G-Wiley/RK05_Emulator_Tester_System_v1/T1_M930GW_Terminator_Board/M930GW_Terminator_Board_v0/photos_and_images/M930GW v0 photo front.jpg

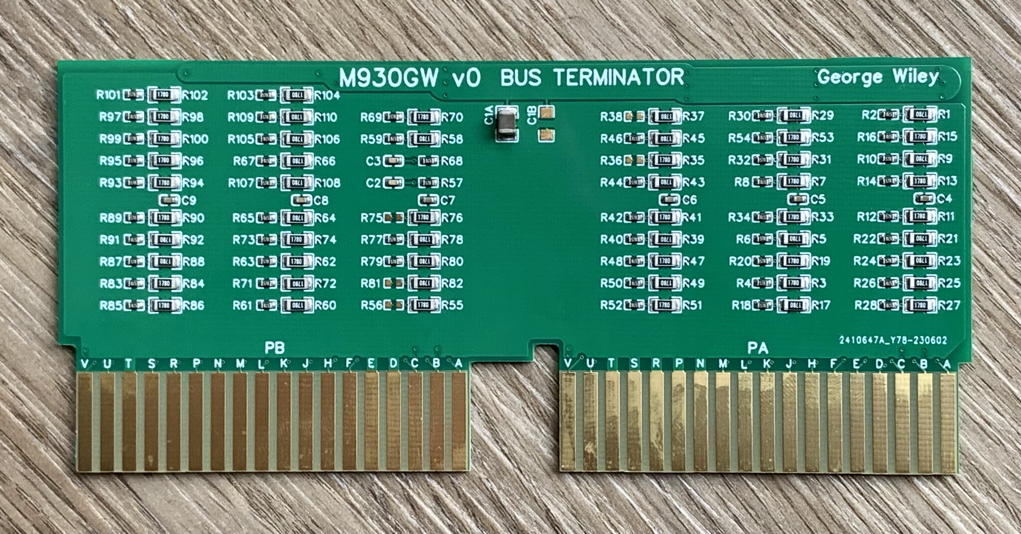
T1_M930GW_Terminator_Board/M930GW_Terminator_Board_v0/photos_and_images/M930GW v0 photo front.jpg
