G-Wiley/RK05_Emulator_Tester_System_v1/README.md

# RK05 Emulator and Tester System
The RK05 Emulator and Tester System
