G-Wiley/RK05_Emulator_Tester_System_v1/A7_RK05_Emulator_Power_Supply/README.md

# RK05 Emulator Power Supply

The RK05_Emulator_Power_Supply PCB is UPN 107 in the Bill of Materials.
