G-Wiley/RK05_Emulator_Tester_System_v1/Setting up the emulator.pdf

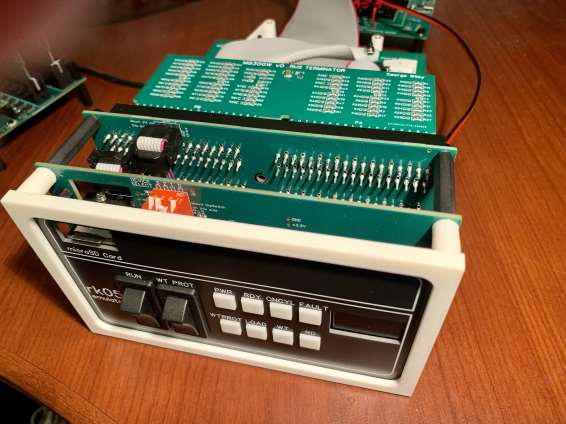
[picture p3: figure]

Seng up the emulator v04.docx | Page 1

Connecng the emulator to the Disk Controller:
- The order of the following setup steps isn’t important except to turn the power on as the last step.
- Plug in the terminator board and the RK05 bus interface cable. The two RK05 bus slots on the emulator are electrically the same so either board can go in either slot. The component side faces up. It’s easier to access the Adapter Board when the terminator board is installed in the top slot.

There is a keying slot between the two sets of gold contact fingers on both the terminator board and on the cable. There is a guide on the emulator main board silkscreen that shows the proper orientaon of this keying slot.
Silkscreen guide, corresponds to the keying slot

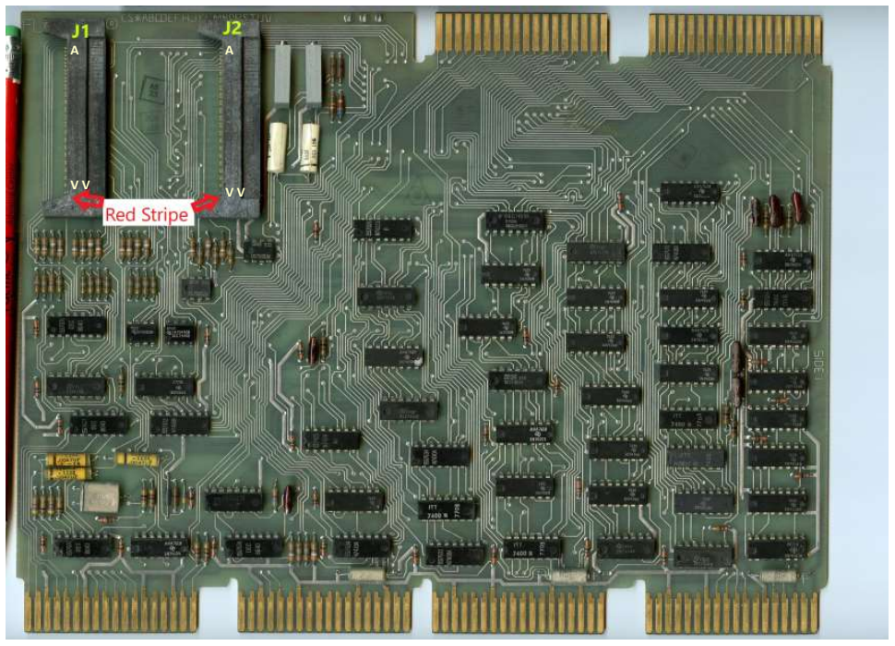
[picture p4: figure]

Seng up the emulator v04.docx | Page 2
- Connect the loose end of the flat cables from the M993GW Adapter Board to the DEC RK8-E M7106 connectors J1 and J2. Connect the flat cable from J1 on the M993GW Adapter Board to J1 on the M7106. Similarly, connect the flat cable from J2 on the M993GW adapter card to J2 on the M7106. It is helpful to use a permanent marker or other means to label the flat cables with “J1” and “J2” so it is clear which cable goes to which connector. If connecng to a DEC RK8-E, then the keying tabs on the flat cable connectors should be sanded off so they will fit into the DEC Berg connectors. A Dremel tool or sharp pair of flush cut diagonal cuers can also be used to remove the keying tabs. The pin numbering alignment is strange, as shown in the photo: 3M connector pin 1 (red stripe) corresponds to Berg pin VV, and 3M pin 40 corresponds to Berg pin
A. If the flat cables are connected to a Plessey PM-DC/8 controller then it is not necessary to sand off the keying tabs on the flat cables because the right-angle headers on the Plessey controller have corresponding keying slots.

DEC RK8-E

A

A

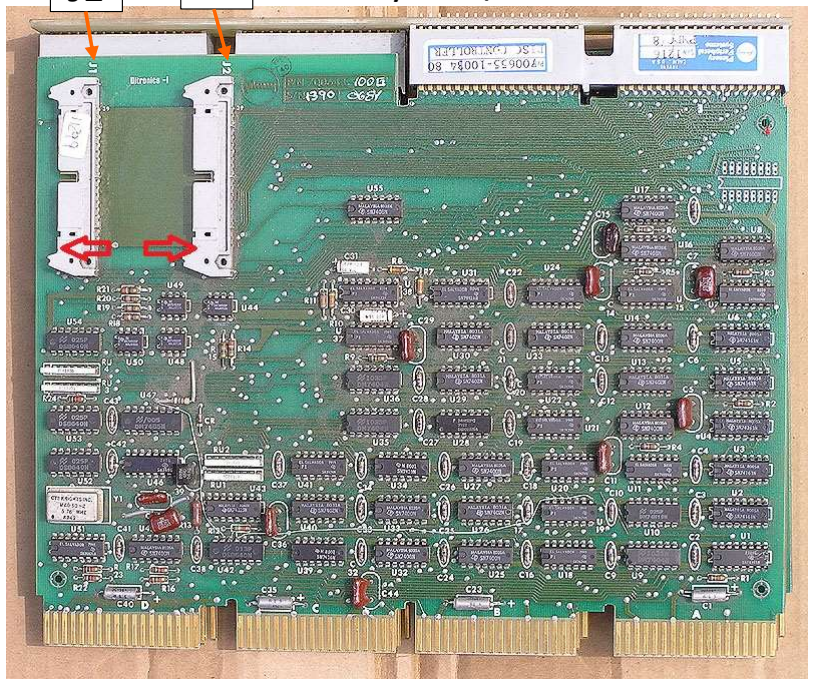
[picture p5: figure]

Seng up the emulator v04.docx | Page 3
- The Plessey PM-DC/8 has J1 and J2 clearly labelled on the silkscreen. Red arrows in the photo show the orientaon of the red stripe on the cable. The keying slots on the controller board headers and keying ribs on the cables also ensure that the orientaon of the cables and red stripe are correct.

Plessey PM-DC/8

J1 J2

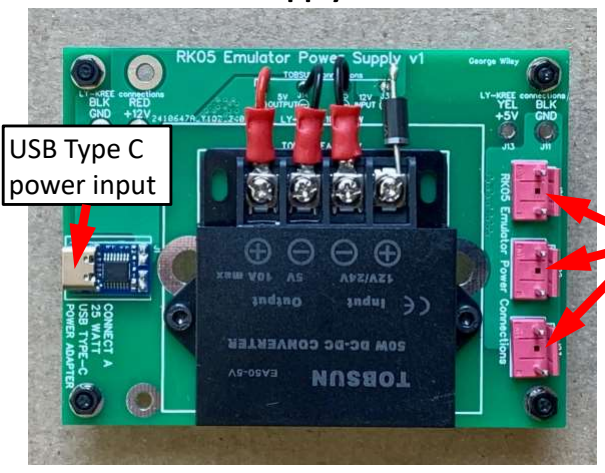
[picture p6: figure]
USB Type C power input
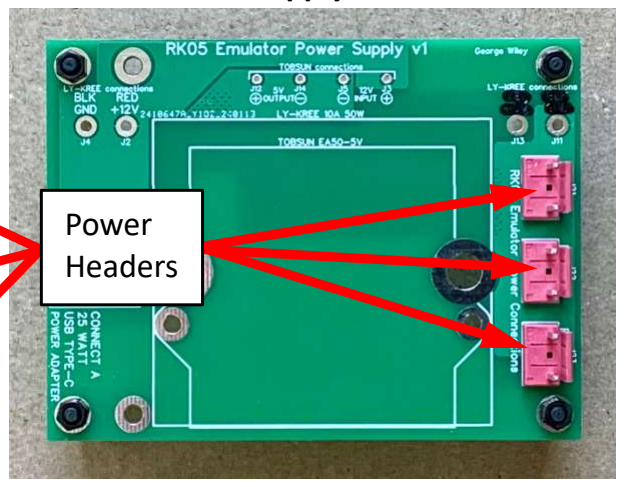
[picture p7: figure]
Power Headers
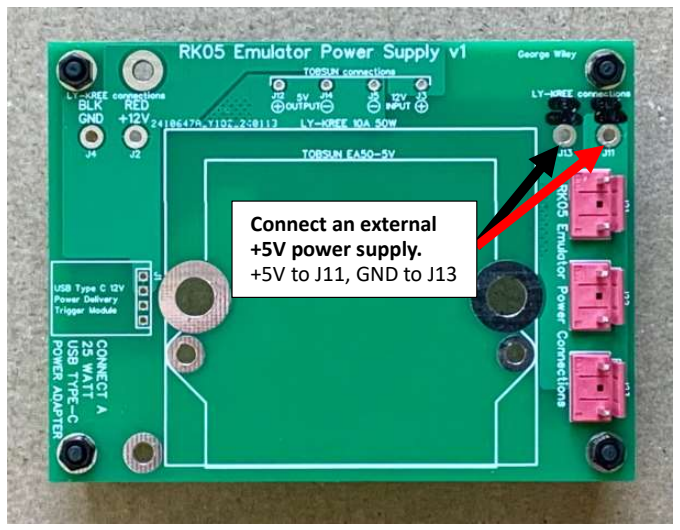
[picture p8: figure]
Connect an external +5V power supply. +5V to J11, GND to J13

Seng up the emulator v04.docx | Page 4
- Connect one end of the red/black power cable to the power header on the emulator. Connect the other end of the power cable to any one of the three power headers on either the Emulator Power Supply With Converters or Emulator Power Supply Without Converters. Up to three emulators can be powered from a single Power Supply.
Emulator Power Supply | Emulator Power Supply without Converters
- When using the Emulator Power Supply, connect a 25 wa USB Type C power module to the USB Type C connector on the Emulator Power Supply. Emulator Power Supply version v2 and higher have a power input switch located near the USB connector.
- When using the Emulator Power Supply without Converters, connect a user-provided 5-volt power supply to J11 (+5V) and J13 (GND).
- The following are important:
o Take care to observe the proper polarity when connecng the external supply.
o It is recommended to connect a red wire to J11 and a black wire to J13 as a guide to not mix up the polarity.
o Make a secure connecon to the Power Supply Board and to the external power supply.

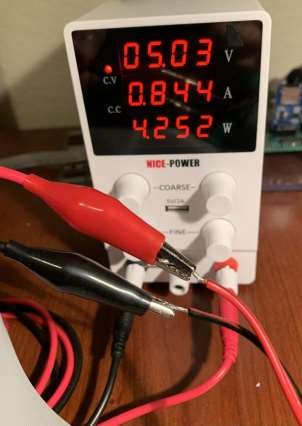
[picture p9: figure]

Seng up the emulator v04.docx | Page 5

o Use wire with a sufficiently large wire diameter to minimize voltage drop between the external power supply and the Power Supply Board.
o Verify the polarity using a voltmeter before connecng the RK05 Emulators to the Power Supply Board.
- Connect the other end of the wires from the Power Supply Board Without Converters to a +5V supply. One emulator with a terminator installed consumes about 900 mA when idle or 1000 mA while running (with lots of disk transfer acvity).

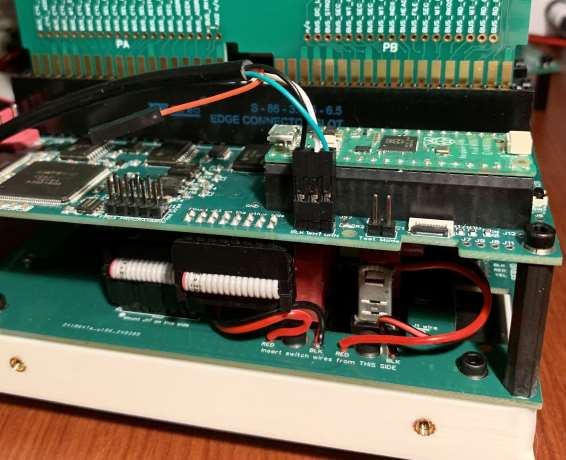
[picture p10: figure]

Seng up the emulator v04.docx | Page 6
- If it is necessary to observe the emulator event log data, then connect the USB serial cable as shown. The black wire is GND, white is TX, green is RX. The red wire on the cable is unconnected. The silkscreen on the main board indicates which wire color should connect to each of the three pins. Either a 5 volt or 3.3 volt USB serial cable can be used. With USB side of the serial cable plugged into in the computer, set your terminal emulator to use whichever COM port is assigned to the cable. Tip: bring up the Windows Device Manager first, then plug the USB cable into the computer to observe which COM port was just assigned when the USB serial cable was inserted. Baud rate is 460,800 bits per second, 8 bits, no parity. The high data rate is used so the serial port can keep up when logging sector reads and writes when the logging mode is selected.
- Set the RUN/LOAD switch on the front panel of the emulator to the “LOAD” posion.
- Turn on the external +5V power if the Power Supply Board Without Converters is being used or plug in the USB Type C charger and turn on the on-board power switch if the Power Supply Board with Converters is being used.
Using the Emulator:
- Insert a microSD card into the microSD slot accessible through the front panel. The card must have a valid rk05 file with an “rk05” file extension at the root level. Example rk05 files are provided in the emulator repository on github.
- The Drive Address can be set using the 4-posion dipswitch located behind the front panel. The dipswitch is idenfied as “DEVICE SELECT” on the board silkscreen next to the dipswitch. The individual switches are idenfied as 0 through 3 on the silkscreen. Switches 0 through 2 are a 3-bit binary drive address value. The selected Drive Address immediately appears in the OLED display on the front panel. The Drive Address seng is effecve only when the emulator is in the “LOAD” state.

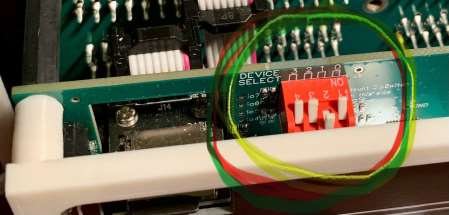
[picture p11: figure]

Seng up the emulator v04.docx | Page 7
- The following example shows the switches set to address 2. The switch on the right has binary weight of 2⁰

, the next switch to the le which is in a different state than the other switches is 2¹ ,
the next switch to the le is 2

2
, and the switch on the far le selects fixed mode (which is not yet implemented).

Although some drives use one-hot enables to select the drive, this address switch is always a binary representaon of the drive address. The large digit in the front panel display confirms the address that was selected.
- Aer the RUN/LOAD switch is turned to the RUN posion, the emulator will ignore the state of the dipswitches. Only drive addresses 0 through 3 are valid for PDP-8 RK8-E mode which uses individual select signals on the disk bus. Drive addresses 0-7 can be used in RK11-D/E modes which use a binary-encoded drive address on the disk bus. The disk controller drives a signal on the disk bus to select the proper mode for the controller. The most significant switch, switch 3, (the switch on the le) enables RK05f mode. RK05f mode is not yet supported; the proper double-address will appear in the display but the FPGA and soware do not yet support this mode. This is a planned future upgrade.
- Flip the RUN/LOAD switch to the “RUN” posion. The emulator will read the rk05 disk image file from the card and store the data in the emulator’s DRAM. Progress of reading the file will appear in the display. When the enre file has been read, the front panel LEDs will update to indicate RDY and ONCYL.
- To observe a log of RK05 bus events such as Seek, Restore, Read and Write: type “L” on the aached terminal (commands are case insensive). To stop logging type “S”. There is a bug which may cause the emulator to lock up aer receiving 5,000 to 10,000 bus events while logging. This problem does not occur when logging is off.
- To unload and save data from the emulator DRAM back to the microSD card, flip the RUN/LOAD switch back to the LOAD posion. Progress of wring the file will appear in the display. When the enre file has been wrien, the front panel LEDs will update to indicate LOAD.
- If there is an error, then it will show in the emulator front panel display and on the aached terminal and the ERROR LED will flash. The flashing error indicator can be cleared by first holding the WTPROT switch and then toggle the state of the RUN/LOAD switch.
