G-Wiley/RK05_Emulator_Tester_System_v1/A7_RK05_Emulator_Power_Supply/RK05_Emulator_Power_Supply_v1/RK05_Emulator_Power_Supply_v1_schematic.pdf

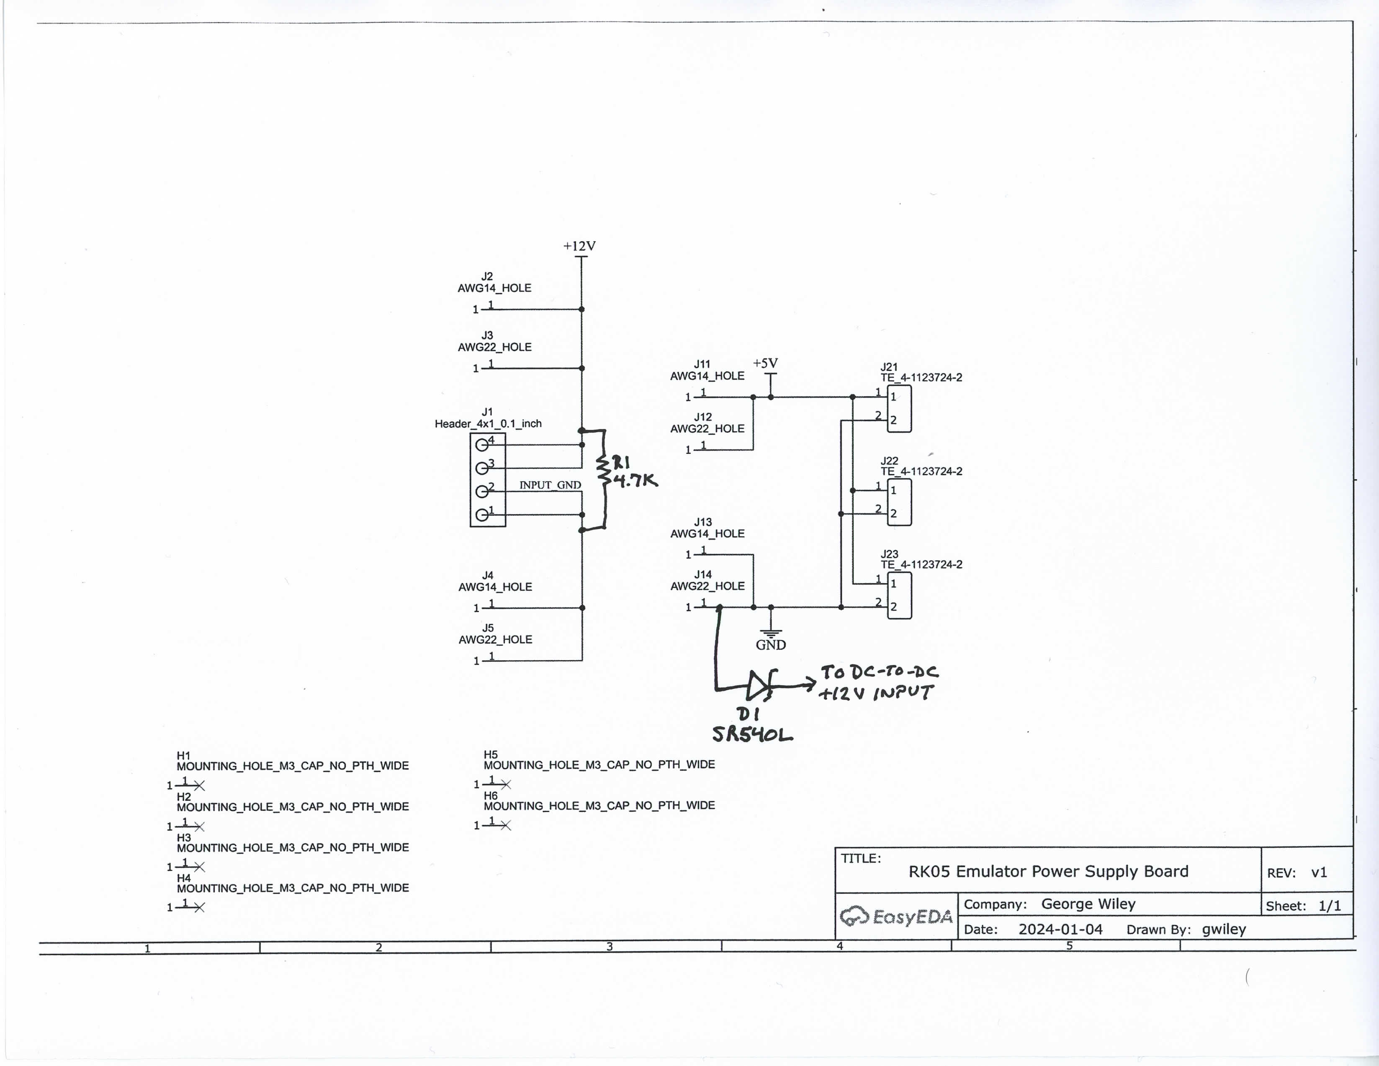
[picture p31: page 1]
