G-Wiley/RK05_Emulator_Tester_System_v1/E1_RK05_Emulator_Tester/Board_Front_Panel/RK05_Front_Panel v3/DNI_Components_Front_Panel_Electronics_v3_board_v00.txt

RK05 Emulator Front Panel Electronics v3, parts not added to BOM
Schematic Page 1
J1
J2
J3
J4
J6
J7 (3-pin header, servo)
J9
J10
J11
J12
J13
J14
J15
J16
J17 (16-pin header, main board)
H1 to H14
R6
R18
SW2
U5 (display module)
