G-Wiley/RK05_Emulator_Tester_System_v1/E1_RK05_Emulator_Tester/3D_printed_parts/204_sd_card_carrier_secondary_ops.pdf

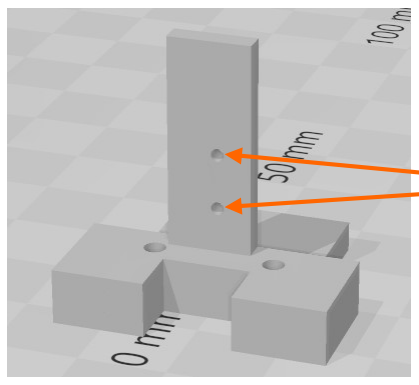
[picture p36: figure]
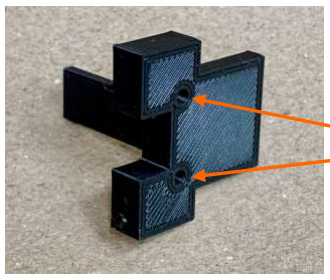
[picture p37: figure]
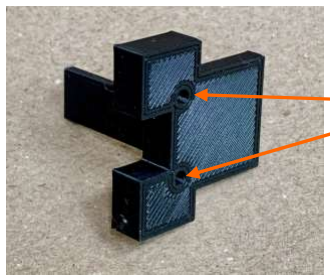
[picture p38: figure]

204_sd_card_carrier_secondary_ops_v00.docx | page 1

Secondary operations, microSD Card Carrier

After 3D printing, the microSD Card Carrier, item 204, needs the following secondary operations to be the fully completed part that can be attached to the front panel assembly.
- Drill holes in the 3D printed piece in 2 places to produce a finished hole size of 3.2 mm.
- Drill holes in the 3D printed piece in 2 places to produce a finished hole size of 3.0 mm. It is better to drill these holes from the flat surface most visible in the image below.
- Heat-stake M2 Threaded Inserts (UPN 311) in holes in the 3D printed piece in 2 places. A soldering iron set to 350° C with a pointed tip or a heat-staking tip can be used to gently press the threaded inserts into place.

Drill for 3.2 mm finished hole size.

Drill for 3.0 mm finished hole size.

Heat-stake M2 Threaded Inserts (UPN 311).
