G-Wiley/RK05_Emulator_Tester_System_v1/E1_RK05_Emulator_Tester/3D_printed_parts/205_M993_Cable_Clamp_secondary_ops.pdf

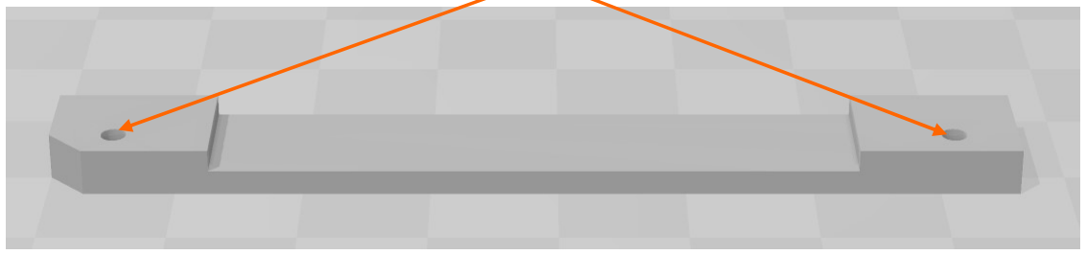
[picture p39: figure]

205_M993_Cable_Clamp_secondary_ops_v00.docx | page 1

Secondary operations, Cable Clamp

After 3D printing, the Cable Clamp, item 205, needs the following secondary operations to be the fully completed part that can be installed on the M993GW RK05 Adapter Board.
- Drill holes in the 3D printed piece in 2 places to produce a finished hole size of 3.2 mm.

Drill for 3.2 mm finished hole size.
