G-Wiley/RK05_Emulator_Tester_System_v1/RK05 emulator bill of materials v1 BOM inventory v09a.xlsx

Sheet: Bill of Materials
 |  |  |  | Qty | UPN |  |  | Description | Ver | Manufacturer | Manufacturer's part number | Supplier | Link | cost ea | ext cost
RK05 Emulator/Tester |  |  |  |  |  |  |  |  |  |  |  |  |  |  | TOTAL
E1 | RK05 Emulator/Tester |  |  |  |  |  |  |  |  |  |  |  |  |  | Emulator/Tester Total | $83.90 | $84
 |  |  |  | Qty | UPN |  | bag | Description | Ver | Manufacturer | Manufacturer's part number | Supplier | Link | cost ea | ext cost
 | RK05 Emulator Top Level Assembly |  |  |  |  |  |  |  |  |  |  |  |  |  |  | $17.454
 |  |  |  | 1 | 200 |  | A | RK05 Lamp Lens, 3D printed | v03 |  | 200 v03 | JLCPCB | 200 v03, SLA (Resin), LEDO 6060, Natural White | $1.697 | $1.697
 |  |  |  | 1 | 201 |  | B | RK05em Bezel, 3D printed | v05 |  | 201 v05 | JLCPCB | 201 v05, FDM (Plastic), PLA, White | $4.992 | $4.992
 |  |  |  | 1 | 207 |  | A | Light Shield, 3D printed | v00 |  | 207 v03 | JLCPCB | 207 v03, SLA (Resin), LEDO 6060, Natural White + blk paint | $0.425 | $0.425
 |  |  |  | 1 | 103 |  | C | RK05 Emulator Dress Panel | v00 |  |  | JLCPCB | Surface Finish: LeadFree HASL | $3.133 | $3.133
 |  |  |  | 6 | 300 |  | B | Threaded Insert, M3 x L=6 x OD=4.5 |  |  |  | AliExpress | https://www.aliexpress.us/item/3256805885174058.html | $0.037 | $0.222
 |  |  |  | 0 | 301 |  | D | M3 Threaded Spacer, hex, nylon, black, 25mm + 6mm, female-male |  |  |  | AliExpress | https://www.aliexpress.us/item/3256804121267045.html | $0.081 | $0.000
 |  |  |  | 4 | 369 |  | D | M3 Threaded Spacer, hex, nylon, black, 30mm + 6mm, female-male |  |  |  | AliExpress | https://www.aliexpress.us/item/3256804121267045.html | $0.099 | $0.397
 |  |  |  | 1 | 303 |  | A | Rocker switch, on-mom |  |  | R4EBLKBLKEF0 | Digikey | https://www.digikey.com/en/products/detail/e-switch/R4EBLKBLKEF0/1805289 | $2.065 | $2.065
 |  |  |  | 1 | 304 |  | A | Rocker switch, on-off |  |  | R4ABLKBLKEF0 | Digikey | https://www.digikey.com/en/products/detail/e-switch/R4ABLKBLKEF0/1805255 | $1.356 | $1.356
 |  |  |  | 4 | 331 |  | D | M3 screw, hex, 8 mm, black |  |  |  | AliExpress | https://www.aliexpress.us/item/3256805242052170.html | $0.035 | $0.139
 |  |  |  | 4 | 332 |  | D | M3 split lockwasher |  |  |  | Amazon | https://www.amazon.com/gp/product/B07Z2FJ2XW | $0.022 | $0.086
 |  |  |  | 1 | 347 |  | N | Flat Cable, 8-pin 2x4 IDC, 10cm |  |  |  | AliExpress | https://www.aliexpress.us/item/3256803248238815.html | $1.170 | $1.170
 |  |  |  | 1 | 348 |  | N | Flat Cable, 16-pin 2x8 IDC, 10cm |  |  |  | AliExpress | https://www.aliexpress.us/item/3256803248238815.html | $1.330 | $1.330
 |  |  |  | 10 | 364 |  | - | 3" x 5" Small Plastic Bags- Reclosable Zip Bags |  |  |  | Amazon | https://www.amazon.com/gp/product/B07XBF98NV | $0.019 | $0.194
 |  |  |  | 1 | 368 |  | - | Ziplock Sandwich Bag |  |  |  | Costco |  | $0.000 | $0.000
 | Tray Rack Mount Kit for Emulator
 |  |  |  | 2 | 358 |  | L | Fender Washer, M3x16x1.0 mm |  |  |  | AliExpress | https://www.aliexpress.us/item/3256802393168670.html | $0.068 | $0.135
 |  |  |  | 2 | 331 |  | L | M3 screw, hex, 8 mm, black |  |  |  | AliExpress | https://www.aliexpress.us/item/3256805242052170.html | $0.035 | $0.069
 |  |  |  | 2 | 332 |  | L | M3 split lockwasher |  |  |  | Amazon | https://www.amazon.com/gp/product/B07Z2FJ2XW | $0.022 | $0.043
 | Emulator Main Board |  |  |  |  |  |  |  |  |  |  |  |  |  |  | $50.654
 |  |  |  | 1 | 341 | J14 | E | CONN HEADER VERT 2x4 Pos, 2.54mm |  |  |  | AliExpress | https://www.aliexpress.us/item/3256805773340189.html | $0.068 | $0.068
 |  |  |  | 1 | 342 | J13 | E | CONN HEADER VERT 2x8 Pos, 2.54mm |  |  |  | AliExpress | https://www.aliexpress.us/item/3256805773340189.html | $0.129 | $0.129
 |  |  |  | 1 | 345 | J1 | E | CONN HEADER VERT 2x5 Pos, 2.54mm |  |  |  | AliExpress | https://www.aliexpress.us/item/3256805773340189.html | $0.081 | $0.081
 |  |  |  | 2 | 344 | U22A, U22B | E | Connector, 20-pin single row, socket strip, 2.54mm |  |  |  | AliExpress | https://www.aliexpress.us/item/3256803424019097.html | $0.512 | $1.024
 |  |  |  | 1 | 309 | U22 | P | Raspberry Pi Pico H (SC0917), with pre-soldered headers |  |  |  | Digikey | https://www.digikey.com/en/products/detail/raspberry-pi/SC0917/16608257 | $6.087 | $6.087
 |  |  |  | 1 | 310 |  | E | Single Row 40 Pin 2.54 mm Male Pin Header Connector, cut to 3 pins |  |  |  | Amazon | https://www.amazon.com/gp/product/B06XR8CV8P | $0.016 | $0.016
 |  |  |  | 1 | 340 | J3 | E | CONN HEADER VERT 3POS, 3.96MM |  | TE Connectivity AMP Connectors | 4-1123724-2 | Digikey | https://www.digikey.com/en/products/detail/te-connectivity-amp-connectors/4-1123724-2/5439777 | $0.148 | $0.148
 |  |  |  | 1 | 338 |  | G' | Antistatic bag, 15x20 cm |  |  |  | Amazon | https://www.amazon.com/dp/B07TXD47PZ | $0.166 | $0.166
 |  |  |  | 1 | 367 |  | P' | Antistatic bag, 6x9 cm |  |  |  | AliExpress | https://www.aliexpress.us/item/3256802834769879.html | $0.085 | $0.085
 |  | Modified edge connector
 |  |  |  | 2 | 313 | J7, J8 | M | edge connector, 1PCS, 3.175mm, 2x43 86 pin |  |  |  | AliExpress | https://www.aliexpress.us/item/2255801094078491.html | $3.371 | $6.742
 |  |  |  | 1 | 202 |  | E | RK05em connector filler/shim, 3D printed | v05 |  | 202 v05 | JLCPCB | 200 v03, SLA (Resin), LEDO 6060, Natural White | $1.070 | $1.070
 |  | Emulator Main Board Assembled
 |  |  |  | 1 | 100 |  | G | Emulator Main Board assembled | v1 |  |  | JLCPCB | Surface Finish: LeadFree HASL | $33.939 | $33.939
 |  | Main Board Power Cable
 |  |  |  | 2 | 312 |  | E | connector, 3-pin, 3.96 EP PLUG HSG 3P(BLACK) |  | TE Connectivity AMP Connectors | 5-1123722-3 | Digikey | https://www.digikey.com/en/products/detail/te-connectivity-amp-connectors/5-1123722-3/10467997 | $0.099 | $0.199
 |  |  |  | 4 | 339 |  | E | CONN SOCKET Pin, 18-22AWG, crimp tin |  | TE Connectivity AMP Connectors | 1123721-2 | Digikey | https://www.digikey.com/en/products/detail/te-connectivity-amp-connectors/1123721-2/686921 | $0.176 | $0.706
 |  |  |  | 1 | 346 |  | E | 22AWG 2 Conductor, Low-Voltage Tinned-Copper Wire, 12-inch (30.5 cm) |  |  |  | Amazon | https://www.amazon.com/dp/B07SCJ69H4 | $0.196 | $0.196
 | Emulator Front Panel Board |  |  |  |  |  |  |  |  |  |  |  |  |  |  | $15.792
 |  |  |  | 2 | 315 |  | F | M2 x 8mm screw, steel |  |  |  | Amazon | https://www.amazon.com/gp/product/B01M5DVI7A | $0.090 | $0.179
 |  |  |  | 1 | 342 |  | H | CONN HEADER VERT 2x8 Pos, 2.54mm |  |  |  | AliExpress | https://www.aliexpress.us/item/3256805773340189.html | $0.129 | $0.129
 |  |  |  | 1 | 317 |  | H | dipswitch, right angle, 4-switch piano type |  | ALINSIN STORE |  | AliExpress | https://www.aliexpress.us/item/3256803055482916.html | $0.435 | $0.435
 |  |  |  | 2 | 318 |  | H | 22AWG 2 Conductor, Low-Voltage Tinned-Copper Wire, 3.5 inch |  |  |  | Amazon | https://www.amazon.com/dp/B07SCJ69H4 | $0.057 | $0.114
 |  |  |  | 4 | 319 |  | H | Nylon Flag Spade Quick Disconnect, 22-18 AWG |  |  |  | Amazon | https://www.amazon.com/dp/B0C625XHQM | $0.086 | $0.344
 |  |  |  | 1 | 343 |  | H | Connector, 4-pin single Row, socket strip, 2.54mm |  |  |  | AliExpress | https://www.aliexpress.us/item/3256803424019097.html | $0.099 | $0.099
 |  |  |  | 0 | 321 |  | F | M2 Phillips Round Pan Head Machine Screws (M2 x 4mm), Stainless Steel |  |  |  | Amazon | https://www.amazon.com/gp/product/B07HFYZ9YM | $0.086 | $0.000
 |  |  |  | 2 | 322 |  | F | M2 split lockwasher |  |  |  | Amazon | https://www.amazon.com/gp/product/B09LLZHY87 | $0.023 | $0.045
 |  |  |  | 1 | 323 |  | H | OLED display module, 128x64, 0.96 inch |  |  |  | AliExpress | https://www.aliexpress.us/item/3256805094941943.html | $1.605 | $1.605
 |  |  |  | 2 | 324 |  | F | M2 Threaded Spacer, hex, nylon, black, 10mm, female-female |  |  |  | AliExpress | https://www.aliexpress.us/item/3256805464087324.html | $0.045 | $0.089
 |  |  |  | 2 | 325 |  | F | M2 nylon flat washer |  |  |  | Amazon | https://www.amazon.com/uxcell-Insulating-Washers-Gaskets-Spacers/dp/B01N6B5KJN | $0.038 | $0.075
 |  |  |  | 8 | 326 |  | F | M3 Threaded Spacer, hex, nylon, black, 12mm, female-female |  |  |  | Amazon | https://www.amazon.com/gp/product/B072LGMRVD | $0.068 | $0.540
 |  |  |  | 8 | 327 |  | F | M3 screw, hex, 6 mm, black |  |  |  | AliExpress | https://www.aliexpress.us/item/3256805242052170.html | $0.030 | $0.238
 |  |  |  | 2 | 331 |  | F | M3 screw, hex, 8 mm, black |  |  |  | AliExpress | https://www.aliexpress.us/item/3256805242052170.html | $0.035 | $0.069
 |  |  |  | 2 | 328 |  | F | M3 self locking nut |  |  |  | Amazon | https://www.amazon.com/Stainless-Self-Locking-Industrial-Construction-Fasteners/dp/B09SLLQ3KV | $0.055 | $0.109
 |  |  |  | 12 | 329 |  | F | Self-Adhesive Clear Rubber Feet, 6mm dia x 2mm thick |  |  |  | Amazon | https://www.amazon.com/gp/product/B073ST7Q27 | $0.014 | $0.171
 |  |  |  | 1 | 338 |  | J' | Antistatic bag, 15x20 cm |  |  |  | Amazon | https://www.amazon.com/dp/B07TXD47PZ | $0.166 | $0.166
 |  | Emulator Front Panel Board Assembled
 |  |  |  | 1 | 101 |  | J | Front Panel board assembled | v3 |  |  | JLCPCB | Surface Finish: LeadFree HASL | $7.470 | $7.470
 |  | microSD Card Carriage Assembly
 |  |  |  | 1 | 204 |  | K | microSD card carrier bracket, 3D printed | v20 |  | 204 v20 | JLCPCB | 204 v20, FDM (Plastic), PLA, Black | $2.062 | $2.062
 |  |  |  | 2 | 311 |  | K | Threaded Insert, M2 |  |  |  | Amazon | https://www.amazon.com/gp/product/B0B8GN63S2 | $0.093 | $0.185
 |  |  |  | 2 | 321 |  | K2 | M2 Phillips Round Pan Head Machine Screws (M2 x 4mm), Stainless Steel |  |  |  | Amazon | https://www.amazon.com/gp/product/B07HFYZ9YM | $0.086 | $0.172
 |  |  |  | 2 | 322 |  | K2 | M2 split lockwasher |  |  |  | Amazon | https://www.amazon.com/gp/product/B09LLZHY87 | $0.023 | $0.045
 |  |  |  | 1 | 341 | J14 | K | CONN HEADER VERT 2x4 Pos, 2.54mm |  |  |  | AliExpress | https://www.aliexpress.us/item/3256805773340189.html | $0.068 | $0.068
 |  |  | microSD card adapter board, assembled
 |  |  |  | 1 | 102 |  | K | microSD card adapter board, assembled | v1 |  |  | JLCPCB | Surface Finish: LeadFree HASL | $1.380 | $1.380
RK05 Emulator Accessories
T1 | M930GW Terminator Board |  |  |  |  |  |  |  |  |  |  |  |  |  |  | $8.55 | $9
 |  |  |  | 1 | 104 |  | T1 | M930GW Terminator Board, assembled | v0 |  |  | JLCPCB | M930GW_Terminator_Board_ordering_instructions.pdf | $8.389 | $8.389
 |  |  |  | 1 | 338 |  | T1' | Antistatic bag, 15x20 cm |  |  |  | Amazon | https://www.amazon.com/dp/B07TXD47PZ | $0.166 | $0.166
A1 | RK05-to-RK8-E Cable, 1 meter length |  |  |  |  |  |  |  |  |  |  |  |  |  |  | $21.20 | $22
 |  |  |  | 1 | 105 |  | BE | PCB, M993GW RK05 Adapter Board | v2 |  |  | JLCPCB | Surface Finish: ENIG | $5.676 | $5.676
 |  |  |  | 1 | 368 |  | BE' | Ziplock Sandwich Bag |  |  |  | Costco |  | $0.000 | $0.000
 |  |  |  | 2 | 336 |  | T | Header, 40-pin, right-angle, with ejectors |  | Amphenol ICC (FCI) | 86130402113345E1LF | Digikey | https://www.digikey.com/en/products/detail/amphenol-cs-fci/86130402113345E1LF/5201672 | $1.790 | $3.580
 |  |  |  | 2 | 349 |  | C1 | Flat Cable, 40-pin 2x20 IDC, 1m |  |  |  | AliExpress | https://www.aliexpress.us/item/3256803248238815.html | $5.502 | $11.004
 |  |  |  | 1 | 205 |  | T | M993GW Cable Clamp, 3D printed | v03 |  | 205 v03 | JLCPCB | 200 v03, SLA (Resin), LEDO 6060, Natural White | $0.619 | $0.619
 |  |  |  | 2 | 334 |  | T | M3 x 12mm cap screw, black |  |  |  | Amazon | https://www.amazon.com/gp/product/B07CNFTK99 | $0.085 | $0.169
 |  |  |  | 2 | 328 |  | T | M3 self locking nut |  |  |  | Amazon | https://www.amazon.com/Stainless-Self-Locking-Industrial-Construction-Fasteners/dp/B09SLLQ3KV | $0.055 | $0.109
 |  |  |  | 2 | 364 |  | T' | 3" x 5" Small Plastic Bags- Reclosable Zip Bags |  |  |  | Amazon | https://www.amazon.com/gp/product/B07XBF98NV | $0.019 | $0.039
A2 | RK05-to-RK05 Cable, 1 meter length |  |  |  |  |  |  |  |  |  |  |  |  |  |  | $31.35 | $32
 |  |  |  | 2 | 105 |  | BE2 | PCB, M993GW RK05 Adapter Board | v2 |  |  | JLCPCB | Surface Finish: ENIG | $5.676 | $11.352
 |  |  |  | 1 | 368 |  | BE2' | Ziplock Sandwich Bag |  |  |  | Costco |  | $0.000 | $0.000
 |  |  |  | 4 | 336 |  | T2 | Header, 40-pin, right-angle, with ejectors |  | Amphenol ICC (FCI) | 86130402113345E1LF | Digikey | https://www.digikey.com/en/products/detail/amphenol-cs-fci/86130402113345E1LF/5201672 | $1.790 | $7.160
 |  |  |  | 2 | 349 |  | C1 | Flat Cable, 40-pin 2x20 IDC, 1m |  |  |  | AliExpress | https://www.aliexpress.us/item/3256803248238815.html | $5.502 | $11.004
 |  |  |  | 2 | 205 |  | T2 | M993GW Cable Clamp, 3D printed | v03 |  | 205 v03 | JLCPCB | 200 v03, SLA (Resin), LEDO 6060, Natural White | $0.619 | $1.237
 |  |  |  | 4 | 334 |  | T2 | M3 x 12mm cap screw, black |  |  |  | Amazon | https://www.amazon.com/gp/product/B07CNFTK99 | $0.085 | $0.339
 |  |  |  | 4 | 328 |  | T2 | M3 self locking nut |  |  |  | Amazon | https://www.amazon.com/Stainless-Self-Locking-Industrial-Construction-Fasteners/dp/B09SLLQ3KV | $0.055 | $0.218
 |  |  |  | 2 | 364 |  | T2' | 3" x 5" Small Plastic Bags- Reclosable Zip Bags |  |  |  | Amazon | https://www.amazon.com/gp/product/B07XBF98NV | $0.019 | $0.039
A3 | RK05-to-RK05 Cable, Side-to-Side, 20cm length |  |  |  |  |  |  |  |  |  |  |  |  |  |  | $22.81 | $23
 |  |  |  | 2 | 105 |  | BE2 | PCB, M993GW RK05 Adapter Board | v2 |  |  | JLCPCB | Surface Finish: ENIG | $5.676 | $11.352
 |  |  |  | 1 | 368 |  | BE2' | Ziplock Sandwich Bag |  |  |  | Costco |  | $0.000 | $0.000
 |  |  |  | 4 | 336 |  | R2 | Header, 40-pin, right-angle, with ejectors |  | Amphenol ICC (FCI) | 86130402113345E1LF | Digikey | https://www.digikey.com/en/products/detail/amphenol-cs-fci/86130402113345E1LF/5201672 | $1.790 | $7.160
 |  |  |  | 1 | 361 |  | C2 | Flat Cable, 40-pin 2x20 IDC, 30cm |  |  |  | AliExpress | https://www.aliexpress.us/item/3256803248238815.html | $2.129 | $2.129
 |  |  |  | 1 | 370 |  | C2 | Flat Cable, 40-pin 2x20 IDC, 20cm |  |  |  | AliExpress | https://www.aliexpress.us/item/3256803248238815.html | $2.129 | $2.129
 |  |  |  | 2 | 364 |  | R2' | 3" x 5" Small Plastic Bags- Reclosable Zip Bags |  |  |  | Amazon | https://www.amazon.com/gp/product/B07XBF98NV | $0.019 | $0.039
A4 | RK05 Adapter Board without flat cables |  |  |  |  |  |  |  |  |  |  |  |  |  |  | $10.19 | $11
 |  |  |  | 1 | 105 |  | BE | PCB, M993GW RK05 Adapter Board | v2 |  |  | JLCPCB | Surface Finish: ENIG | $5.676 | $5.676
 |  |  |  | 1 | 368 |  | BE' | Ziplock Sandwich Bag |  |  |  | Costco |  | $0.000 | $0.000
 |  |  |  | 2 | 336 |  | T | Header, 40-pin, right-angle, with ejectors |  | Amphenol ICC (FCI) | 86130402113345E1LF | Digikey | https://www.digikey.com/en/products/detail/amphenol-cs-fci/86130402113345E1LF/5201672 | $1.790 | $3.580
 |  |  |  | 1 | 205 |  | T | M993GW Cable Clamp, 3D printed | v03 |  | 205 v03 | JLCPCB | 200 v03, SLA (Resin), LEDO 6060, Natural White | $0.619 | $0.619
 |  |  |  | 2 | 334 |  | T | M3 x 12mm cap screw, black |  |  |  | Amazon | https://www.amazon.com/gp/product/B07CNFTK99 | $0.085 | $0.169
 |  |  |  | 2 | 328 |  | T | M3 self locking nut |  |  |  | Amazon | https://www.amazon.com/Stainless-Self-Locking-Industrial-Construction-Fasteners/dp/B09SLLQ3KV | $0.055 | $0.109
 |  |  |  | 2 | 364 |  | T' | 3" x 5" Small Plastic Bags- Reclosable Zip Bags |  |  |  | Amazon | https://www.amazon.com/gp/product/B07XBF98NV | $0.019 | $0.039
A5 | RK05-to-Tester Cable, 1 meter length |  |  |  |  |  |  |  |  |  |  |  |  |  |  | $31.35 | $32
 |  |  |  | 1 | 105 |  | BE | PCB, M993GW RK05 Adapter Board | v2 |  |  | JLCPCB | Surface Finish: ENIG | $5.676 | $5.676
 |  |  |  | 1 | 368 |  | BE' | Ziplock Sandwich Bag |  |  |  | Costco |  | $0.000 | $0.000
 |  |  |  | 1 | 106 |  | BT' | PCB, RK05 Tester Cable Adapter Board | v1 |  |  | JLCPCB | Surface Finish: ENIG | $5.676 | $5.676
 |  |  |  | 1 | 368 |  | BT' | Ziplock Sandwich Bag |  |  |  | Costco |  | $0.000 | $0.000
 |  |  |  | 4 | 336 |  | T | Header, 40-pin, right-angle, with ejectors |  | Amphenol ICC (FCI) | 86130402113345E1LF | Digikey | https://www.digikey.com/en/products/detail/amphenol-cs-fci/86130402113345E1LF/5201672 | $1.790 | $7.160
 |  |  |  | 2 | 349 |  | C1 | Flat Cable, 40-pin 2x20 IDC, 1m |  |  |  | AliExpress | https://www.aliexpress.us/item/3256803248238815.html | $5.502 | $11.004
 |  |  |  | 2 | 205 |  | T | M993GW Cable Clamp, 3D printed | v03 |  | 205 v03 | JLCPCB | 200 v03, SLA (Resin), LEDO 6060, Natural White | $0.619 | $1.237
 |  |  |  | 4 | 334 |  | T | M3 x 12mm cap screw, black |  |  |  | Amazon | https://www.amazon.com/gp/product/B07CNFTK99 | $0.085 | $0.339
 |  |  |  | 4 | 328 |  | T | M3 self locking nut |  |  |  | Amazon | https://www.amazon.com/Stainless-Self-Locking-Industrial-Construction-Fasteners/dp/B09SLLQ3KV | $0.055 | $0.218
 |  |  |  | 2 | 364 |  | T' | 3" x 5" Small Plastic Bags- Reclosable Zip Bags |  |  |  | Amazon | https://www.amazon.com/gp/product/B07XBF98NV | $0.019 | $0.039
A6 | RK05 Tester Adapter Board without flat cables |  |  |  |  |  |  |  |  |  |  |  |  |  |  | $10.19 | $11
 |  |  |  | 1 | 106 |  | BT | PCB, RK05 Tester Cable Adapter Board | v1 |  |  | JLCPCB | Surface Finish: ENIG | $5.676 | $5.676
 |  |  |  | 1 | 368 |  | BT' | Ziplock Sandwich Bag |  |  |  | Costco |  | $0.000 | $0.000
 |  |  |  | 2 | 336 |  | T | Header, 40-pin, right-angle, with ejectors |  | Amphenol ICC (FCI) | 86130402113345E1LF | Digikey | https://www.digikey.com/en/products/detail/amphenol-cs-fci/86130402113345E1LF/5201672 | $1.790 | $3.580
 |  |  |  | 1 | 205 |  | T | M993GW Cable Clamp, 3D printed | v03 |  | 205 v03 | JLCPCB | 200 v03, SLA (Resin), LEDO 6060, Natural White | $0.619 | $0.619
 |  |  |  | 2 | 334 |  | T | M3 x 12mm cap screw, black |  |  |  | Amazon | https://www.amazon.com/gp/product/B07CNFTK99 | $0.085 | $0.169
 |  |  |  | 2 | 328 |  | T | M3 self locking nut |  |  |  | Amazon | https://www.amazon.com/Stainless-Self-Locking-Industrial-Construction-Fasteners/dp/B09SLLQ3KV | $0.055 | $0.109
 |  |  |  | 2 | 364 |  | T' | 3" x 5" Small Plastic Bags- Reclosable Zip Bags |  |  |  | Amazon | https://www.amazon.com/gp/product/B07XBF98NV | $0.019 | $0.039
A7 | Power Supply for 3 Emulators (version v1) |  |  |  |  |  |  |  |  |  |  |  |  |  |  | $15.93 | $16
 |  |  |  | 1 | 107 |  | BP | PCB, RK05 Emulator Power Supply | v1 |  |  | JLCPCB | PCB Color: Black, Surface Finish: LeadFree HASL, Remove Order Number: Specify a location | $1.970 | $1.970
 |  |  |  | 1 | 368 |  | BP' | Ziplock Sandwich Bag |  |  |  | Costco |  | $0.000 | $0.000
 |  |  |  | 1 | 363 |  | CH | USB Type C Charger, 25W, with USB C to USB C 6 foot cable |  |  |  | Amazon | https://www.amazon.com/dp/B097MVXSQ5 | $5.377 | $5.377
 |  |  |  | 1 | 364 |  | CH' | 3" x 5" Small Plastic Bags- Reclosable Zip Bags |  |  |  | Amazon | https://www.amazon.com/gp/product/B07XBF98NV | $0.019 | $0.019
 |  |  |  | 1 | 351 |  | S1 | Power Trigger Module, USB Type C, 12V |  |  |  | AliExpress | https://www.aliexpress.us/item/3256802974608811.html | $0.834 | $0.834
 |  |  |  | 1 | 367 |  | S1' | Antistatic bag, 6x9 cm |  |  |  | AliExpress | https://www.aliexpress.us/item/3256802834769879.html | $0.085 | $0.085
 |  |  |  | 1 | 359 |  | S2 | DC-to-DC Converter, 12V input to 5V 10A output |  | TOBSUN | EA50-5V | AliExpress | https://www.aliexpress.us/item/3256804612946913.html | $5.096 | $5.096
 |  |  |  | 1 | 371 |  | S | Rectifier, 40V 450mV@5A 5A DO-27 Schottky Barrier Diode |  | Comchip | SR540L | AliExpress | https://www.aliexpress.us/item/3256805591615901.html | $0.247 | $0.247
 |  |  |  | 1 | 372 |  | S | Resistor, 4.7k, 1/4W 5% |  |  |  | AliExpress | https://www.aliexpress.us/item/3256805483572082.html | $0.030 | $0.030
 |  |  |  | 1 | 368 |  | S2' | Ziplock Sandwich Bag |  |  |  | Costco |  | $0.000 | $0.000
 |  |  |  | 2 | 360 |  | S | 22AWG 2 Conductor, Low-Voltage Tinned-Copper Wire, 1.5 inch |  |  |  | Amazon | https://www.amazon.com/dp/B07SCJ69H4 | $0.003 | $0.006
 |  |  |  | 4 | 362 |  | S | Spade Lug, Fork, 16-22AWG, SV1.25-4, Red |  |  |  | AliExpress | https://www.aliexpress.us/item/2251832658426440.html | $0.024 | $0.095
 |  |  |  | 3 | 340 | J21, J22, J23 | S | CONN HEADER VERT 3POS, 3.96MM |  | TE Connectivity AMP Connectors | 4-1123724-2 | Digikey | https://www.digikey.com/en/products/detail/te-connectivity-amp-connectors/4-1123724-2/5439777 | $0.148 | $0.443
 |  |  |  | 1 | 352 |  | S | Single Row 40 Pin 2.54 mm Male Pin Header Connector, cut to 4 pins |  |  |  | Amazon | https://www.amazon.com/gp/product/B06XR8CV8P | $0.022 | $0.022
 |  |  |  | 2 | 331 |  | S | M3 screw, hex, 8 mm, black |  |  |  | AliExpress | https://www.aliexpress.us/item/3256805242052170.html | $0.035 | $0.069
 |  |  |  | 2 | 328 |  | S | M3 self locking nut |  |  |  | Amazon | https://www.amazon.com/Stainless-Self-Locking-Industrial-Construction-Fasteners/dp/B09SLLQ3KV | $0.055 | $0.109
 |  |  |  | 4 | 357 |  | S | M3 Threaded Spacer, hex, nylon, black, 20mm + 6mm, female-male |  |  |  | Amazon | https://www.aliexpress.us/item/3256804121267045.html | $0.083 | $0.331
 |  |  |  | 4 | 355 |  | S | M3 nut |  |  |  | AliExpress | https://www.aliexpress.us/item/2255800416538696.html | $0.027 | $0.108
 |  |  |  | 4 | 332 |  | S | M3 split lockwasher |  |  |  | Amazon | https://www.amazon.com/gp/product/B07Z2FJ2XW | $0.022 | $0.086
 |  |  |  | 1 | 364 |  | S' | 3" x 5" Small Plastic Bags- Reclosable Zip Bags |  |  |  | Amazon | https://www.amazon.com/gp/product/B07XBF98NV | $0.019 | $0.019
 | Tray Rack Mount Hardware for Power Regulator
 |  |  |  | 8 | 358 |  | S3 | Fender Washer, M3x16x1.0 mm |  |  |  | AliExpress | https://www.aliexpress.us/item/3256802393168670.html | $0.068 | $0.541
 |  |  |  | 4 | 334 |  | S3 | M3 x 12mm cap screw, black |  |  |  | Amazon | https://www.amazon.com/gp/product/B07CNFTK99 | $0.085 | $0.339
 |  |  |  | 4 | 332 |  | S3 | M3 split lockwasher |  |  |  | Amazon | https://www.amazon.com/gp/product/B07Z2FJ2XW | $0.022 | $0.086
 |  |  |  | 1 | 364 |  | S3' | 3" x 5" Small Plastic Bags- Reclosable Zip Bags |  |  |  | Amazon | https://www.amazon.com/gp/product/B07XBF98NV | $0.019 | $0.019
A7 | Power Supply for 3 Emulators (version v2) |  |  |  |  |  |  |  |  |  |  |  |  |  |  | $16.55 | $17
 |  |  |  | 1 | 107 |  | BP | PCB, RK05 Emulator Power Supply | v1 |  |  | JLCPCB | PCB Color: Black, Surface Finish: LeadFree HASL, Remove Order Number: Specify a location | $1.970 | $1.970
 |  |  |  | 1 | 368 |  | BP' | Ziplock Sandwich Bag |  |  |  | Costco |  | $0.000 | $0.000
 |  |  |  | 1 | 363 |  | CH | USB Type C Charger, 25W, with USB C to USB C 6 foot cable |  |  |  | Amazon | https://www.amazon.com/dp/B097MVXSQ5 | $5.377 | $5.377
 |  |  |  | 1 | 364 |  | CH' | 3" x 5" Small Plastic Bags- Reclosable Zip Bags |  |  |  | Amazon | https://www.amazon.com/gp/product/B07XBF98NV | $0.019 | $0.019
 |  |  |  | 1 | 351 |  | S1 | Power Trigger Module, USB Type C, 12V |  |  |  | AliExpress | https://www.aliexpress.us/item/3256802974608811.html | $0.834 | $0.834
 |  |  |  | 1 | 367 |  | S1' | Antistatic bag, 6x9 cm |  |  |  | AliExpress | https://www.aliexpress.us/item/3256802834769879.html | $0.085 | $0.085
 |  |  |  | 1 | 359 |  | S2 | DC-to-DC Converter, 12V input to 5V 10A output |  | TOBSUN | EA50-5V | AliExpress | https://www.aliexpress.us/item/3256804612946913.html | $5.096 | $5.096
 |  |  |  | 1 | 371 |  | S | Rectifier, 40V 450mV@5A 5A DO-27 Schottky Barrier Diode |  | Comchip | SR540L | AliExpress | https://www.aliexpress.us/item/3256805591615901.html | $0.247 | $0.247
 |  |  |  | 1 | 372 |  | S | Resistor, 4.7k, 1/4W 5% |  |  |  | AliExpress | https://www.aliexpress.us/item/3256805483572082.html | $0.030 | $0.030
 |  |  |  | 1 | 368 |  | S2' | Ziplock Sandwich Bag |  |  |  | Costco |  | $0.000 | $0.000
 |  |  |  | 2 | 360 |  | S | 22AWG 2 Conductor, Low-Voltage Tinned-Copper Wire, 1.5 inch |  |  |  | Amazon | https://www.amazon.com/dp/B07SCJ69H4 | $0.003 | $0.006
 |  |  |  | 4 | 362 |  | S | Spade Lug, Fork, 16-22AWG, SV1.25-4, Red |  |  |  | AliExpress | https://www.aliexpress.us/item/2251832658426440.html | $0.024 | $0.095
 |  |  |  | 3 | 340 | J21, J22, J23 | S | CONN HEADER VERT 3POS, 3.96MM |  | TE Connectivity AMP Connectors | 4-1123724-2 | Digikey | https://www.digikey.com/en/products/detail/te-connectivity-amp-connectors/4-1123724-2/5439777 | $0.148 | $0.443
 |  |  |  | 1 | 352 |  | S | Single Row 40 Pin 2.54 mm Male Pin Header Connector, cut to 4 pins |  |  |  | Amazon | https://www.amazon.com/gp/product/B06XR8CV8P | $0.022 | $0.022
 |  |  |  | 2 | 331 |  | S | M3 screw, hex, 8 mm, black |  |  |  | AliExpress | https://www.aliexpress.us/item/3256805242052170.html | $0.035 | $0.069
 |  |  |  | 2 | 328 |  | S | M3 self locking nut |  |  |  | Amazon | https://www.amazon.com/Stainless-Self-Locking-Industrial-Construction-Fasteners/dp/B09SLLQ3KV | $0.055 | $0.109
 |  |  |  | 4 | 357 |  | S | M3 Threaded Spacer, hex, nylon, black, 20mm + 6mm, female-male |  |  |  | Amazon | https://www.aliexpress.us/item/3256804121267045.html | $0.083 | $0.331
 |  |  |  | 4 | 355 |  | S | M3 nut |  |  |  | AliExpress | https://www.aliexpress.us/item/2255800416538696.html | $0.027 | $0.108
 |  |  |  | 4 | 332 |  | S | M3 split lockwasher |  |  |  | Amazon | https://www.amazon.com/gp/product/B07Z2FJ2XW | $0.022 | $0.086
 |  |  |  | 1 | 366 |  | S | Toggle Switch, SPDT, 6A 125V |  |  |  | AliExpress | https://www.aliexpress.us/item/3256804434717398.html | $0.616 | $0.616
 |  |  |  | 1 | 364 |  | S' | 3" x 5" Small Plastic Bags- Reclosable Zip Bags |  |  |  | Amazon | https://www.amazon.com/gp/product/B07XBF98NV | $0.019 | $0.019
 | Tray Rack Mount Hardware for Power Regulator
 |  |  |  | 8 | 358 |  | S3 | Fender Washer, M3x16x1.0 mm |  |  |  | AliExpress | https://www.aliexpress.us/item/3256802393168670.html | $0.068 | $0.541
 |  |  |  | 4 | 334 |  | S3 | M3 x 12mm cap screw, black |  |  |  | Amazon | https://www.amazon.com/gp/product/B07CNFTK99 | $0.085 | $0.339
 |  |  |  | 4 | 332 |  | S3 | M3 split lockwasher |  |  |  | Amazon | https://www.amazon.com/gp/product/B07Z2FJ2XW | $0.022 | $0.086
 |  |  |  | 1 | 364 |  | S3' | 3" x 5" Small Plastic Bags- Reclosable Zip Bags |  |  |  | Amazon | https://www.amazon.com/gp/product/B07XBF98NV | $0.019 | $0.019
A8 | Power Supply for 3 Emulators, without the DC-to-DC Converter (version v1) |  |  |  |  |  |  |  |  |  |  |  |  |  |  | $2.96 | $3
 |  |  |  | 1 | 107 |  | BP | PCB, RK05 Emulator Power Supply | v1 |  |  | JLCPCB | PCB Color: Black, Surface Finish: LeadFree HASL, Remove Order Number: Specify a location | $1.970 | $1.970
 |  |  |  | 1 | 368 |  | BP' | Ziplock Sandwich Bag |  |  |  | Costco |  | $0.000 | $0.000
 |  |  |  | 3 | 340 | J21, J22, J23 | Q | CONN HEADER VERT 3POS, 3.96MM |  | TE Connectivity AMP Connectors | 4-1123724-2 | Digikey | https://www.digikey.com/en/products/detail/te-connectivity-amp-connectors/4-1123724-2/5439777 | $0.148 | $0.443
 |  |  |  | 4 | 357 |  | Q | M3 Threaded Spacer, hex, nylon, black, 20mm + 6mm, female-male |  |  |  | Amazon | https://www.aliexpress.us/item/3256804121267045.html | $0.083 | $0.331
 |  |  |  | 4 | 355 |  | Q | M3 nut |  |  |  | AliExpress | https://www.aliexpress.us/item/2255800416538696.html | $0.027 | $0.108
 |  |  |  | 4 | 332 |  | Q | M3 split lockwasher |  |  |  | Amazon | https://www.amazon.com/gp/product/B07Z2FJ2XW | $0.022 | $0.086
 |  |  |  | 1 | 364 |  | Q' | 3" x 5" Small Plastic Bags- Reclosable Zip Bags |  |  |  | Amazon | https://www.amazon.com/gp/product/B07XBF98NV | $0.019 | $0.019
A8 | Power Supply for 3 Emulators, without the DC-to-DC Converter (version v2) |  |  |  |  |  |  |  |  |  |  |  |  |  |  | $4.69 | $5
 |  |  |  | 1 | 107 |  | BP | PCB, RK05 Emulator Power Supply | v1 |  |  | JLCPCB | PCB Color: Black, Surface Finish: LeadFree HASL, Remove Order Number: Specify a location | $1.970 | $1.970
 |  |  |  | 1 | 368 |  | BP' | Ziplock Sandwich Bag |  |  |  | Costco |  | $0.000 | $0.000
 |  |  |  | 3 | 340 | J21, J22, J23 | Q | CONN HEADER VERT 3POS, 3.96MM |  | TE Connectivity AMP Connectors | 4-1123724-2 | Digikey | https://www.digikey.com/en/products/detail/te-connectivity-amp-connectors/4-1123724-2/5439777 | $0.148 | $0.443
 |  |  |  | 1 | 371 |  | Q | Rectifier, 40V 450mV@5A 5A DO-27 Schottky Barrier Diode |  | Comchip | SR540L | AliExpress | https://www.aliexpress.us/item/3256805591615901.html | $0.247 | $0.247
 |  |  |  | 1 | 373 |  | Q | Mini Digital Voltmeter |  |  |  | AliExpress | https://www.aliexpress.us/item/3256805856942849.html | $1.044 | $1.044
 |  |  |  | 2 | 324 |  | Q | M2 Threaded Spacer, hex, nylon, black, 10mm, female-female |  |  |  | AliExpress | https://www.aliexpress.us/item/3256805464087324.html | $0.045 | $0.089
 |  |  |  | 2 | 315 |  | Q | M2 x 8mm screw, steel |  |  |  | Amazon | https://www.amazon.com/gp/product/B01M5DVI7A | $0.090 | $0.179
 |  |  |  | 2 | 321 |  | Q | M2 Phillips Round Pan Head Machine Screws (M2 x 4mm), Stainless Steel |  |  |  | Amazon | https://www.amazon.com/gp/product/B07HFYZ9YM | $0.086 | $0.172
 |  |  |  | 4 | 357 |  | Q | M3 Threaded Spacer, hex, nylon, black, 20mm + 6mm, female-male |  |  |  | Amazon | https://www.aliexpress.us/item/3256804121267045.html | $0.083 | $0.331
 |  |  |  | 4 | 355 |  | Q | M3 nut |  |  |  | AliExpress | https://www.aliexpress.us/item/2255800416538696.html | $0.027 | $0.108
 |  |  |  | 4 | 332 |  | Q | M3 split lockwasher |  |  |  | Amazon | https://www.amazon.com/gp/product/B07Z2FJ2XW | $0.022 | $0.086
 |  |  |  | 1 | 364 |  | Q' | 3" x 5" Small Plastic Bags- Reclosable Zip Bags |  |  |  | Amazon | https://www.amazon.com/gp/product/B07XBF98NV | $0.019 | $0.019
A9 | RK05 Emulator Rack Mount Tray for 3 Emulators (I'd rather you purchase this directly from Amazon) |  |  |  |  |  |  |  |  |  |  |  |  |  |  | $28.55 | $29
 |  |  |  | 1 | 356 |  |  | Rack Mount Tray, 19-Inch 1U Server, Vented Shelves |  |  |  | Amazon | https://www.amazon.com/gp/product/B01HTG4WHY | $28.550 | $28.550

Sheet: E1 BOM by bag
RK05 Emulator/Tester
E1 | RK05 Emulator
 |  |  | Qty | UPN |  | bag | Description | Ver | Manufacturer | Manufacturer's part number | Supplier | Link | cost ea | ext cost
 | A | Ziplock |  | 0 |  | A | Top Level Front
 |  |  | 1 | 303 |  | A | Rocker switch, on-mom |  |  | R4EBLKBLKEF0 | Digikey | https://www.digikey.com/en/products/detail/e-switch/R4EBLKBLKEF0/1805289 | $2.065 | $2.065
 |  |  | 1 | 304 |  | A | Rocker switch, on-off |  |  | R4ABLKBLKEF0 | Digikey | https://www.digikey.com/en/products/detail/e-switch/R4ABLKBLKEF0/1805255 | $1.356 | $1.356
 |  |  | 1 | 200 |  | A | RK05 Lamp Lens, 3D printed | v03 |  | 200 v03 | JLCPCB | 200 v03, SLA (Resin), LEDO 6060, Natural White | $1.697 | $1.697
 |  |  | 1 | 207 |  | A | Light Shield, 3D printed | v00 |  | 207 v03 | JLCPCB | 207 v03, SLA (Resin), LEDO 6060, Natural White + blk paint | $0.425 | $0.425
 |  |  | 1 | 364 |  | A' | 3" x 5" Small Plastic Bags- Reclosable Zip Bags |  |  |  | Amazon | https://www.amazon.com/gp/product/B07XBF98NV | $0.019 | $0.019
 | B |  |  | 0 |  | B | Bezel
 |  |  | 1 | 201 |  | B | RK05em Bezel, 3D printed | v05 |  | 201 v05 | JLCPCB | 201 v05, FDM (Plastic), PLA, White | $4.992 | $4.992
 |  |  | 6 | 300 |  | B | Threaded Insert, M3 x L=6 x OD=4.5 |  |  |  | AliExpress | https://www.aliexpress.us/item/3256805885174058.html | $0.037 | $0.222
 |  |  | 1 | 368 |  | B | Ziplock Sandwich Bag |  |  |  | Costco |  | $0.000 | $0.000
 | C | envelope |  | 0 |  | C | Dress Panel
 |  |  | 1 | 103 |  | C | RK05 Emulator Dress Panel | v00 |  |  | JLCPCB | Surface Finish: LeadFree HASL | $3.133 | $3.133
 | D | Ziplock |  | 0 |  | D | Top Level Hardware
 |  |  | 0 | 301 |  | D | M3 Threaded Spacer, hex, nylon, black, 25mm + 6mm, female-male |  |  |  | AliExpress | https://www.aliexpress.us/item/3256804121267045.html | $0.081 | $0.000
 |  |  | 4 | 369 |  | D | M3 Threaded Spacer, hex, nylon, black, 30mm + 6mm, female-male |  |  |  | AliExpress | https://www.aliexpress.us/item/3256804121267045.html | $0.099 | $0.397
 |  |  | 4 | 331 |  | D | M3 screw, hex, 8 mm, black |  |  |  | AliExpress | https://www.aliexpress.us/item/3256805242052170.html | $0.035 | $0.139
 |  |  | 4 | 332 |  | D | M3 split lockwasher |  |  |  | Amazon | https://www.amazon.com/gp/product/B07Z2FJ2XW | $0.022 | $0.086
 |  |  | 1 | 364 |  | D' | 3" x 5" Small Plastic Bags- Reclosable Zip Bags |  |  |  | Amazon | https://www.amazon.com/gp/product/B07XBF98NV | $0.019 | $0.019
 | E | Ziplock |  | 0 |  | E | Main Board Electrical
 |  |  | 1 | 202 |  | E | RK05em connector filler/shim, 3D printed | v05 |  | 202 v05 | JLCPCB | 200 v03, SLA (Resin), LEDO 6060, Natural White | $1.070 | $1.070
 |  |  | 1 | 310 |  | E | Single Row 40 Pin 2.54 mm Male Pin Header Connector, cut to 3 pins |  |  |  | Amazon | https://www.amazon.com/gp/product/B06XR8CV8P | $0.016 | $0.016
 |  |  | 2 | 312 |  | E | connector, 3-pin, 3.96 EP PLUG HSG 3P(BLACK) |  | TE Connectivity AMP Connectors | 5-1123722-3 | Digikey | https://www.digikey.com/en/products/detail/te-connectivity-amp-connectors/5-1123722-3/10467997 | $0.099 | $0.199
 |  |  | 4 | 339 |  | E | CONN SOCKET Pin, 18-22AWG, crimp tin |  | TE Connectivity AMP Connectors | 1123721-2 | Digikey | https://www.digikey.com/en/products/detail/te-connectivity-amp-connectors/1123721-2/686921 | $0.176 | $0.706
 |  |  | 1 | 340 | J3 | E | CONN HEADER VERT 3POS, 3.96MM |  | TE Connectivity AMP Connectors | 4-1123724-2 | Digikey | https://www.digikey.com/en/products/detail/te-connectivity-amp-connectors/4-1123724-2/5439777 | $0.148 | $0.148
 |  |  | 1 | 341 | J14 | E | CONN HEADER VERT 2x4 Pos, 2.54mm |  |  |  | AliExpress | https://www.aliexpress.us/item/3256805773340189.html | $0.068 | $0.068
 |  |  | 1 | 342 | J13 | E | CONN HEADER VERT 2x8 Pos, 2.54mm |  |  |  | AliExpress | https://www.aliexpress.us/item/3256805773340189.html | $0.129 | $0.129
 |  |  | 2 | 344 | U22A, U22B | E | Connector, 20-pin single row, socket strip, 2.54mm |  |  |  | AliExpress | https://www.aliexpress.us/item/3256803424019097.html | $0.512 | $1.024
 |  |  | 1 | 345 | J1 | E | CONN HEADER VERT 2x5 Pos, 2.54mm |  |  |  | AliExpress | https://www.aliexpress.us/item/3256805773340189.html | $0.081 | $0.081
 |  |  | 1 | 346 |  | E | 22AWG 2 Conductor, Low-Voltage Tinned-Copper Wire, 12-inch (30.5 cm) |  |  |  | Amazon | https://www.amazon.com/dp/B07SCJ69H4 | $0.196 | $0.196
 |  |  | 1 | 364 |  | E' | 3" x 5" Small Plastic Bags- Reclosable Zip Bags |  |  |  | Amazon | https://www.amazon.com/gp/product/B07XBF98NV | $0.019 | $0.019
 | F | Ziplock |  | 0 |  | F | Front Panel Board Hardware
 |  |  | 2 | 315 |  | F | M2 x 8mm screw, steel |  |  |  | Amazon | https://www.amazon.com/gp/product/B01M5DVI7A | $0.090 | $0.179
 |  |  | 0 | 321 |  | F | M2 Phillips Round Pan Head Machine Screws (M2 x 4mm), Stainless Steel |  |  |  | Amazon | https://www.amazon.com/gp/product/B07HFYZ9YM | $0.086 | $0.000
 |  |  | 2 | 322 |  | F | M2 split lockwasher |  |  |  | Amazon | https://www.amazon.com/gp/product/B09LLZHY87 | $0.023 | $0.045
 |  |  | 2 | 324 |  | F | M2 Threaded Spacer, hex, nylon, black, 10mm, female-female |  |  |  | AliExpress | https://www.aliexpress.us/item/3256805464087324.html | $0.045 | $0.089
 |  |  | 2 | 325 |  | F | M2 nylon flat washer |  |  |  | Amazon | https://www.amazon.com/uxcell-Insulating-Washers-Gaskets-Spacers/dp/B01N6B5KJN | $0.038 | $0.075
 |  |  | 8 | 326 |  | F | M3 Threaded Spacer, hex, nylon, black, 12mm, female-female |  |  |  | Amazon | https://www.amazon.com/gp/product/B072LGMRVD | $0.068 | $0.540
 |  |  | 8 | 327 |  | F | M3 screw, hex, 6 mm, black |  |  |  | AliExpress | https://www.aliexpress.us/item/3256805242052170.html | $0.030 | $0.238
 |  |  | 2 | 328 |  | F | M3 self locking nut |  |  |  | Amazon | https://www.amazon.com/Stainless-Self-Locking-Industrial-Construction-Fasteners/dp/B09SLLQ3KV | $0.055 | $0.109
 |  |  | 12 | 329 |  | F | Self-Adhesive Clear Rubber Feet, 6mm dia x 2mm thick |  |  |  | Amazon | https://www.amazon.com/gp/product/B073ST7Q27 | $0.014 | $0.171
 |  |  | 2 | 331 |  | F | M3 screw, hex, 8 mm, black |  |  |  | AliExpress | https://www.aliexpress.us/item/3256805242052170.html | $0.035 | $0.069
 |  |  | 1 | 364 |  | F' | 3" x 5" Small Plastic Bags- Reclosable Zip Bags |  |  |  | Amazon | https://www.amazon.com/gp/product/B07XBF98NV | $0.019 | $0.019
 | G | Antistatic |  | 0 | Antistatic 15x20 | G | Main Board
 |  |  | 1 | 100 |  | G | Emulator Main Board assembled | v1 |  |  | JLCPCB | Surface Finish: LeadFree HASL | $33.939 | $33.939
 |  |  | 1 | 338 |  | G' | Antistatic bag, 15x20 cm |  |  |  | Amazon | https://www.amazon.com/dp/B07TXD47PZ | $0.166 | $0.166
 | H | Ziplock |  | 0 |  | H | Front Panel Board Electrical
 |  |  | 1 | 317 |  | H | dipswitch, right angle, 4-switch piano type |  | ALINSIN STORE |  | AliExpress | https://www.aliexpress.us/item/3256803055482916.html | $0.435 | $0.435
 |  |  | 2 | 318 |  | H | 22AWG 2 Conductor, Low-Voltage Tinned-Copper Wire, 3.5 inch |  |  |  | Amazon | https://www.amazon.com/dp/B07SCJ69H4 | $0.057 | $0.114
 |  |  | 4 | 319 |  | H | Nylon Flag Spade Quick Disconnect, 22-18 AWG |  |  |  | Amazon | https://www.amazon.com/dp/B0C625XHQM | $0.086 | $0.344
 |  |  | 1 | 342 |  | H | CONN HEADER VERT 2x8 Pos, 2.54mm |  |  |  | AliExpress | https://www.aliexpress.us/item/3256805773340189.html | $0.129 | $0.129
 |  |  | 1 | 343 |  | H | Connector, 4-pin single Row, socket strip, 2.54mm |  |  |  | AliExpress | https://www.aliexpress.us/item/3256803424019097.html | $0.099 | $0.099
 |  |  | 1 | 323 |  | H | OLED display module, 128x64, 0.96 inch |  |  |  | AliExpress | https://www.aliexpress.us/item/3256805094941943.html | $1.605 | $1.605
 |  |  | 1 | 364 |  | H' | 3" x 5" Small Plastic Bags- Reclosable Zip Bags |  |  |  | Amazon | https://www.amazon.com/gp/product/B07XBF98NV | $0.019 | $0.019
 | J | Antistatic |  | 0 | Antistatic 15x20 | J | Front Panel
 |  |  | 1 | 101 |  | J | Front Panel board assembled | v3 |  |  | JLCPCB | Surface Finish: LeadFree HASL | $7.470 | $7.470
 |  |  | 1 | 338 |  | J' | Antistatic bag, 15x20 cm |  |  |  | Amazon | https://www.amazon.com/dp/B07TXD47PZ | $0.166 | $0.166
 | K | Ziplock |  | 0 |  | K | microSD Board
 |  |  | 1 | 102 |  | K | microSD card adapter board, assembled | v1 |  |  | JLCPCB | Surface Finish: LeadFree HASL | $1.380 | $1.380
 |  |  | 1 | 204 |  | K | microSD card carrier bracket, 3D printed | v20 |  | 204 v20 | JLCPCB | 204 v20, FDM (Plastic), PLA, Black | $2.062 | $2.062
 |  |  | 1 | 341 | J14 | K | CONN HEADER VERT 2x4 Pos, 2.54mm |  |  |  | AliExpress | https://www.aliexpress.us/item/3256805773340189.html | $0.068 | $0.068
 |  |  | 2 | 311 |  | K | Threaded Insert, M2 |  |  |  | Amazon | https://www.amazon.com/gp/product/B0B8GN63S2 | $0.093 | $0.185
 |  |  | 2 | 321 |  | K2 | M2 Phillips Round Pan Head Machine Screws (M2 x 4mm), Stainless Steel |  |  |  | Amazon | https://www.amazon.com/gp/product/B07HFYZ9YM | $0.086 | $0.172
 |  |  | 2 | 322 |  | K2 | M2 split lockwasher |  |  |  | Amazon | https://www.amazon.com/gp/product/B09LLZHY87 | $0.023 | $0.045
 |  |  | 2 | 364 |  | K' | 3" x 5" Small Plastic Bags- Reclosable Zip Bags |  |  |  | Amazon | https://www.amazon.com/gp/product/B07XBF98NV | $0.019 | $0.039
 | L | Ziplock |  | 0 |  | L | Rack Mount Tray Hardware
 |  |  | 2 | 331 |  | L | M3 screw, hex, 8 mm, black |  |  |  | AliExpress | https://www.aliexpress.us/item/3256805242052170.html | $0.035 | $0.069
 |  |  | 2 | 332 |  | L | M3 split lockwasher |  |  |  | Amazon | https://www.amazon.com/gp/product/B07Z2FJ2XW | $0.022 | $0.043
 |  |  | 2 | 358 |  | L | Fender Washer, M3x16x1.0 mm |  |  |  | AliExpress | https://www.aliexpress.us/item/3256802393168670.html | $0.068 | $0.135
 |  |  | 1 | 364 |  | L' | 3" x 5" Small Plastic Bags- Reclosable Zip Bags |  |  |  | Amazon | https://www.amazon.com/gp/product/B07XBF98NV | $0.019 | $0.019
 | M | Ziplock |  | 0 |  | M | Edge connectors
 |  |  | 2 | 313 | J7, J8 | M | edge connector, 1PCS, 3.175mm, 2x43 86 pin |  |  |  | AliExpress | https://www.aliexpress.us/item/2255801094078491.html | $3.371 | $6.742
 |  |  | 1 | 364 |  | M' | 3" x 5" Small Plastic Bags- Reclosable Zip Bags |  |  |  | Amazon | https://www.amazon.com/gp/product/B07XBF98NV | $0.019 | $0.019
 | N | Ziplock |  | 0 |  | N | Flat Cables
 |  |  | 1 | 347 |  | N | Flat Cable, 8-pin 2x4 IDC, 10cm |  |  |  | AliExpress | https://www.aliexpress.us/item/3256803248238815.html | $1.170 | $1.170
 |  |  | 1 | 348 |  | N | Flat Cable, 16-pin 2x8 IDC, 10cm |  |  |  | AliExpress | https://www.aliexpress.us/item/3256803248238815.html | $1.330 | $1.330
 |  |  | 1 | 364 |  | N' | 3" x 5" Small Plastic Bags- Reclosable Zip Bags |  |  |  | Amazon | https://www.amazon.com/gp/product/B07XBF98NV | $0.019 | $0.019
 | P | Antistatic |  | 0 | Antistatic 6x9 | P | RPi Pico
 |  |  | 1 | 309 | U22 | P | Raspberry Pi Pico H (SC0917), with pre-soldered headers |  |  |  | Digikey | https://www.digikey.com/en/products/detail/raspberry-pi/SC0917/16608257 | $6.087 | $6.087
 |  |  | 1 | 367 |  | P' | Antistatic bag, 6x9 cm |  |  |  | AliExpress | https://www.aliexpress.us/item/3256802834769879.html | $0.085 | $0.085

Sheet: Accessory BOM by bag
 |  |  | Qty | UPN |  |  | Description | Ver | Manufacturer | Manufacturer's part number | Supplier | Link | cost ea | ext cost
RK05 Emulator Accessories
T1 | M930GW Terminator Board |  |  |  |  |  |  |  |  |  |  |  |  |  | $8.55 | $9
 |  |  | 1 | 104 |  | T1 | M930GW Terminator Board, assembled | v0 |  |  | JLCPCB | M930GW_Terminator_Board_ordering_instructions.pdf | $8.389 | $8.389
 |  |  | 1 | 338 |  | T1' | Antistatic bag, 15x20 cm |  |  |  | Amazon | https://www.amazon.com/dp/B07TXD47PZ | $0.166 | $0.166
A1 | RK05-to-RK8-E Cable, 1 meter length |  |  |  |  |  |  |  |  |  |  |  |  |  | $21.20 | $22
 | BE | Ziplock Sandwich |  | 0 |  | BE | PCB, M993GW RK05 Adapter Board
 |  |  | 1 | 105 |  | BE | PCB, M993GW RK05 Adapter Board | v2 |  |  | JLCPCB | Surface Finish: ENIG | $5.676 | $5.676
 |  |  | 1 | 368 |  | BE' | Ziplock Sandwich Bag |  |  |  | Costco |  | $0.000 | $0.000
 | C1 |  |  | 0 |  | C1 | Flat Cables, 40-pin 2x20 IDC, 1m Length
 |  |  | 2 | 349 |  | C1 | Flat Cable, 40-pin 2x20 IDC, 1m |  |  |  | AliExpress | https://www.aliexpress.us/item/3256803248238815.html | $5.502 | $11.004
 | H1 | Ziplock |  | 0 |  | H1 | RK05 Emulator/Tester Adapter Electrical & Hardware
 |  |  | 2 | 336 |  | H1 | Header, 40-pin, right-angle, with ejectors |  | Amphenol ICC (FCI) | 86130402113345E1LF | Digikey | https://www.digikey.com/en/products/detail/amphenol-cs-fci/86130402113345E1LF/5201672 | $1.790 | $3.580
 |  |  | 1 | 205 |  | H1 | M993GW Cable Clamp, 3D printed | v03 |  | 205 v03 | JLCPCB | 200 v03, SLA (Resin), LEDO 6060, Natural White | $0.619 | $0.619
 |  |  | 2 | 334 |  | H1 | M3 x 12mm cap screw, black |  |  |  | Amazon | https://www.amazon.com/gp/product/B07CNFTK99 | $0.085 | $0.169
 |  |  | 2 | 328 |  | H1 | M3 self locking nut |  |  |  | Amazon | https://www.amazon.com/Stainless-Self-Locking-Industrial-Construction-Fasteners/dp/B09SLLQ3KV | $0.055 | $0.109
 |  |  | 2 | 364 |  | H1' | 3" x 5" Small Plastic Bags- Reclosable Zip Bags |  |  |  | Amazon | https://www.amazon.com/gp/product/B07XBF98NV | $0.019 | $0.039
A2 | RK05-to-RK05 Cable, 1 meter length |  |  |  |  |  |  |  |  |  |  |  |  |  | $31.35 | $32
 | BE2 | Ziplock Sandwich |  | 0 |  | BE2 | PCB, M993GW RK05 Adapter Board
 |  |  | 2 | 105 |  | BE2 | PCB, M993GW RK05 Adapter Board | v2 |  |  | JLCPCB | Surface Finish: ENIG | $5.676 | $11.352
 |  |  | 1 | 368 |  | BE2' | Ziplock Sandwich Bag |  |  |  | Costco |  | $0.000 | $0.000
 | C1 |  |  | 0 |  | C1 | Flat Cables, 40-pin 2x20 IDC, 1m Length
 |  |  | 2 | 349 |  | C1 | Flat Cable, 40-pin 2x20 IDC, 1m |  |  |  | AliExpress | https://www.aliexpress.us/item/3256803248238815.html | $5.502 | $11.004
 | H2 | Ziplock |  | 0 |  | H2 | RK05 Emulator/Tester Adapter Electrical & Hardware
 |  |  | 4 | 336 |  | H2 | Header, 40-pin, right-angle, with ejectors |  | Amphenol ICC (FCI) | 86130402113345E1LF | Digikey | https://www.digikey.com/en/products/detail/amphenol-cs-fci/86130402113345E1LF/5201672 | $1.790 | $7.160
 |  |  | 2 | 205 |  | H2 | M993GW Cable Clamp, 3D printed | v03 |  | 205 v03 | JLCPCB | 200 v03, SLA (Resin), LEDO 6060, Natural White | $0.619 | $1.237
 |  |  | 4 | 334 |  | H2 | M3 x 12mm cap screw, black |  |  |  | Amazon | https://www.amazon.com/gp/product/B07CNFTK99 | $0.085 | $0.339
 |  |  | 4 | 328 |  | H2 | M3 self locking nut |  |  |  | Amazon | https://www.amazon.com/Stainless-Self-Locking-Industrial-Construction-Fasteners/dp/B09SLLQ3KV | $0.055 | $0.218
 |  |  | 2 | 364 |  | H2' | 3" x 5" Small Plastic Bags- Reclosable Zip Bags |  |  |  | Amazon | https://www.amazon.com/gp/product/B07XBF98NV | $0.019 | $0.039
A3 | RK05-to-RK05 Cable, Side-to-Side, 20cm length |  |  |  |  |  |  |  |  |  |  |  |  |  | $22.81 | $23
 | BE2 | Ziplock |  | 0 |  | BE2 | PCB, M993GW RK05 Adapter Board
 |  |  | 2 | 105 |  | BE2 | PCB, M993GW RK05 Adapter Board | v2 |  |  | JLCPCB | Surface Finish: ENIG | $5.676 | $11.352
 |  |  | 1 | 368 |  | BE2' | Ziplock Sandwich Bag |  |  |  | Costco |  | $0.000 | $0.000
 | C2 |  |  | 0 |  | C2 | Flat Cables, 40-pin 2x20 IDC, 20cm & 30cm Length
 |  |  | 1 | 361 |  | C2 | Flat Cable, 40-pin 2x20 IDC, 30cm |  |  |  | AliExpress | https://www.aliexpress.us/item/3256803248238815.html | $2.129 | $2.129
 |  |  | 1 | 370 |  | C2 | Flat Cable, 40-pin 2x20 IDC, 20cm |  |  |  | AliExpress | https://www.aliexpress.us/item/3256803248238815.html | $2.129 | $2.129
 | R2 | Ziplock |  | 0 |  | R2 | RK05 Emulator Side-Side Electrical & Hardware
 |  |  | 4 | 336 |  | R2 | Header, 40-pin, right-angle, with ejectors |  | Amphenol ICC (FCI) | 86130402113345E1LF | Digikey | https://www.digikey.com/en/products/detail/amphenol-cs-fci/86130402113345E1LF/5201672 | $1.790 | $7.160
 |  |  | 2 | 364 |  | R2' | 3" x 5" Small Plastic Bags- Reclosable Zip Bags |  |  |  | Amazon | https://www.amazon.com/gp/product/B07XBF98NV | $0.019 | $0.039
A4 | RK05 Adapter Board without flat cables |  |  |  |  |  |  |  |  |  |  |  |  |  | $10.19 | $11
 | BE | Ziplock |  | 0 |  | BE | PCB, M993GW RK05 Adapter Board
 |  |  | 1 | 105 |  | BE | PCB, M993GW RK05 Adapter Board | v2 |  |  | JLCPCB | Surface Finish: ENIG | $5.676 | $5.676
 |  |  | 1 | 368 |  | BE' | Ziplock Sandwich Bag |  |  |  | Costco |  | $0.000 | $0.000
 | H1 | Ziplock |  | 0 |  | H1 | RK05 Emulator/Tester Adapter Electrical & Hardware
 |  |  | 2 | 336 |  | H1 | Header, 40-pin, right-angle, with ejectors |  | Amphenol ICC (FCI) | 86130402113345E1LF | Digikey | https://www.digikey.com/en/products/detail/amphenol-cs-fci/86130402113345E1LF/5201672 | $1.790 | $3.580
 |  |  | 1 | 205 |  | H1 | M993GW Cable Clamp, 3D printed | v03 |  | 205 v03 | JLCPCB | 200 v03, SLA (Resin), LEDO 6060, Natural White | $0.619 | $0.619
 |  |  | 2 | 334 |  | H1 | M3 x 12mm cap screw, black |  |  |  | Amazon | https://www.amazon.com/gp/product/B07CNFTK99 | $0.085 | $0.169
 |  |  | 2 | 328 |  | H1 | M3 self locking nut |  |  |  | Amazon | https://www.amazon.com/Stainless-Self-Locking-Industrial-Construction-Fasteners/dp/B09SLLQ3KV | $0.055 | $0.109
 |  |  | 2 | 364 |  | H1' | 3" x 5" Small Plastic Bags- Reclosable Zip Bags |  |  |  | Amazon | https://www.amazon.com/gp/product/B07XBF98NV | $0.019 | $0.039
A5 | RK05-to-Tester Cable, 1 meter length |  |  |  |  |  |  |  |  |  |  |  |  |  | $31.35 | $32
 | BE | Ziplock |  | 0 |  | BE | PCB, M993GW RK05 Adapter Board
 |  |  | 1 | 105 |  | BE | PCB, M993GW RK05 Adapter Board | v2 |  |  | JLCPCB | Surface Finish: ENIG | $5.676 | $5.676
 |  |  | 1 | 368 |  | BE' | Ziplock Sandwich Bag |  |  |  | Costco |  | $0.000 | $0.000
 | BT | Ziplock Sandwich |  | 0 |  | BT | PCB, RK05 Tester Cable Adapter Board
 |  |  | 1 | 106 |  | BT' | PCB, RK05 Tester Cable Adapter Board | v1 |  |  | JLCPCB | Surface Finish: ENIG | $5.676 | $5.676
 |  |  | 1 | 368 |  | BT' | Ziplock Sandwich Bag |  |  |  | Costco |  | $0.000 | $0.000
 | C1 |  |  | 0 |  | C1 | Flat Cables, 40-pin 2x20 IDC, 1m Length
 |  |  | 2 | 349 |  | C1 | Flat Cable, 40-pin 2x20 IDC, 1m |  |  |  | AliExpress | https://www.aliexpress.us/item/3256803248238815.html | $5.502 | $11.004
 | H2 | Ziplock |  | 0 |  | H2 | RK05 Emulator/Tester Adapter Electrical & Hardware
 |  |  | 4 | 336 |  | H2 | Header, 40-pin, right-angle, with ejectors |  | Amphenol ICC (FCI) | 86130402113345E1LF | Digikey | https://www.digikey.com/en/products/detail/amphenol-cs-fci/86130402113345E1LF/5201672 | $1.790 | $7.160
 |  |  | 2 | 205 |  | H2 | M993GW Cable Clamp, 3D printed | v03 |  | 205 v03 | JLCPCB | 200 v03, SLA (Resin), LEDO 6060, Natural White | $0.619 | $1.237
 |  |  | 4 | 334 |  | H2 | M3 x 12mm cap screw, black |  |  |  | Amazon | https://www.amazon.com/gp/product/B07CNFTK99 | $0.085 | $0.339
 |  |  | 4 | 328 |  | H2 | M3 self locking nut |  |  |  | Amazon | https://www.amazon.com/Stainless-Self-Locking-Industrial-Construction-Fasteners/dp/B09SLLQ3KV | $0.055 | $0.218
 |  |  | 2 | 364 |  | H2' | 3" x 5" Small Plastic Bags- Reclosable Zip Bags |  |  |  | Amazon | https://www.amazon.com/gp/product/B07XBF98NV | $0.019 | $0.039
A6 | RK05 Tester Adapter Board without flat cables |  |  |  |  |  |  |  |  |  |  |  |  |  | $10.19 | $11
 | BT | Ziplock Sandwich |  | 0 |  | BT | PCB, RK05 Tester Cable Adapter Board
 |  |  | 1 | 106 |  | BT | PCB, RK05 Tester Cable Adapter Board | v1 |  |  | JLCPCB | Surface Finish: ENIG | $5.676 | $5.676
 |  |  | 1 | 368 |  | BT' | Ziplock Sandwich Bag |  |  |  | Costco |  | $0.000 | $0.000
 | H1 | Ziplock |  | 0 |  | H1 | RK05 Emulator/Tester Adapter Electrical & Hardware
 |  |  | 2 | 336 |  | H1 | Header, 40-pin, right-angle, with ejectors |  | Amphenol ICC (FCI) | 86130402113345E1LF | Digikey | https://www.digikey.com/en/products/detail/amphenol-cs-fci/86130402113345E1LF/5201672 | $1.790 | $3.580
 |  |  | 1 | 205 |  | H1 | M993GW Cable Clamp, 3D printed | v03 |  | 205 v03 | JLCPCB | 200 v03, SLA (Resin), LEDO 6060, Natural White | $0.619 | $0.619
 |  |  | 2 | 334 |  | H1 | M3 x 12mm cap screw, black |  |  |  | Amazon | https://www.amazon.com/gp/product/B07CNFTK99 | $0.085 | $0.169
 |  |  | 2 | 328 |  | H1 | M3 self locking nut |  |  |  | Amazon | https://www.amazon.com/Stainless-Self-Locking-Industrial-Construction-Fasteners/dp/B09SLLQ3KV | $0.055 | $0.109
 |  |  | 2 | 364 |  | H1' | 3" x 5" Small Plastic Bags- Reclosable Zip Bags |  |  |  | Amazon | https://www.amazon.com/gp/product/B07XBF98NV | $0.019 | $0.039
A7 | Power Supply for 3 Emulators |  |  |  |  |  |  |  |  |  |  |  |  |  | $15.90 | $16
 | BP | Ziplock Sandwich |  | 0 |  | BP | PCB, RK05 Emulator Power Supply
 |  |  | 1 | 107 |  | BP | PCB, RK05 Emulator Power Supply | v1 |  |  | JLCPCB | PCB Color: Black, Surface Finish: LeadFree HASL, Remove Order Number: Specify a location | $1.970 | $1.970
 |  |  | 1 | 368 |  | BP' | Ziplock Sandwich Bag |  |  |  | Costco |  | $0.000 | $0.000
 | CH | Ziplock |  | 0 |  | CH | USB Type C Charger, 25W, with USB C to USB C 6 foot cable
 |  |  | 1 | 363 |  | CH | USB Type C Charger, 25W, with USB C to USB C 6 foot cable |  |  |  | Amazon | https://www.amazon.com/dp/B097MVXSQ5 | $5.377 | $5.377
 |  |  | 1 | 364 |  | S' | 3" x 5" Small Plastic Bags- Reclosable Zip Bags |  |  |  | Amazon | https://www.amazon.com/gp/product/B07XBF98NV | $0.019 | $0.019
 | S1 | Antistatic |  | 0 | Antistatic 6x9 | S1 | Power Trigger Module, USB Type C, 12V
 |  |  | 1 | 351 |  | S1 | Power Trigger Module, USB Type C, 12V |  |  |  | AliExpress | https://www.aliexpress.us/item/3256802974608811.html | $0.834 | $0.834
 |  |  | 1 | 367 |  | S1' | Antistatic bag, 6x9 cm |  |  |  | AliExpress | https://www.aliexpress.us/item/3256802834769879.html | $0.085 | $0.085
 | S2 | Ziplock |  | 0 |  | S2 | DC-to-DC Converter, 12V input to 5V 10A output
 |  |  | 1 | 359 |  | S2 | DC-to-DC Converter, 12V input to 5V 10A output |  | TOBSUN | EA50-5V | AliExpress | https://www.aliexpress.us/item/3256804612946913.html | $5.096 | $5.096
 |  |  | 1 | 368 |  | BP' | Ziplock Sandwich Bag |  |  |  | Costco |  | $0.000 | $0.000
 | S | Ziplock |  | 0 |  | S | Power Supply Electrical & Hardware
 |  |  | 2 | 360 |  | S | 22AWG 2 Conductor, Low-Voltage Tinned-Copper Wire, 1.5 inch |  |  |  | Amazon | https://www.amazon.com/dp/B07SCJ69H4 | $0.003 | $0.006
 |  |  | 4 | 362 |  | S | Spade Lug, Fork, 16-22AWG, SV1.25-4, Red |  |  |  | AliExpress | https://www.aliexpress.us/item/2251832658426440.html | $0.024 | $0.095
 |  |  | 3 | 340 | J21, J22, J23 | S | CONN HEADER VERT 3POS, 3.96MM |  | TE Connectivity AMP Connectors | 4-1123724-2 | Digikey | https://www.digikey.com/en/products/detail/te-connectivity-amp-connectors/4-1123724-2/5439777 | $0.148 | $0.443
 |  |  | 1 | 352 |  | S | Single Row 40 Pin 2.54 mm Male Pin Header Connector, cut to 4 pins |  |  |  | Amazon | https://www.amazon.com/gp/product/B06XR8CV8P | $0.022 | $0.022
 |  |  | 1 | 371 |  | S | Rectifier, 40V 450mV@5A 5A DO-27 Schottky Barrier Diode |  | Comchip | SR540L | AliExpress | https://www.aliexpress.us/item/3256805591615901.html | $0.247 | $0.247
 |  |  | 0 | 372 |  | S | Resistor, 4.7k, 1/4W 5% |  |  |  | AliExpress | https://www.aliexpress.us/item/3256805483572082.html | $0.030 | $0.000
 |  |  | 2 | 331 |  | S | M3 screw, hex, 8 mm, black |  |  |  | AliExpress | https://www.aliexpress.us/item/3256805242052170.html | $0.035 | $0.069
 |  |  | 2 | 328 |  | S | M3 self locking nut |  |  |  | Amazon | https://www.amazon.com/Stainless-Self-Locking-Industrial-Construction-Fasteners/dp/B09SLLQ3KV | $0.055 | $0.109
 |  |  | 4 | 357 |  | S | M3 Threaded Spacer, hex, nylon, black, 20mm + 6mm, female-male |  |  |  | Amazon | https://www.aliexpress.us/item/3256804121267045.html | $0.083 | $0.331
 |  |  | 4 | 355 |  | S | M3 nut |  |  |  | AliExpress | https://www.aliexpress.us/item/2255800416538696.html | $0.027 | $0.108
 |  |  | 4 | 332 |  | S | M3 split lockwasher |  |  |  | Amazon | https://www.amazon.com/gp/product/B07Z2FJ2XW | $0.022 | $0.086
 |  |  | 0 | 366 |  | S | Toggle Switch, SPDT, 6A 125V |  |  |  | AliExpress | https://www.aliexpress.us/item/3256804434717398.html | $0.616 | $0.000
 |  |  | 1 | 364 |  | S' | 3" x 5" Small Plastic Bags- Reclosable Zip Bags |  |  |  | Amazon | https://www.amazon.com/gp/product/B07XBF98NV | $0.019 | $0.019
 | S3 | Ziplock |  | 0 |  | S3 | Tray Rack Mount Hardware for Power Regulator
 |  |  | 8 | 358 |  | S3 | Fender Washer, M3x16x1.0 mm |  |  |  | AliExpress | https://www.aliexpress.us/item/3256802393168670.html | $0.068 | $0.541
 |  |  | 4 | 334 |  | S3 | M3 x 12mm cap screw, black |  |  |  | Amazon | https://www.amazon.com/gp/product/B07CNFTK99 | $0.085 | $0.339
 |  |  | 4 | 332 |  | S3 | M3 split lockwasher |  |  |  | Amazon | https://www.amazon.com/gp/product/B07Z2FJ2XW | $0.022 | $0.086
 |  |  | 1 | 364 |  | S3' | 3" x 5" Small Plastic Bags- Reclosable Zip Bags |  |  |  | Amazon | https://www.amazon.com/gp/product/B07XBF98NV | $0.019 | $0.019
A8 | Power Supply for 3 Emulators, without the DC-to-DC Converter, AC Adapter and mounting hardware |  |  |  |  |  |  |  |  |  |  |  |  |  | $2.96 | $3
 | BP | Ziplock Sandwich |  | 0 |  | BP | PCB, RK05 Emulator Power Supply
 |  |  | 1 | 107 |  | BP | PCB, RK05 Emulator Power Supply | v1 |  |  | JLCPCB | PCB Color: Black, Surface Finish: LeadFree HASL, Remove Order Number: Specify a location | $1.970 | $1.970
 |  |  | 1 | 368 |  | BP' | Ziplock Sandwich Bag |  |  |  | Costco |  | $0.000 | $0.000
 | Q | Ziplock |  | 0 |  | Q | Power Supply, Minimal
 |  |  | 3 | 340 | J21, J22, J23 | Q | CONN HEADER VERT 3POS, 3.96MM |  | TE Connectivity AMP Connectors | 4-1123724-2 | Digikey | https://www.digikey.com/en/products/detail/te-connectivity-amp-connectors/4-1123724-2/5439777 | $0.148 | $0.443
 |  |  | 0 | 371 |  | Q | Rectifier, 40V 450mV@5A 5A DO-27 Schottky Barrier Diode |  | Comchip | SR540L | AliExpress | https://www.aliexpress.us/item/3256805591615901.html | $0.247 | $0.000
 |  |  | 0 | 373 |  | Q | Mini Digital Voltmeter |  |  |  | AliExpress | https://www.aliexpress.us/item/3256805856942849.html | $1.044 | $0.000
 |  |  | 0 | 324 |  | Q | M2 Threaded Spacer, hex, nylon, black, 10mm, female-female |  |  |  | AliExpress | https://www.aliexpress.us/item/3256805464087324.html | $0.045 | $0.000
 |  |  | 0 | 315 |  | Q | M2 x 8mm screw, steel |  |  |  | Amazon | https://www.amazon.com/gp/product/B01M5DVI7A | $0.090 | $0.000
 |  |  | 0 | 321 |  | Q | M2 Phillips Round Pan Head Machine Screws (M2 x 4mm), Stainless Steel |  |  |  | Amazon | https://www.amazon.com/gp/product/B07HFYZ9YM | $0.086 | $0.000
 |  |  | 4 | 357 |  | Q | M3 Threaded Spacer, hex, nylon, black, 20mm + 6mm, female-male |  |  |  | Amazon | https://www.aliexpress.us/item/3256804121267045.html | $0.083 | $0.331
 |  |  | 4 | 355 |  | Q | M3 nut |  |  |  | AliExpress | https://www.aliexpress.us/item/2255800416538696.html | $0.027 | $0.108
 |  |  | 4 | 332 |  | Q | M3 split lockwasher |  |  |  | Amazon | https://www.amazon.com/gp/product/B07Z2FJ2XW | $0.022 | $0.086
 |  |  | 1 | 364 |  | Q' | 3" x 5" Small Plastic Bags- Reclosable Zip Bags |  |  |  | Amazon | https://www.amazon.com/gp/product/B07XBF98NV | $0.019 | $0.019
A9 | RK05 Emulator Rack Mount Tray for 3 Emulators (I'd rather you purchase this directly from Amazon) |  |  |  |  |  |  |  |  |  |  |  |  |  | $28.55 | $29
 |  |  | 1 | 356 |  |  | Rack Mount Tray, 19-Inch 1U Server, Vented Shelves |  |  |  | Amazon | https://www.amazon.com/gp/product/B01HTG4WHY | $28.550 | $28.550

Sheet: Materials by UPN
 |  |  |  |  |  |  |  |  |  |  |  |  | 0
Qty | upn | Description | Ver | Manufacturer | Manufacturer's part number | Supplier | Link | item order cost | tax & shipping | per order quantity | cost ea | ext cost
1 | 100 | Emulator Main Board assembled | v1 |  |  | JLCPCB | Surface Finish: LeadFree HASL | $291.20 | $48.19 | 10 | $33.939 | $33.939 |  | $414.09
1 | 101 | Front Panel board assembled | v3 |  |  | JLCPCB | Surface Finish: LeadFree HASL | $45.55 | $29.15 | 10 | $7.470 | $7.470
1 | 102 | microSD card adapter board, assembled | v1 |  |  | JLCPCB | Surface Finish: LeadFree HASL | $24.60 | $16.79 | 30 | $1.380 | $1.380
1 | 103 | RK05 Emulator Dress Panel | v00 |  |  | JLCPCB | Surface Finish: LeadFree HASL | $13.50 | $17.83 | 10 | $3.133 | $3.133
1 | 104 | M930GW Terminator Board, assembled | v0 |  |  | JLCPCB | M930GW_Terminator_Board_ordering_instructions.pdf | $53.81 | $30.08 | 10 | $8.389 | $8.389
1 | 105 | PCB, M993GW RK05 Adapter Board | v2 |  |  | JLCPCB | Surface Finish: ENIG | $35.60 | $21.16 | 10 | $5.676 | $5.676
0 | 106 | PCB, RK05 Tester Cable Adapter Board | v1 |  |  | JLCPCB | Surface Finish: ENIG | $35.60 | $21.16 | 10 | $5.676 | $0.000
0 | 107 | PCB, RK05 Emulator Power Supply | v1 |  |  | JLCPCB | PCB Color: Black, Surface Finish: LeadFree HASL, Remove Order Number: Specify a location | $6.40 | $13.30 | 10 | $1.970 | $0.000
1 | 200 | RK05 Lamp Lens, 3D printed | v03 |  | 200 v03 | JLCPCB | 200 v03, SLA (Resin), LEDO 6060, Natural White | $9.87 | $7.10 | 10 | $1.697 | $1.697
1 | 201 | RK05em Bezel, 3D printed | v05 |  | 201 v05 | JLCPCB | 201 v05, FDM (Plastic), PLA, White | $30.54 | $19.38 | 10 | $4.992 | $4.992
1 | 202 | RK05em connector filler/shim, 3D printed | v05 |  | 202 v05 | JLCPCB | 200 v03, SLA (Resin), LEDO 6060, Natural White | $3.60 | $7.10 | 10 | $1.070 | $1.070
0 | 203 | microSD sliding door, 3D printed | v14 |  | n/a | JLCPCB | n/a | $0.00 |  | 10 | $0.000 | $0.000
1 | 204 | microSD card carrier bracket, 3D printed | v20 |  | 204 v20 | JLCPCB | 204 v20, FDM (Plastic), PLA, Black | $10.00 | $10.62 | 10 | $2.062 | $2.062
1 | 205 | M993GW Cable Clamp, 3D printed | v03 |  | 205 v03 | JLCPCB | 200 v03, SLA (Resin), LEDO 6060, Natural White | $3.00 | $3.19 | 10 | $0.619 | $0.619
0 | 206 | Light Shield, thick paper | v1 |  |  | Hobby Lobby |  | $5.00 | $0.00 | 300 | $0.017 | $0.000
1 | 207 | Light Shield, 3D printed | v03 |  | 207 v03 | JLCPCB | 207 v03, SLA (Resin), LEDO 6060, Natural White + blk paint | $3.60 | $1.50 | 12 | $0.425 | $0.425
6 | 300 | Threaded Insert, M3 x L=6 x OD=4.5 |  |  |  | AliExpress | https://www.aliexpress.us/item/3256805885174058.html | $11.10 |  | 300 | $0.037 | $0.222
0 | 301 | M3 Threaded Spacer, hex, nylon, black, 25mm + 6mm, female-male |  |  |  | AliExpress | https://www.aliexpress.us/item/3256804121267045.html | $4.07 |  | 50 | $0.081 | $0.000
0 | 302 | screw, Cap, M3 x 8mm, black |  |  |  | Amazon | https://www.amazon.com/gp/product/B07CMQ1SQH | $7.86 | $0.61 | 100 | $0.085 | $0.000
1 | 303 | Rocker switch, on-mom |  |  | R4EBLKBLKEF0 | Digikey | https://www.digikey.com/en/products/detail/e-switch/R4EBLKBLKEF0/1805289 | $18.24 | $2.41 | 10 | $2.065 | $2.065
1 | 304 | Rocker switch, on-off |  |  | R4ABLKBLKEF0 | Digikey | https://www.digikey.com/en/products/detail/e-switch/R4ABLKBLKEF0/1805255 | $11.66 | $1.90 | 10 | $1.356 | $1.356
1 | 305 | IC, FPGA, iCE40 HX Field Programmable Gate Array, 144-TQFP |  | Lattice Semiconductor | ICE40HX1K-TQ144 | Digikey/JLCPCB | https://www.digikey.com/en/products/detail/lattice-semiconductor-corporation/ICE40HX1K-TQ144/3083575 | $95.51 | $1.00 | 10 | $9.651 | $9.651
1 | 306 | IC, FLASH, serial, 32Mbit SPI, 108MHZ, 8-SOIC |  | Alliance Memory, Inc. | N25Q032A13ESC40F | Digikey/JLCPCB | https://www.digikey.com/en/products/detail/alliance-memory-inc/N25Q032A13ESC40F/12810023 | $19.00 | $1.00 | 10 | $2.000 | $2.000
0 | 307 | IC REG LINEAR 1.2V 800MA DPAK |  | STMicroelectronics | LD1117DT12CTR | Digikey | https://www.digikey.com/en/products/detail/stmicroelectronics/LD1117DT12CTR/2623278 | $7.50 | $1.58 | 10 | $0.908 | $0.000
0 | 308 | Header Connector Strip, female, 40-pin single Row, 2.54mm, cut to 20 pins |  |  |  | Amazon | https://www.amazon.com/gp/product/B09MYBZZKZ (https://www.amazon.com/gp/product/B07CGGSDWF) | $9.99 | $0.77 | 480 | $0.022 | $0.000
1 | 309 | Raspberry Pi Pico H (SC0917), with pre-soldered headers |  |  |  | Digikey | https://www.digikey.com/en/products/detail/raspberry-pi/SC0917/16608257 | $50.00 | $10.87 | 10 | $6.087 | $6.087
1 | 310 | Single Row 40 Pin 2.54 mm Male Pin Header Connector, cut to 3 pins |  |  |  | Amazon | https://www.amazon.com/gp/product/B06XR8CV8P | $9.99 | $0.77 | 666 | $0.016 | $0.016
2 | 311 | Threaded Insert, M2 |  |  |  | Amazon | https://www.amazon.com/gp/product/B0B8GN63S2 | $8.59 | $0.67 | 100 | $0.093 | $0.185
2 | 312 | connector, 3-pin, 3.96 EP PLUG HSG 3P(BLACK) |  | TE Connectivity AMP Connectors | 5-1123722-3 | Digikey | https://www.digikey.com/en/products/detail/te-connectivity-amp-connectors/5-1123722-3/10467997 | $1.19 | $0.30 | 15 | $0.099 | $0.199
2 | 313 | edge connector, 1PCS, 3.175mm, 2x43 86 pin |  |  |  | AliExpress | https://www.aliexpress.us/item/2255801094078491.html | $30.40 | $3.31 | 10 | $3.371 | $6.742
0 | 314 | servo motor |  |  |  | AliExpress | https://a.aliexpress.com/_mNdt2Is | $9.60 | $2.72 | 10 | $1.232 | $0.000
4 | 315 | M2 x 8mm screw, steel |  |  |  | Amazon | https://www.amazon.com/gp/product/B01M5DVI7A | $9.99 | $0.77 | 120 | $0.090 | $0.359
0 | 316 | M2 Stainless Steel Nylock Self Locking Nut |  |  |  | Amazon | https://www.amazon.com/gp/product/B07L2W3QX3 | $9.99 | $0.77 | 100 | $0.108 | $0.000
1 | 317 | dipswitch, right angle, 4-switch piano type |  | ALINSIN STORE |  | AliExpress | https://www.aliexpress.us/item/3256803055482916.html | $1.03 | $3.32 | 10 | $0.435 | $0.435
2 | 318 | 22AWG 2 Conductor, Low-Voltage Tinned-Copper Wire, 3.5 inch |  |  |  | Amazon | https://www.amazon.com/dp/B07SCJ69H4 | $11.98 | $0.93 | 226 | $0.057 | $0.114
4 | 319 | Nylon Flag Spade Quick Disconnect, 22-18 AWG |  |  |  | Amazon | https://www.amazon.com/dp/B0C625XHQM | $7.99 | $0.62 | 100 | $0.086 | $0.344
1 | 320 | zip-tie, 4-inch, black |  |  |  | Amazon | https://www.amazon.com/Premium-Plastic-Strength-Resistant-Self-Locking/dp/B09H5L583V | $6.99 | $0.54 | 1000 | $0.008 | $0.008
4 | 321 | M2 Phillips Round Pan Head Machine Screws (M2 x 4mm), Stainless Steel |  |  |  | Amazon | https://www.amazon.com/gp/product/B07HFYZ9YM | $7.99 | $0.62 | 100 | $0.086 | $0.344
6 | 322 | M2 split lockwasher |  |  |  | Amazon | https://www.amazon.com/gp/product/B09LLZHY87 | $10.50 | $0.81 | 500 | $0.023 | $0.136
1 | 323 | OLED display module, 128x64, 0.96 inch |  |  |  | AliExpress | https://www.aliexpress.us/item/3256805094941943.html | $16.39 | $1.27 | 11 | $1.605 | $1.605
2 | 324 | M2 Threaded Spacer, hex, nylon, black, 10mm, female-female |  |  |  | AliExpress | https://www.aliexpress.us/item/3256805464087324.html | $2.07 | $0.16 | 50 | $0.045 | $0.089
2 | 325 | M2 nylon flat washer |  |  |  | Amazon | https://www.amazon.com/uxcell-Insulating-Washers-Gaskets-Spacers/dp/B01N6B5KJN | $6.99 | $0.54 | 200 | $0.038 | $0.075
8 | 326 | M3 Threaded Spacer, hex, nylon, black, 12mm, female-female |  |  |  | Amazon | https://www.amazon.com/gp/product/B072LGMRVD | $6.26 | $0.49 | 100 | $0.068 | $0.540
8 | 327 | M3 screw, hex, 6 mm, black |  |  |  | AliExpress | https://www.aliexpress.us/item/3256805242052170.html | $1.19 |  | 40 | $0.030 | $0.238
2 | 328 | M3 self locking nut |  |  |  | Amazon | https://www.amazon.com/Stainless-Self-Locking-Industrial-Construction-Fasteners/dp/B09SLLQ3KV | $7.59 | $0.59 | 150 | $0.055 | $0.109
12 | 329 | Self-Adhesive Clear Rubber Feet, 6mm dia x 2mm thick |  |  |  | Amazon | https://www.amazon.com/gp/product/B073ST7Q27 | $5.28 | $0.41 | 400 | $0.014 | $0.171
0 | 330 | Clevis pin, M3 x 20 |  |  |  | AliExpress | https://www.aliexpress.us/item/2251832744877636.html | $11.08 | $0.86 | 40 | $0.298 | $0.000
8 | 331 | M3 screw, hex, 8 mm, black |  |  |  | AliExpress | https://www.aliexpress.us/item/3256805242052170.html | $1.39 |  | 40 | $0.035 | $0.278
6 | 332 | M3 split lockwasher |  |  |  | Amazon | https://www.amazon.com/gp/product/B07Z2FJ2XW | $9.99 | $0.77 | 500 | $0.022 | $0.129
0 | 333 | 40 signal flat cable, 1 foot segment |  |  |  | Amazon
0 | 334 | M3 x 12mm cap screw, black |  |  |  | Amazon | https://www.amazon.com/gp/product/B07CNFTK99 | $7.86 | $0.61 | 100 | $0.085 | $0.000
0 | 335 | Header Connector Strip, female, 40-pin single Row, 2.54mm, cut to 20 pins |  |  |  | Amazon | https://www.amazon.com/gp/product/B07CGGSDWF | $9.99 | $0.77 | 114.2857143 | $0.094 | $0.000
2 | 336 | Header, 40-pin, right-angle, with ejectors |  | Amphenol ICC (FCI) | 86130402113345E1LF | Digikey | https://www.digikey.com/en/products/detail/amphenol-cs-fci/86130402113345E1LF/5201672 | $31.46 | $7.92 | 22 | $1.790 | $3.580
0 | 337 | IDC flat cable connector |  |  |  | Amazon
2 | 338 | Antistatic bag, 15x20 cm |  |  |  | Amazon | https://www.amazon.com/dp/B07TXD47PZ | $15.39 | $1.19 | 100 | $0.166 | $0.332
5 | 339 | CONN SOCKET Pin, 18-22AWG, crimp tin |  | TE Connectivity AMP Connectors | 1123721-2 | Digikey | https://www.digikey.com/en/products/detail/te-connectivity-amp-connectors/1123721-2/686921 | $4.51 | $1.14 | 32 | $0.176 | $0.882
1 | 340 | CONN HEADER VERT 3POS, 3.96MM |  | TE Connectivity AMP Connectors | 4-1123724-2 | Digikey | https://www.digikey.com/en/products/detail/te-connectivity-amp-connectors/4-1123724-2/5439777 | $1.77 | $0.45 | 15 | $0.148 | $0.148
2 | 341 | CONN HEADER VERT 2x4 Pos, 2.54mm |  |  |  | AliExpress | https://www.aliexpress.us/item/3256805773340189.html | $3.30 | $3.48 | 100 | $0.068 | $0.136
2 | 342 | CONN HEADER VERT 2x8 Pos, 2.54mm |  |  |  | AliExpress | https://www.aliexpress.us/item/3256805773340189.html | $5.99 | $0.46 | 50 | $0.129 | $0.258
1 | 343 | Connector, 4-pin single Row, socket strip, 2.54mm |  |  |  | AliExpress | https://www.aliexpress.us/item/3256803424019097.html | $3.39 | $1.56 | 50 | $0.099 | $0.099
2 | 344 | Connector, 20-pin single row, socket strip, 2.54mm |  |  |  | AliExpress | https://www.aliexpress.us/item/3256803424019097.html | $6.58 | $3.66 | 20 | $0.512 | $1.024
1 | 345 | CONN HEADER VERT 2x5 Pos, 2.54mm |  |  |  | AliExpress | https://www.aliexpress.us/item/3256805773340189.html | $5.99 | $0.46 | 80 | $0.081 | $0.081
1 | 346 | 22AWG 2 Conductor, Low-Voltage Tinned-Copper Wire, 12-inch (30.5 cm) |  |  |  | Amazon | https://www.amazon.com/dp/B07SCJ69H4 | $11.98 | $0.93 | 66 | $0.196 | $0.196
1 | 347 | Flat Cable, 8-pin 2x4 IDC, 10cm |  |  |  | AliExpress | https://www.aliexpress.us/item/3256803248238815.html | $6.38 | $6.49 | 11 | $1.170 | $1.170
1 | 348 | Flat Cable, 16-pin 2x8 IDC, 10cm |  |  |  | AliExpress | https://www.aliexpress.us/item/3256803248238815.html | $8.01 | $6.62 | 11 | $1.330 | $1.330
2 | 349 | Flat Cable, 40-pin 2x20 IDC, 1m |  |  |  | AliExpress | https://www.aliexpress.us/item/3256803248238815.html | $94.80 | $15.24 | 20 | $5.502 | $11.004
0 | 350 | DC-to-DC Converter, 12V input to 5V 10A output |  | LY-KREE | DL240510 | Amazon | https://www.amazon.com/dp/B07Q5XJTMV | $17.79 | $1.38 | 1 | $19.169 | $0.000
0 | 351 | Power Trigger Module, USB Type C, 12V |  |  |  | AliExpress | https://www.aliexpress.us/item/3256802974608811.html | $5.10 | $3.24 | 10 | $0.834 | $0.000
0 | 352 | Single Row 40 Pin 2.54 mm Male Pin Header Connector, cut to 4 pins |  |  |  | Amazon | https://www.amazon.com/gp/product/B06XR8CV8P | $9.99 | $0.77 | 500 | $0.022 | $0.000
0 | 353 | Bolt, 1/4-inch x 0.5 inch |  |  |  | Amazon | https://www.amazon.com/Powlankou-Pieces-Button-Socket-Stainless/dp/B07ZSXD89C | $9.98 | $0.77 | 60 | $0.179 | $0.000
0 | 354 | Nut, 1/4-inch self locking |  |  |  | Amazon | https://www.amazon.com/dp/B06VY6F67P | $9.99 | $0.77 | 100 | $0.108 | $0.000
0 | 355 | M3 nut |  |  |  | AliExpress | https://www.aliexpress.us/item/2255800416538696.html | $3.68 | $2.28 | 220 | $0.027 | $0.000
0 | 356 | Rack Mount Tray, 19-Inch 1U Server, Vented Shelves |  |  |  | Amazon | https://www.amazon.com/gp/product/B01HTG4WHY | $27.78 | $0.77 | 1 | $28.550 | $0.000
0 | 357 | M3 Threaded Spacer, hex, nylon, black, 20mm + 6mm, female-male |  |  |  | Amazon | https://www.aliexpress.us/item/3256804121267045.html | $2.87 | $1.27 | 50 | $0.083 | $0.000
2 | 358 | Fender Washer, M3x16x1.0 mm |  |  |  | AliExpress | https://www.aliexpress.us/item/3256802393168670.html | $4.64 | $0.77 | 80 | $0.068 | $0.135
0 | 359 | DC-to-DC Converter, 12V input to 5V 10A output |  | TOBSUN | EA50-5V | AliExpress | https://www.aliexpress.us/item/3256804612946913.html | $14.10 | $11.38 | 5 | $5.096 | $0.000
0 | 360 | 22AWG 2 Conductor, Low-Voltage Tinned-Copper Wire, 1.5 inch |  |  |  | Amazon | https://www.amazon.com/dp/B07SCJ69H4 | $11.98 | $0.93 | 528 | $0.003 | $0.000
0 | 361 | Flat Cable, 40-pin 2x20 IDC, 30cm |  |  |  | AliExpress | https://www.aliexpress.us/item/3256803248238815.html | $15.50 | $5.79 | 10 | $2.129 | $0.000
0 | 362 | Spade Lug, Fork, 16-22AWG, SV1.25-4, Red |  |  |  | AliExpress | https://www.aliexpress.us/item/2251832658426440.html | $1.23 | $1.14 | 100 | $0.024 | $0.000
0 | 363 | USB Type C Charger, 25W, with USB C to USB C 6 foot cable |  |  |  | Amazon | https://www.amazon.com/dp/B097MVXSQ5 | $9.98 | $0.77 | 2 | $5.377 | $0.000
0 | 364 | 3" x 5" Small Plastic Bags- Reclosable Zip Bags |  |  |  | Amazon | https://www.amazon.com/gp/product/B07XBF98NV | $17.99 | $1.39 | 1000 | $0.019 | $0.000
0 | 365 | Light Shield, thick paper |  |  |  | Hobby Lobby |  | $5.00 | $0.00 | 1000 | $0.005 | $0.000
0 | 366 | Toggle Switch, SPDT, 6A 125V |  |  |  | AliExpress | https://www.aliexpress.us/item/3256804434717398.html | $3.87 | $2.29 | 10 | $0.616 | $0.000
0 | 367 | Antistatic bag, 6x9 cm |  |  |  | AliExpress | https://www.aliexpress.us/item/3256802834769879.html | $0.33 | $3.94 | 50 | $0.085 | $0.000
0 | 368 | Ziplock Sandwich Bag |  |  |  | Costco |  | $0.00 | $0.00 | 1 | $0.000 | $0.000
4 | 369 | M3 Threaded Spacer, hex, nylon, black, 30mm + 6mm, female-male |  |  |  | AliExpress | https://www.aliexpress.us/item/3256804121267045.html | $3.63 | $1.33 | 50 | $0.099 | $0.397
0 | 370 | Flat Cable, 40-pin 2x20 IDC, 20cm |  |  |  | AliExpress | https://www.aliexpress.us/item/3256803248238815.html | $15.50 | $5.79 | 10 | $2.129 | $0.000
0 | 371 | Rectifier, 40V 450mV@5A 5A DO-27 Schottky Barrier Diode |  | Comchip | SR540L | AliExpress | https://www.aliexpress.us/item/3256805591615901.html | $2.73 | $2.20 | 20 | $0.247 | $0.000
0 | 372 | Resistor, 4.7k, 1/4W 5% |  |  |  | AliExpress | https://www.aliexpress.us/item/3256805483572082.html | $0.98 | $2.07 | 100 | $0.030 | $0.000
0 | 373 | Mini Digital Voltmeter |  |  |  | AliExpress | https://www.aliexpress.us/item/3256805856942849.html | $3.00 | $2.22 | 5 | $1.044 | $0.000
 |  | table lookup goes to this row

Sheet: make parts cost by quantity
 | 100 | Emulator Main Board assembled
 | 101 | Front Panel board assembled
 | 102 | microSD card adapter board, assembled
 | 103 | RK05 Emulator Dress Panel
 | 104 | M930GW Terminator Board, assembled
 | 105 | PCB, M993GW RK05 Adapter Card
 | 106 | PCB, RK05 Tester Cable Adapter
 | 107 | PCB, RK05 Power Distribution
100 | Emulator Main Board assembled
 | Qty | PCB | PCBA | Shipping | TOTAL | $/unit
 | Qty | PCB | Comp | Shipping | Tax | TOTAL | $/unit
 | 5 | $89.59 | $80.07 | $23.80 | $14.99 | $208.46 | $41.69
 | 10 | $127.57 | $148.15 | $43.25 | $24.72 | $343.69 | $34.37
 | 15 | $170.85 | $216.22 | $47.56 | $33.68 | $468.31 | $31.22
 | 20 | $214.35 | $284.29 | $47.56 | $42.33 | $588.53 | $29.43
 | 25 | $257.65 | $352.37 | $55.95 | $51.61 | $717.58 | $28.70
 | 30 | $292.73 | $420.44 | $60.87 | $59.99 | $834.03 | $27.80
101 | Front Panel board assembled
 | Qty | PCB | Comp | Shipping | TOTAL | $/unit
 | 5 | $35.57 |  | $22.25 | $57.82 | $11.56
 | 10 | $45.55 |  | $38.11 | $83.66 | $8.37
 | 15 | $55.86 |  | $43.25 | $99.11 | $6.61
 | 20 | $66.85 |  | $47.56 | $114.41 | $5.72
 | 25 | $77.65 |  | $47.56 | $125.21 | $5.01
 | 30 | $85.76 |  | $55.95 | $141.71 | $4.72
102 | microSD card adapter board, assembled
 | Qty | PCB | PCBA | Shipping | TOTAL | $/unit
 | 5 | $3.10 | $13.34 | $1.50 | $17.94 | $3.59
 | 10 | $6.10 | $14.32 | $1.50 | $21.92 | $2.19
 | 20 | $6.00 | $16.25 | $11.27 | $33.52 | $1.68
 | 30 | $6.40 | $18.20 | $13.81 | $38.41 | $1.28
 | 50 |  |  |  | $0.00 | $0.00
 | 100 |  |  |  | $0.00 | $0.00
 | 200 |  |  |  | $0.00 | $0.00
103 | RK05 Emulator Dress Panel
 | Qty | PCB | PCBA | Shipping | TOTAL | $/unit
 | 5 | $9.30 | $0.00 | $1.50 | $10.80 | $2.16
 | 10 | $13.50 | $0.00 | $13.76 | $27.26 | $2.73
 | 20 | $21.80 | $0.00 | $20.05 | $41.85 | $2.09
 | 30 | $30.30 | $0.00 | $27.81 | $58.11 | $1.94
 | 50 |  | $0.00 |  | $0.00 | $0.00
 | 100 |  | $0.00 |  | $0.00 | $0.00
 | 200 |  | $0.00 |  | $0.00 | $0.00
104 | M930GW Terminator Board, assembled
 | Qty | PCB | PCBA | Shipping | TOTAL | $/unit
 | 5 | $23.50 | $23.20 | $20.22 | $66.92 | $13.38
 | 10 | $27.20 | $26.61 | $30.08 | $83.89 | $8.39
 | 20 | $34.60 | $34.47 | $34.34 | $103.41 | $5.17
 | 30 | $42.10 | $41.95 | $38.59 | $122.64 | $4.09
 | 50 |  | $0.00 |  | $0.00 | $0.00
 | 100 |  | $0.00 |  | $0.00 | $0.00
 | 200 |  | $0.00 |  | $0.00 | $0.00
105/106 | PCB, M993GW RK05 Adapter Card/PCB, RK05 Tester Cable Adapter (These two boards are the same size and have ENIG surface finish.) |  |  |  |  |  |  | 105/106 | PCB, M993GW RK05 Adapter Card/PCB, RK05 Tester Cable Adapter (These two boards are the same size and have ENIG surface finish.)
 | Qty | PCB | PCBA | Shipping | TOTAL | $/unit |  |  | Qty | PCB | PCBA | Shipping | TOTAL | $/unit
 | 5 | $27.70 | $0.00 | $13.81 | $41.51 | $8.30 |  |  | 5 | $27.70 | $0.00 | $17.80 | $45.50 | $9.10
 | 10 | $35.60 | $0.00 | $21.16 | $56.76 | $5.68 |  |  | 10 | $35.60 | $0.00 | $25.80 | $61.40 | $6.14
 | 20 | $51.50 | $0.00 | $30.08 | $81.58 | $4.08 |  |  | 15 | $43.50 | $0.00 | $25.80 | $69.30 | $4.62
 | 30 | $67.30 | $0.00 | $34.34 | $101.64 | $3.39 |  |  | 20 | $51.40 | $0.00 | $42.63 | $94.03 | $4.70
 | 50 | $80.80 | $0.00 | $50.35 | $131.15 | $2.62 |  |  | 25 | $59.20 | $0.00 | $43.25 | $102.45 | $4.10
 | 100 | $133.50 | $0.00 | $74.83 | $208.33 | $2.08 |  |  | 30 | $67.10 | $0.00 | $43.25 | $110.35 | $3.68
 | 200 | $238.70 | $0.00 | $138.56 | $377.26 | $1.89
107 | PCB, RK05 Power Distribution |  |  |  |  |  |  | 107 | PCB, RK05 Power Distribution
 | Qty | PCB | PCBA | Shipping | TOTAL | $/unit |  |  | Qty | PCB | PCBA | Shipping | TOTAL | $/unit
 | 5 | $3.20 | $0.00 | $1.50 | $4.70 | $0.94 |  |  | 5 | $3.20 | $0.00 | $17.80 | $21.00 | $4.20
 | 10 | $6.40 | $0.00 | $13.30 | $19.70 | $1.97 |  |  | 10 | $6.40 | $0.00 | $17.80 | $24.20 | $2.42
 | 20 | $17.50 | $0.00 | $19.89 | $37.39 | $1.87 |  |  | 15 | $14.30 | $0.00 | $25.80 | $40.10 | $2.67
 | 30 | $23.60 | $0.00 | $25.04 | $48.64 | $1.62 |  |  | 20 | $17.50 | $0.00 | $25.80 | $43.30 | $2.17
 | 50 | $33.80 | $0.00 | $30.08 | $63.88 | $1.28 |  |  | 25 | $20.60 | $0.00 | $25.80 | $46.40 | $1.86
 | 100 | $52.70 | $0.00 | $43.84 | $96.54 | $0.97 |  |  | 30 | $23.60 | $0.00 | $25.80 | $49.40 | $1.65
 | 200 | $90.70 | $0.00 | $74.83 | $165.53 | $0.83
