G-Wiley/RK05_Emulator_Tester_System_v1/E1_RK05_Emulator_Tester/Board_Front_Panel/RK05_Front_Panel v3/BOM_RK05-Front-Panel-v3_2024-02-04.csv

ID | Name | Designator | Footprint | Quantity | Manufacturer Part | Manufacturer | Supplier | Supplier Part | Price
1 | Header_8x2_0.1_inch | J17 | HEADER_8X2_0.1_INCH_FP | 1
2 | 220Ω | R1,R7 | R0603 | 2 | 0603WAF2200T5E | UNI-ROYAL(厚声) | LCSC | C22962 | 0.001
3 | KT-0603R | LED9,LED10 | LED0603-RD | 2 | KT-0603R | KENTO | LCSC | C2286 | 0.006
4 | C440445_CORRECTED_GW | LED6,LED7,LED8,LED5,LED1,LED2,LED3,LED4 | LED-SMD_L3.2-W2.8-R-RD-GW | 8 | TJ-S3528UG6W9TLC3DW-A5 | TOGIALED(统佳) | LCSC | C440445 | 0.033
5 | 10kΩ | R8,R9,R10,R21,R2,R3,R4,R5 | R0603 | 8 | 0603WAF1002T5E | UNI-ROYAL(厚声) | LCSC | C25804 | 0.001
6 | 0Ω | R19,R20 | R0603 | 2 | 0603WAF0000T5E | UNI-ROYAL(厚声) | LCSC | C21189 | 0.001
7 | 100nF | C2,C3,C4 | C0603 | 3 | CC0603KRX7R9BB104 | YAGEO(国巨) | LCSC | C14663 | 0.002
8 | 10uF | C5 | C0603 | 1 | CL10A106KP8NNNC | SAMSUNG(三星) | LCSC | C19702 | 0.006
9 | PCA9557PW,118 | U1 | TSSOP-16_L5.0-W4.4-P0.65-LS6.4-BL | 1 | PCA9557PW,118 | NXP(恩智浦) | LCSC | C141380 | 0.489
10 | MC74ACT541DTR2G | U2 | TSSOP-20_L6.5-W4.4-P0.65-LS6.4-BL | 1 | MC74ACT541DTR2G | onsemi(安森美) | LCSC | C8112 | 0.59
11 | 120Ω | R11,R12,R13,R14,R15,R16,R17,R26 | R0805 | 8 | 0805W8F1200T5E | UNI-ROYAL(厚声) | LCSC | C17437 | 0.002
