G-Wiley/RK05_Emulator_Tester_System_v1/E1_RK05_Emulator_Tester/Board_microSD_adapter/RK05_emulator_microSD_board_v1/BOM_PCB_RK05 microSD board v1_2024-01-14.csv

ID | Name | Designator | Footprint | Quantity | Manufacturer Part | Manufacturer | Supplier | Supplier Part | Price
1 | 100nF | C1 | C0603 | 1 | CC0603KRX7R9BB104 | YAGEO(国巨) | LCSC | C14663 | 0.002
2 | TF-01A | CARD1 | TF-SMD_TF-01A | 1 | TF-01A | 韩国韩荣 | LCSC | C91145 | 0.175
3 | 10kΩ | R1 | R0603 | 1 | 0603WAF1002T5E | UNI-ROYAL(厚声) | LCSC | C25804 | 0.001
