G-Wiley/RK05_Emulator_Tester_System_v1/T1_M930GW_Terminator_Board/M930GW_Terminator_Board_v0/BOM_PCB_M930GW v0_2023-05-24.csv

ID | Name | Designator | Footprint | Quantity | Manufacturer Part | Manufacturer | Supplier | Supplier Part | Price
1 | 470nF | C8,C9,C4,C5,C6,C7 | C0603 | 6 | CL10B474KA8NNNC | SAMSUNG(三星) | LCSC | C1623 | 0.007
2 | 47uF | C1A | C1210 | 1 | LMK325BJ476MM-T | TAIYO YUDEN(太诱) | LCSC | C92824 | 0.214
3 | 1nF | C2,C3 | C0603 | 2 | CL10B102KB8NNNC | SAMSUNG(三星) | LCSC | C1588 | 0.003
4 | 178Ω | R1,R3,R5,R7,R9,R11,R13,R15,R17,R19,R21,R23,R25,R27,R29,R31,R33,R35,R37,R39,R41,R43,R45,R47,R49,R51,R53,R55,R58,R60,R62,R64,R66,R70,R72,R74,R76,R78,R80,R82,R84,R86,R88,R90,R92,R94,R96,R98,R100,R102,R104,R106,R108,R110 | R1206 | 54 | WR12X1780FTL | Walsin(华新科) | LCSC | C368153 | 0.004
5 | 383Ω | R2,R4,R6,R8,R10,R12,R14,R16,R18,R20,R22,R24,R26,R28,R30,R32,R34,R40,R42,R44,R46,R48,R50,R52,R54,R57,R59,R61,R63,R65,R67,R68,R69,R71,R73,R77,R79,R83,R85,R87,R89,R91,R93,R95,R97,R99,R101,R103,R105,R107,R109 | R0603 | 51 | 0603WAF3830T5E | UNI-ROYAL(厚声) | LCSC | C23036 | 0.001
