G-Wiley/RK05_Emulator_Tester_System_v1/E1_RK05_Emulator_Tester/Board_Main/RK05_emulator_main_board_v1/BOM_RK05-Emulator-v1-r04_2024-02-04.csv

ID | Name | Designator | Footprint | Quantity | Manufacturer Part | Manufacturer | Supplier | Supplier Part | Price
1 | 100kΩ | R29 | R0603 | 1 | 0603WAF1003T5E | UNI-ROYAL(厚声) | LCSC | C25803 | 0.001
2 | 10kΩ | R30,R20,R17,R8,R16,R14,R15,R1,R2,R3,R4,R6,R27,R11,R12 | R0603 | 15 | 0603WAF1002T5E | UNI-ROYAL(厚声) | LCSC | C25804 | 0.001
3 | 1kΩ | R31 | R0603 | 1 | 0603WAF1001T5E | UNI-ROYAL(厚声) | LCSC | C21190 | 0.001
4 | TPS3808G01DBVR | U19 | SOT-23-6_L2.9-W1.6-P0.95-LS2.8-BR | 1 | TPS3808G01DBVR | TI(德州仪器) | LCSC | C19653 | 0.349
5 | 0Ω | R10 | R0603 | 1 | 0603WAF0000T5E | UNI-ROYAL(厚声) | LCSC | C21189 | 0.001
6 | SKRPASE010 | SW1 | KEY-SMD_4P-L4.2-W3.2-P2.20-LS4.6 | 1 | SKRPASE010 | ALPSALPINE(阿尔卑斯阿尔派) | LCSC | C470427 | 0.123
7 | 22kΩ | R28,R26 | R0603 | 2 | 0603WAF2202T5E | UNI-ROYAL(厚声) | LCSC | C31850 | 0.001
8 | 100Ω | R7,R23,R24 | R0603 | 3 | 0603WAF1000T5E | UNI-ROYAL(厚声) | LCSC | C22775 | 0.001
9 | FC-2012HRK-620D | LED1 | LED0805-R-RD | 1 | NCD0805R1 | 国星光电 | LCSC | C84256 | 0.014
10 | 150Ω | R21 | R0603 | 1 | 0603WAF1500T5E | UNI-ROYAL(厚声) | LCSC | C22808 | 0.001
11 | SN75451BD-Logic | U20,U11,U4,U5,U6,U7,U8,U9,U10,U12 | SOIC-8_L5.0-W4.0-P1.27-LS6.0-BL | 10 | SN75451 | Texas Instruments | LCSC | C354464 | 0.676
12 | 4.7kΩ | R19 | R0603 | 1 | 0603WAF4701T5E | UNI-ROYAL(厚声) | LCSC | C23162 | 0.001
13 | MBR120LSF | D2 | SOD-123_L2.8-W1.8-LS3.7-RD | 1 | MBR120LSF | SHIKUES(时科) | LCSC | C130880 | 0.036
14 | 240Ω | R18 | R0603 | 1 | 0603WAF2400T5E | UNI-ROYAL(厚声) | LCSC | C23350 | 0.001
15 | RK05_Emulator_iCE40HX1K | U1 | TQFP-144_L20.0-W20.0-P0.50-LS22.0-BL-EP7.2 | 1 | iCE40HX1K-TQ144 | Lattice Semiconductor | Digi-Key | iCE40HX1K-TQ144
16 | 40MHz | X1 | OSC-SMD_4P-L5.0-W3.2-BL_SG-8101CB | 1 | SG-8101CB 40.000000MHz TBGSA | EPSON(爱普生) | LCSC | C390561 | 1.294
17 | 100nF | C47,C34,C1,C2,C3,C4,C5,C6,C9,C10,C11,C12,C13,C14,C15,C16,C17,C18,C19,C20,C21,C22,C28,C29,C30,C31,C32,C33,C36,C37,C38,C39,C40,C41,C42,C43,C44,C45,C46 | C0603 | 39 | CC0603KRX7R9BB104 | YAGEO(国巨) | LCSC | C14663 | 0.002
18 | W9825G6KH-6 | U2 | TSOP-54_L22.2-W10.2-P0.80-LS11.8-BL | 1 | W9825G6KH-6 | WINBOND(华邦) | LCSC | C62246 | 1.344
19 | 10uF | C23,C24,C25,C26 | C0603 | 4 | CL10A106KP8NNNC | SAMSUNG(三星) | LCSC | C19702 | 0.006
20 | B5819W_C8598 | D1 | SOD-123_L2.7-W1.6-LS3.7-RD-1 | 1 | B5819W SL | CJ(江苏长电/长晶) | LCSC | C8598 | 0.029
21 | FPC-05F-8PH15 | FPC1 | FPC-SMD_8P-P0.50_XUNPU_FPC-05F-8PH15 | 1 | FPC-05F-8PH15 | XUNPU(讯普) | LCSC | C2856815 | 0.091
22 | N25Q032A13ESC40F | U3 | SOIC-8_L5.0-W4.0-P1.27-LS6.0-BL | 1 | N25Q032A13ESC40F | Micron | Digi-Key | 1450-N25Q032A13ESC40FCT-ND
23 | SN74LVC244ADWR | U13,U14,U15 | SOIC-20_L13.0-W7.6-P1.27-LS10.3-BL | 3 | SN74LVC244ADWR | Texas Instruments | LCSC | C507250 | 0.368
24 | LD1117DT33CTR | U16 | TO-252-2_L6.5-W6.1-P4.58-LS10.0-TL | 1 | LD1117DT33CTR | ST(意法半导体) | LCSC | C36395 | 0.198
25 | LD1117DT12CTR | U17 | TO-252-3_L6.5-W5.8-P4.58-BL | 1 | LD1117DT12CTR | ST(意法半导体) | LCSC | C81188 | 0.2
