G-Wiley/RK05_Emulator_Tester_System_v1/E1_RK05_Emulator_Tester/3D_printed_parts/200_RK05_Lamp_Lens_v04.stl

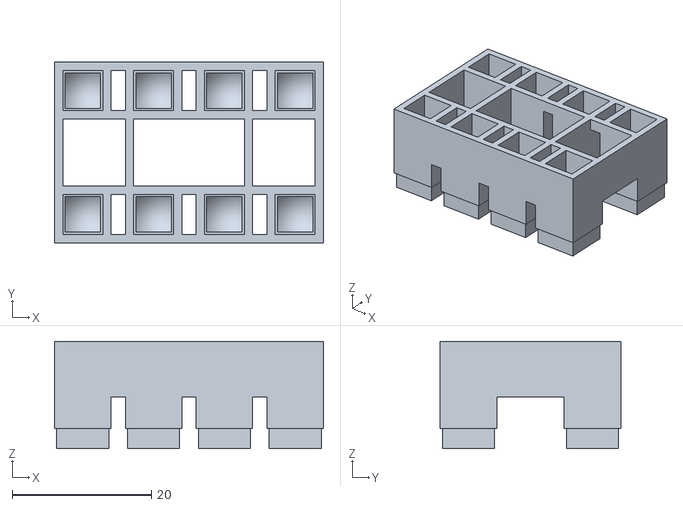
[picture p40: CAD file, 2024-09-26]
E1_RK05_Emulator_Tester/3D_printed_parts/200_RK05_Lamp_Lens_v04.stl
38.6 x 25.9 x 15.4
