G-Wiley/RK05_Emulator_Tester_System_v1/E1_RK05_Emulator_Tester/3D_printed_parts/202_RK05em_connector_filler_v05.stl

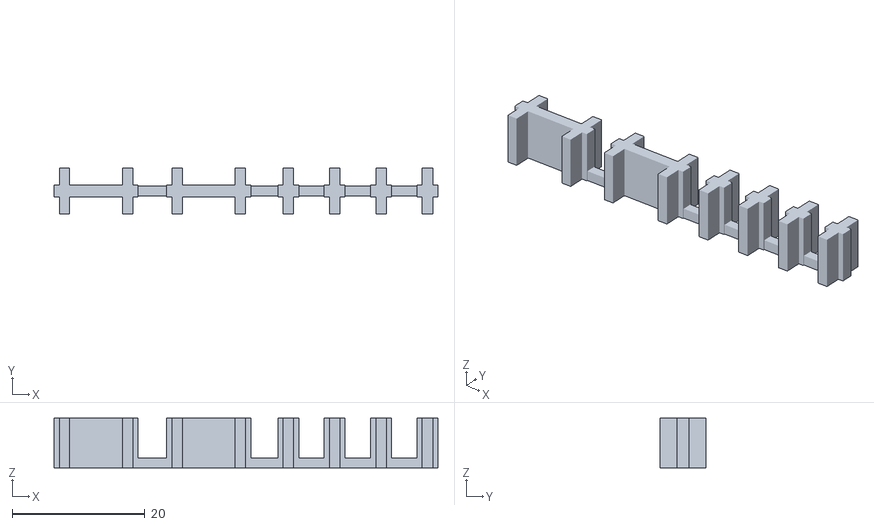
[picture p41: CAD file, 2024-05-08]
E1_RK05_Emulator_Tester/3D_printed_parts/202_RK05em_connector_filler_v05.stl
57.9 x 7.01 x 7.51
