G-Wiley/RK05_Emulator_Tester_System_v1/E1_RK05_Emulator_Tester/3D_printed_parts/3D_print_design_files/201_RK05em_Bezel_v05.3mf

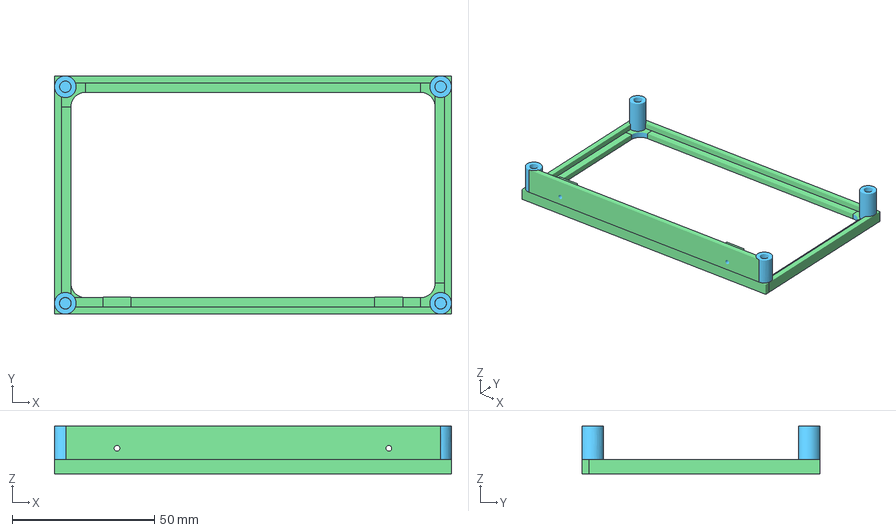
[picture p42: CAD file, 2024-05-12]
E1_RK05_Emulator_Tester/3D_printed_parts/3D_print_design_files/201_RK05em_Bezel_v05.3mf
139.7 x 83.8 x 16.8 mm
