G-Wiley/RK05_Emulator_Tester_System_v1/E1_RK05_Emulator_Tester/3D_printed_parts/204_sd_card_carrier_v19.stl

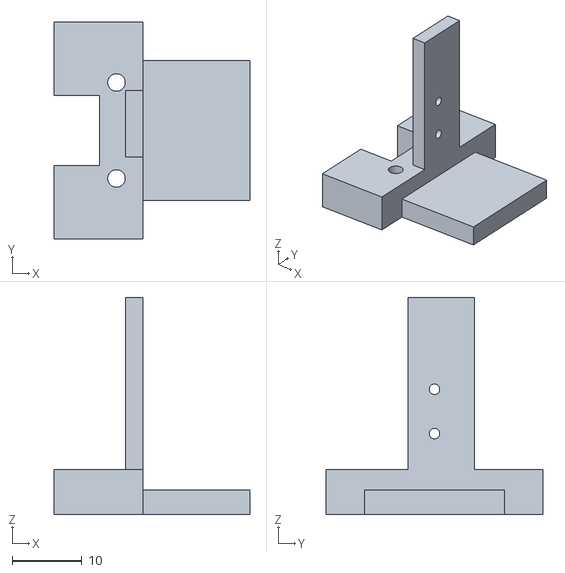
[picture p43: CAD file, 2024-05-08]
E1_RK05_Emulator_Tester/3D_printed_parts/204_sd_card_carrier_v19.stl
27.9 x 31.0 x 31.0
