G-Wiley/RK05_Emulator_Tester_System_v1/E1_RK05_Emulator_Tester/3D_printed_parts/207_Light_Shield1_v03.stl

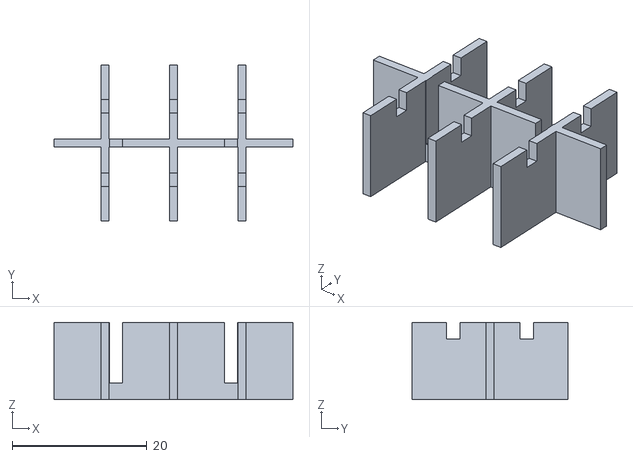
[picture p44: CAD file, 2024-05-08]
E1_RK05_Emulator_Tester/3D_printed_parts/207_Light_Shield1_v03.stl
35.5 x 23.2 x 11.5
