G-Wiley/RK05_Emulator_Tester_System_v1/E1_RK05_Emulator_Tester/3D_printed_parts/3D_print_design_files/205_M993_Cable_Clamp_v03.3mf

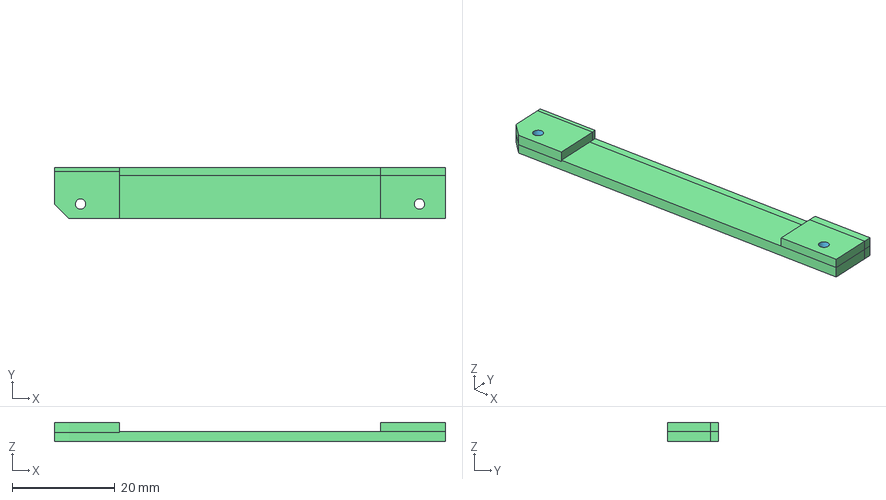
[picture p45: CAD file, 2024-05-11]
E1_RK05_Emulator_Tester/3D_printed_parts/3D_print_design_files/205_M993_Cable_Clamp_v03.3mf
76.2 x 10.0 x 3.73 mm
