G-Wiley/RK05_Emulator_Tester_System_v1/E1_RK05_Emulator_Tester/3D_printed_parts/200_RK05_Lamp_Lens_v03.stl

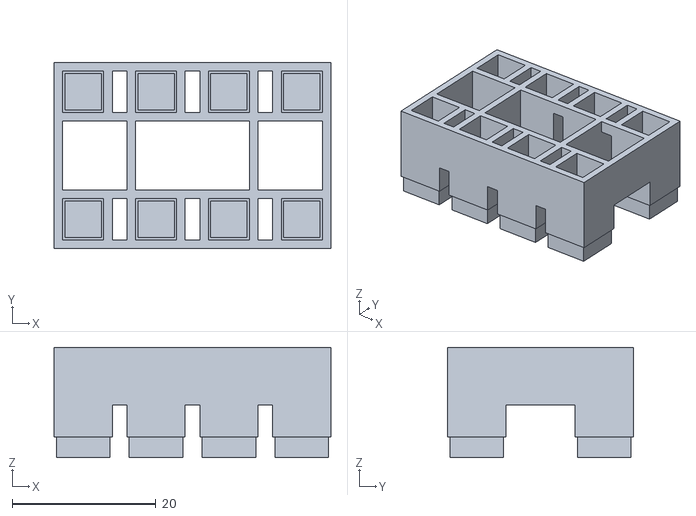
[picture p46: CAD file, 2024-05-08, an earlier design]
E1_RK05_Emulator_Tester/3D_printed_parts/200_RK05_Lamp_Lens_v03.stl
38.6 x 25.9 x 15.4
