G-Wiley/RK05_Emulator_Tester_System_v1/(list of files, cad)

Other CAD files:
E1_RK05_Emulator_Tester/3D_printed_parts/3D_print_design_files/200_RK05_Lamp_Lens_v04.3mf
E1_RK05_Emulator_Tester/3D_printed_parts/3D_print_design_files/204_sd_card_carrier_v19.3mf
E1_RK05_Emulator_Tester/3D_printed_parts/3D_print_design_files/202_RK05em_connector_filler_v05.3mf
E1_RK05_Emulator_Tester/3D_printed_parts/205_M993_Cable_Clamp_v03.stl
E1_RK05_Emulator_Tester/3D_printed_parts/3D_print_design_files/207_Light_Shield1_v03.3mf
E1_RK05_Emulator_Tester/3D_printed_parts/3D_print_design_files/200_RK05_Lamp_Lens_v03.3mf
