G-Wiley/RK05_Emulator_Tester_System_v1/A6_RK05_Tester_Cable_Adapter_Board_no_cables/RK05_Tester_Cable_Adapter_Board_v1/RK05_Tester_Cable_Adapter_Board_v1_ordering_instructions.pdf

RK05_Tester_Cable_Adapter_Board_v1_ordering_instructions_v00.docx | page 1

A6 RK05 Tester Cable Adapter Board v1 ordering instructions
The following instructions serve as a guide to order RK05 Tester Cable Adapter Board printed circuit boards directly from JLCPCB.
Since building this board requires soldering only a small number of through-hole parts and some minor mechanical assembly, there is no need to have JLCPCB perform any of the assembly.
JLCPCB ordering options that are dierent from the default options:
- Click “Add gerber file” and upload the Gerber file: “Gerber_RK05-Tester-Cable-Adapter-v1_2024-05-04.zip”
- PCB Qty: select the desired quantity
- Surface Finish: ENIG
- Gold Fingers: Yes
- 30° finger chamfered: Yes
- Click “SAVE TO CART”
- Click "View Cart”
- Click "Secure Checkout” and enter the requested information. Choose the Shipping Method that best suits your delivery time and cost goals.
