G-Wiley/RK05_Emulator_Tester_System_v1/schematics_E1/schematics_v1_hardware/RK05_Emulator-Tester_Main_Board_v1.pdf

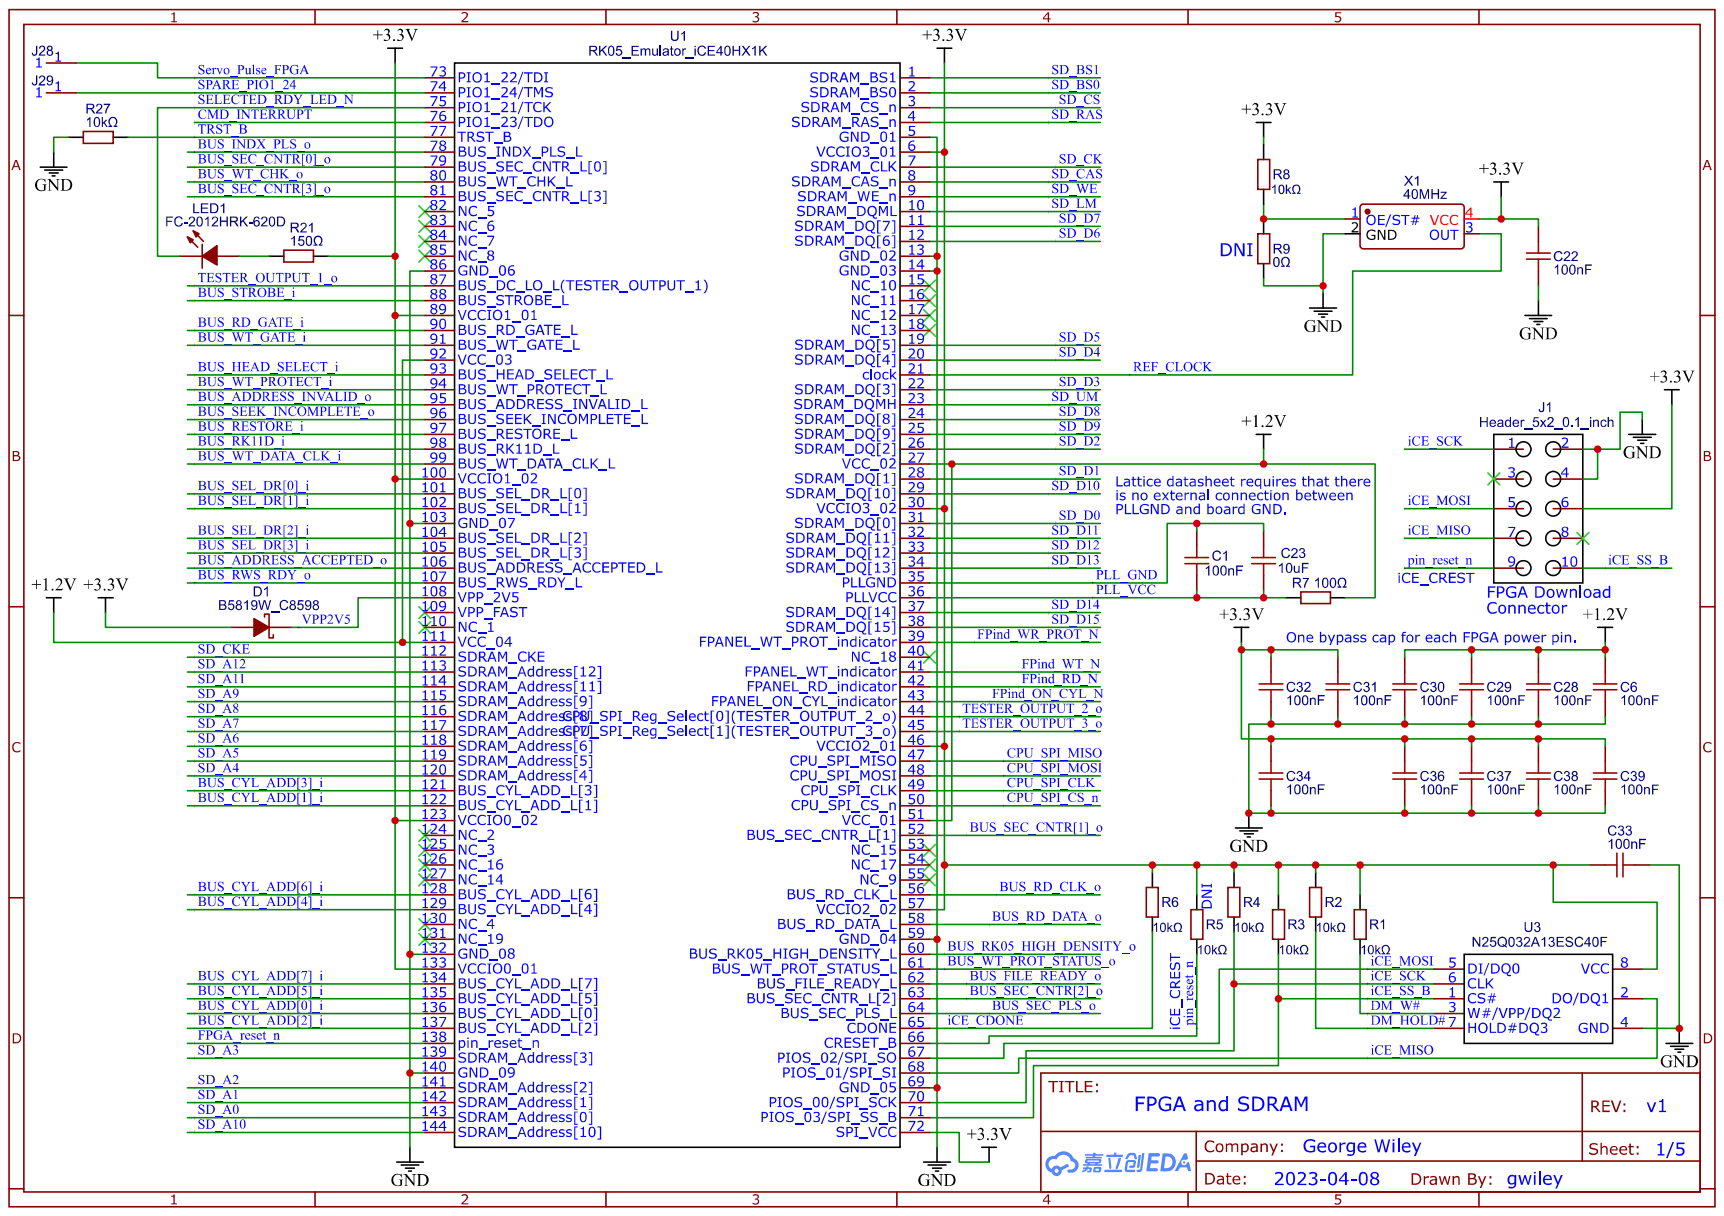
[picture p49: page 1]

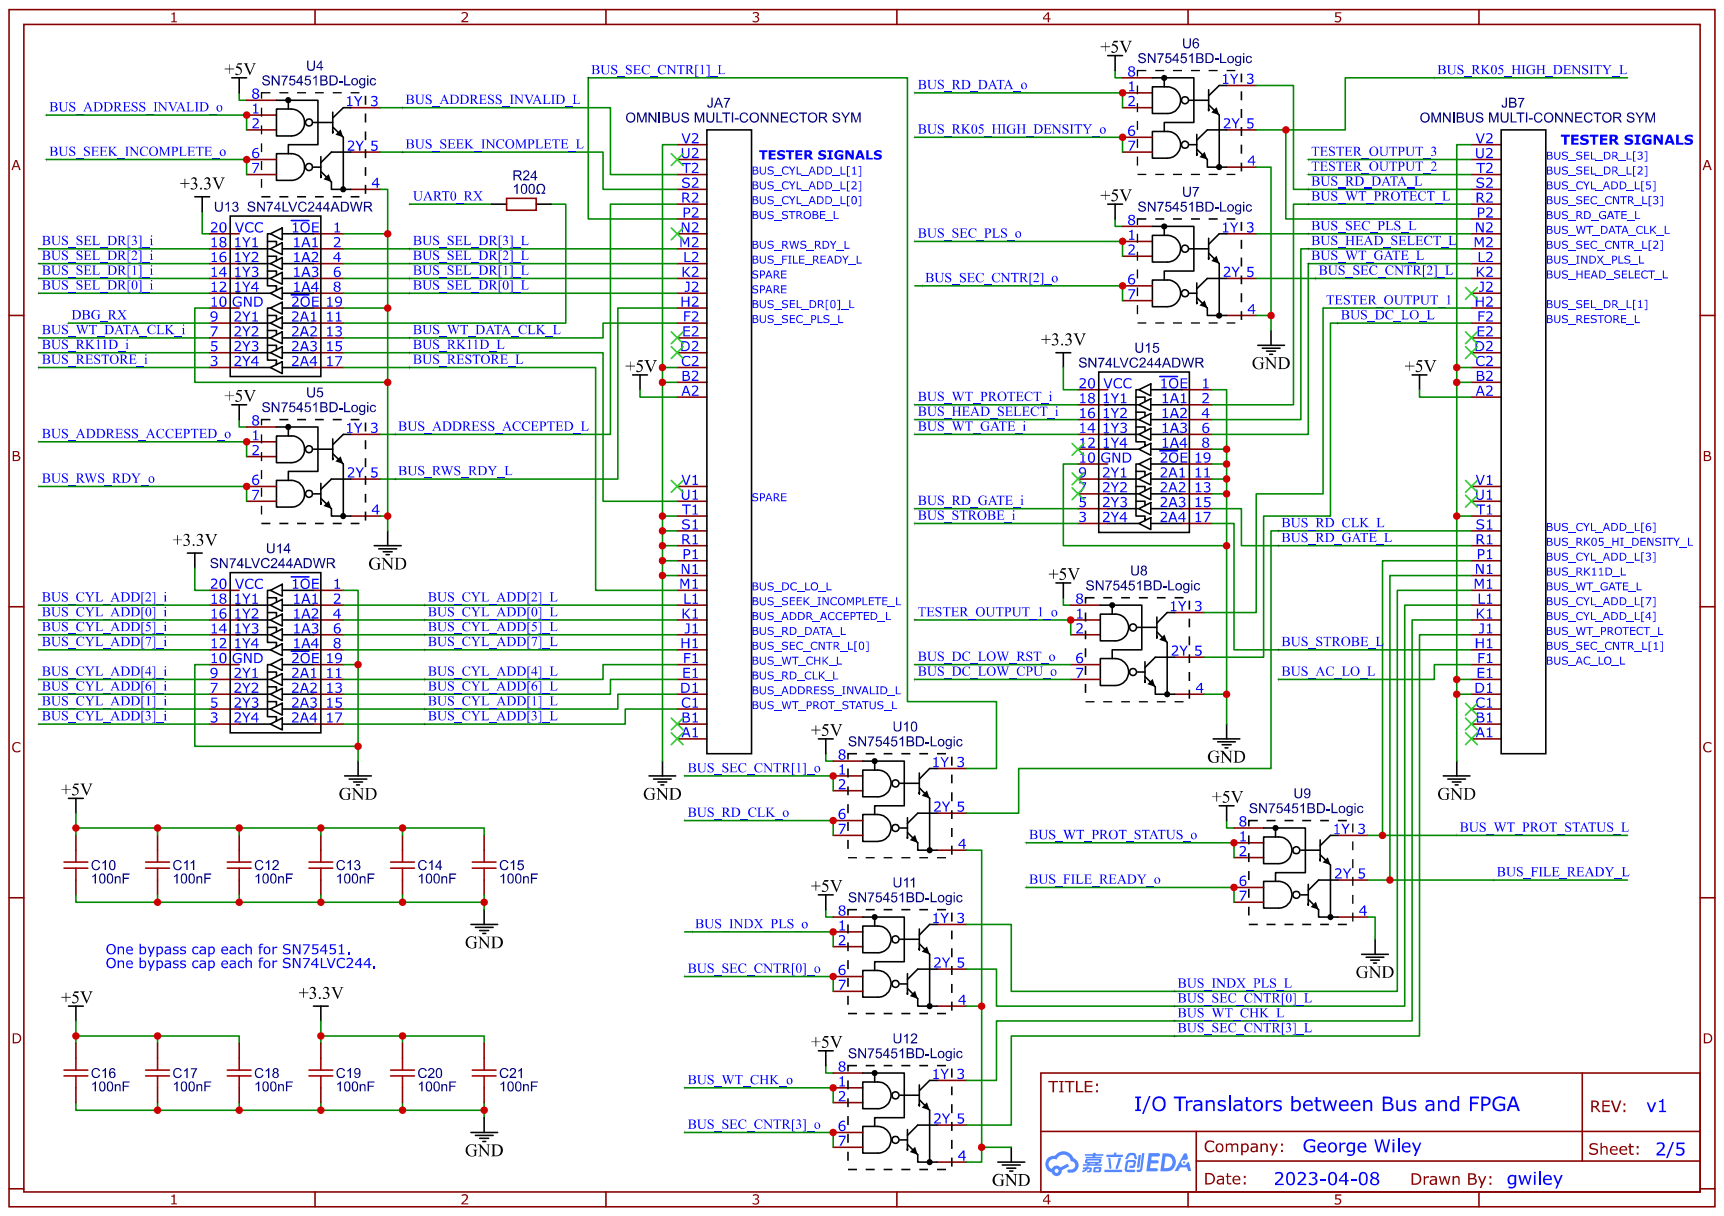
[picture p50: page 2]

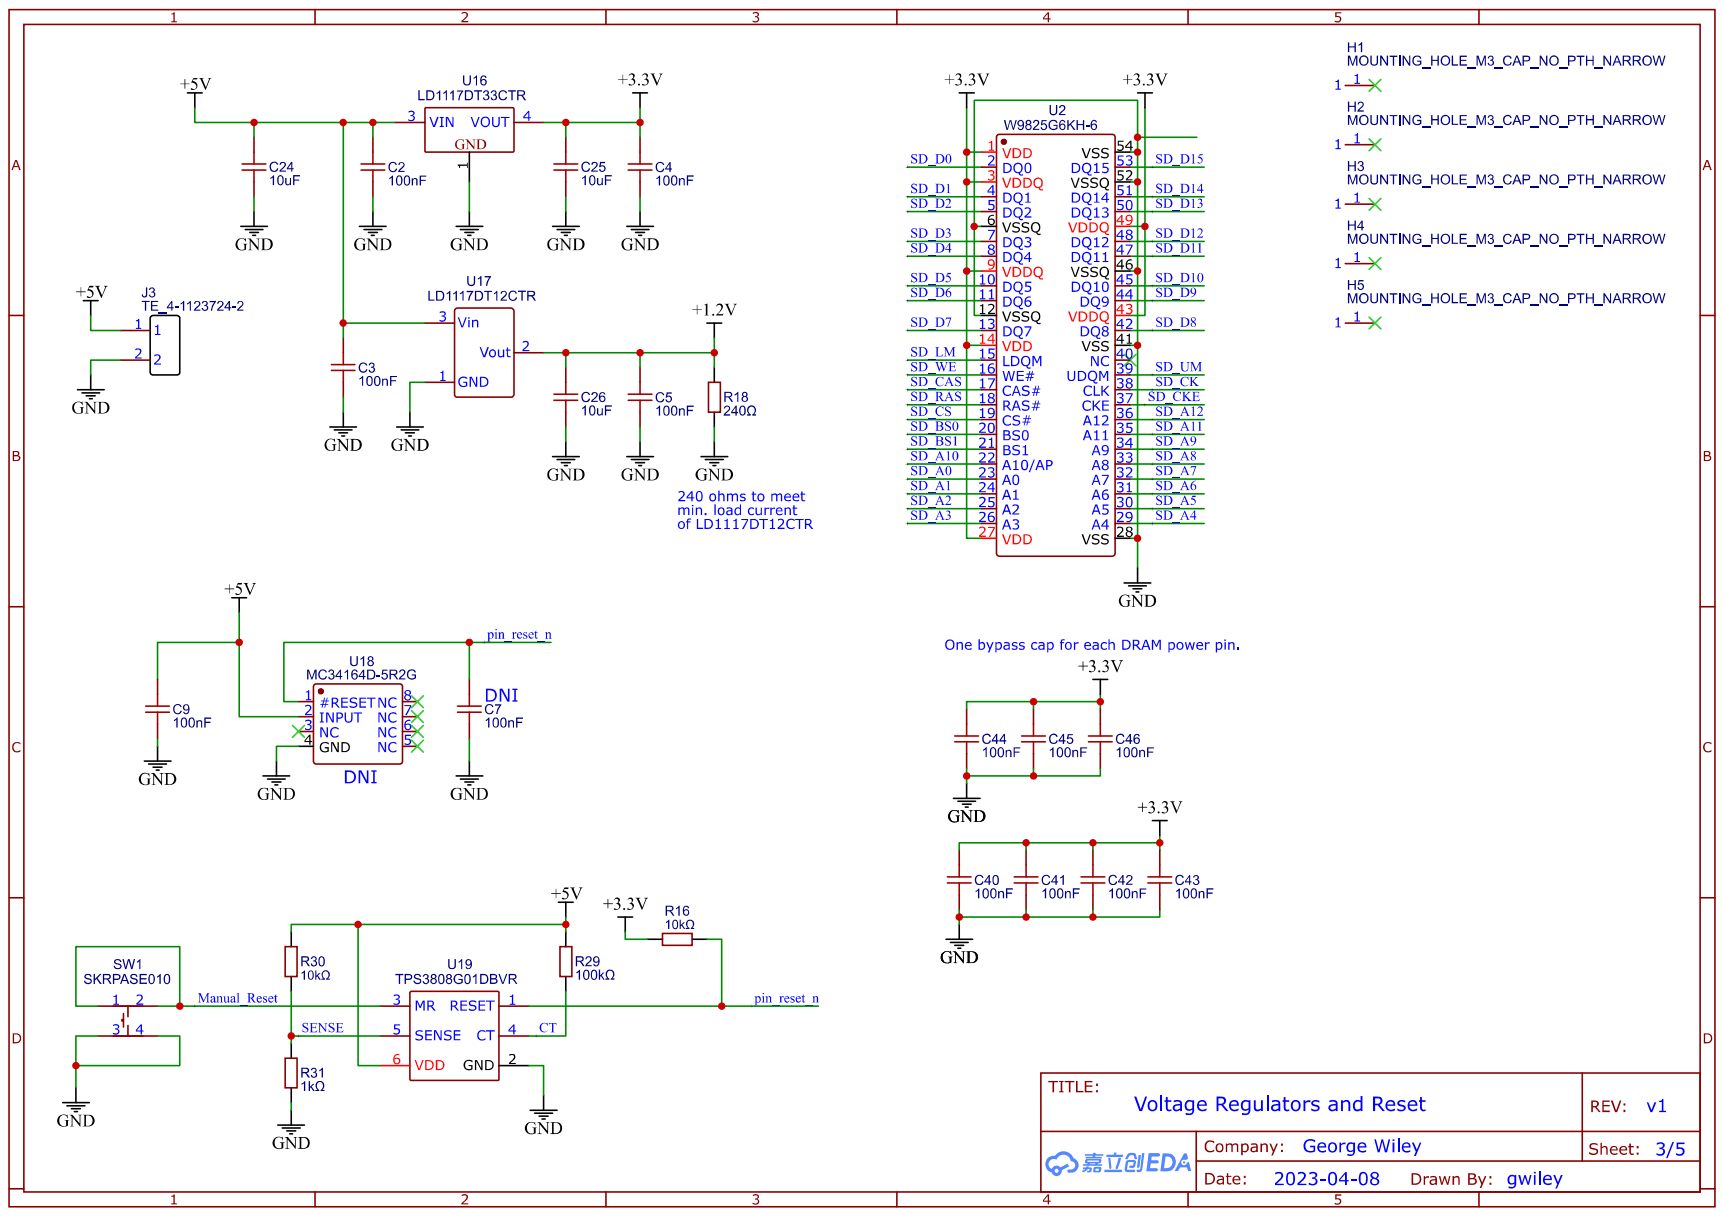
[picture p51: page 3]

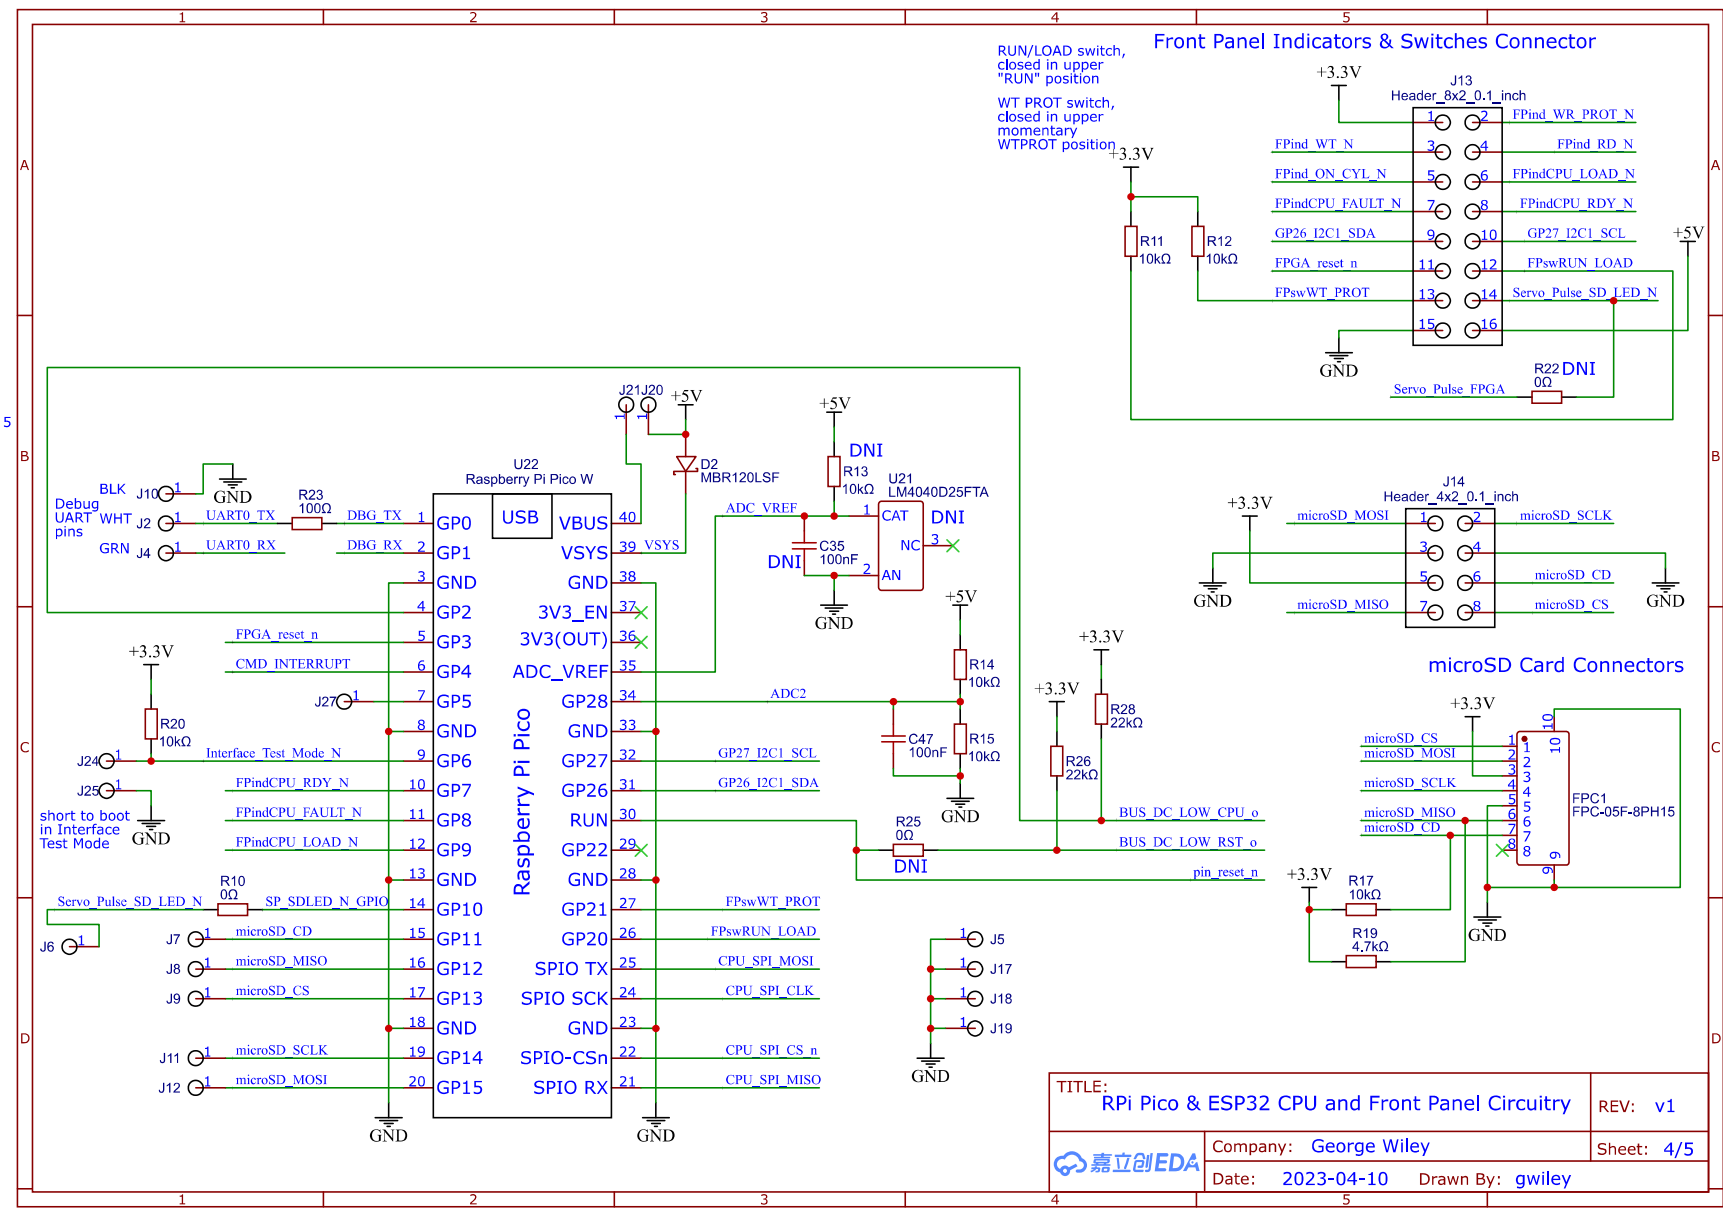
[picture p52: page 4]

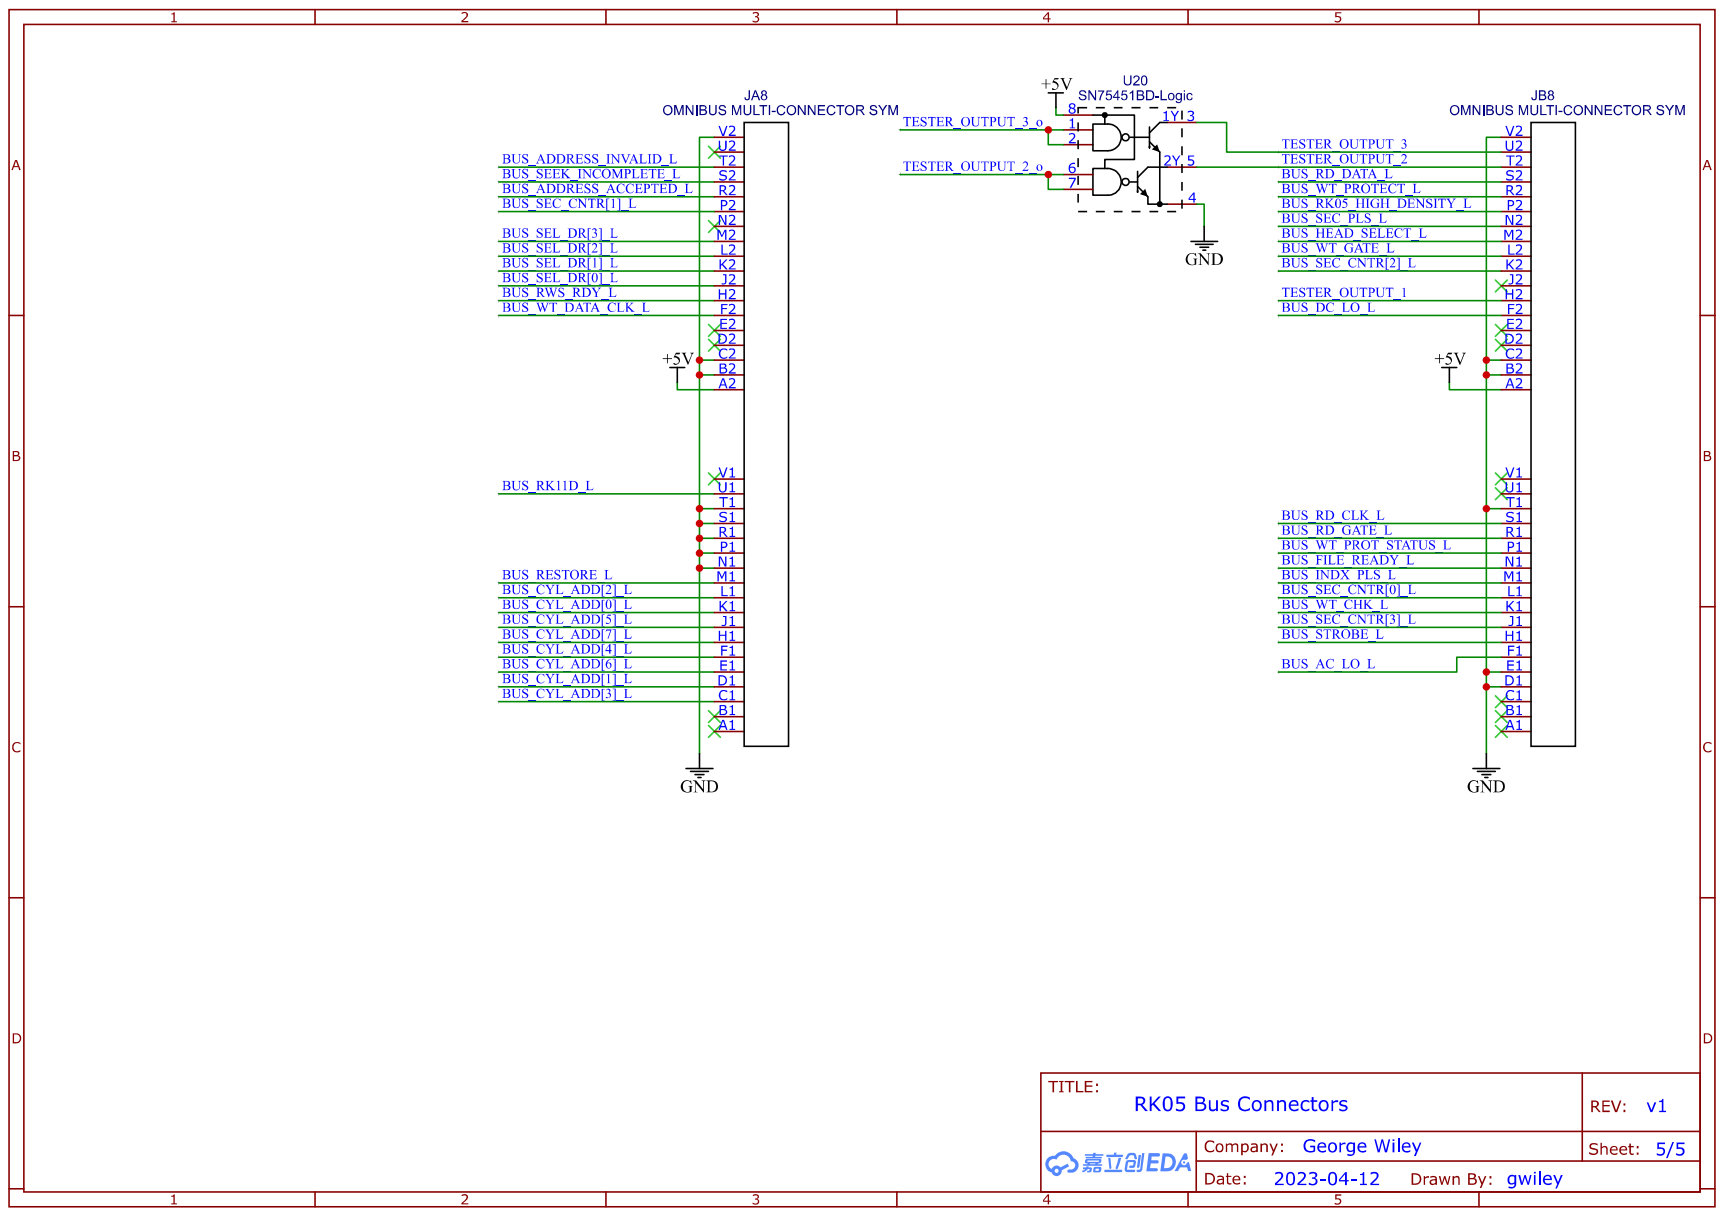
[picture p53: page 5]
