G-Wiley/RK05_Emulator_Tester_System_v1/schematics_E1/schematics_v1_hardware/RK05_Emulator_microSD_board_v1.pdf

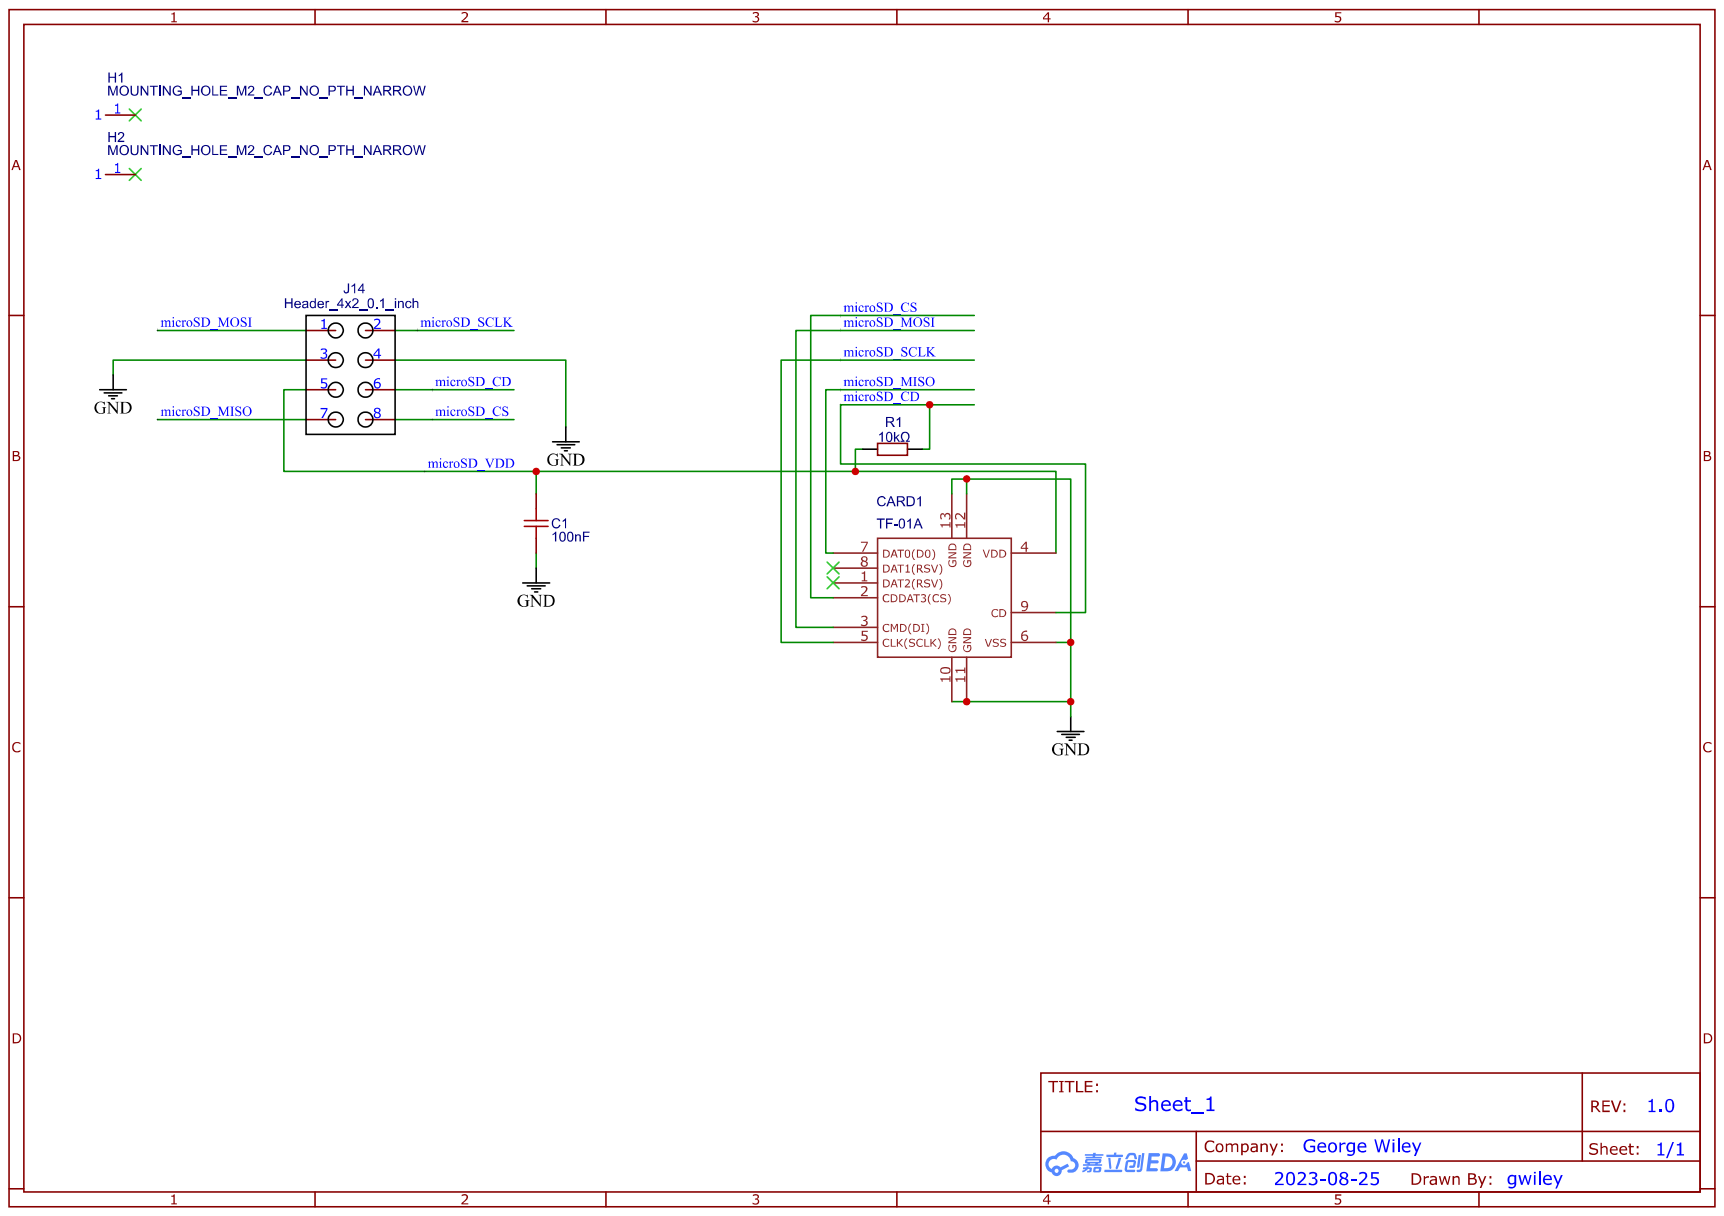
[picture p54: page 1]
