G-Wiley/RK05_Emulator_Tester_System_v1/schematics_E1/schematics_v1_hardware/RK05_Front_Panel_v3.pdf

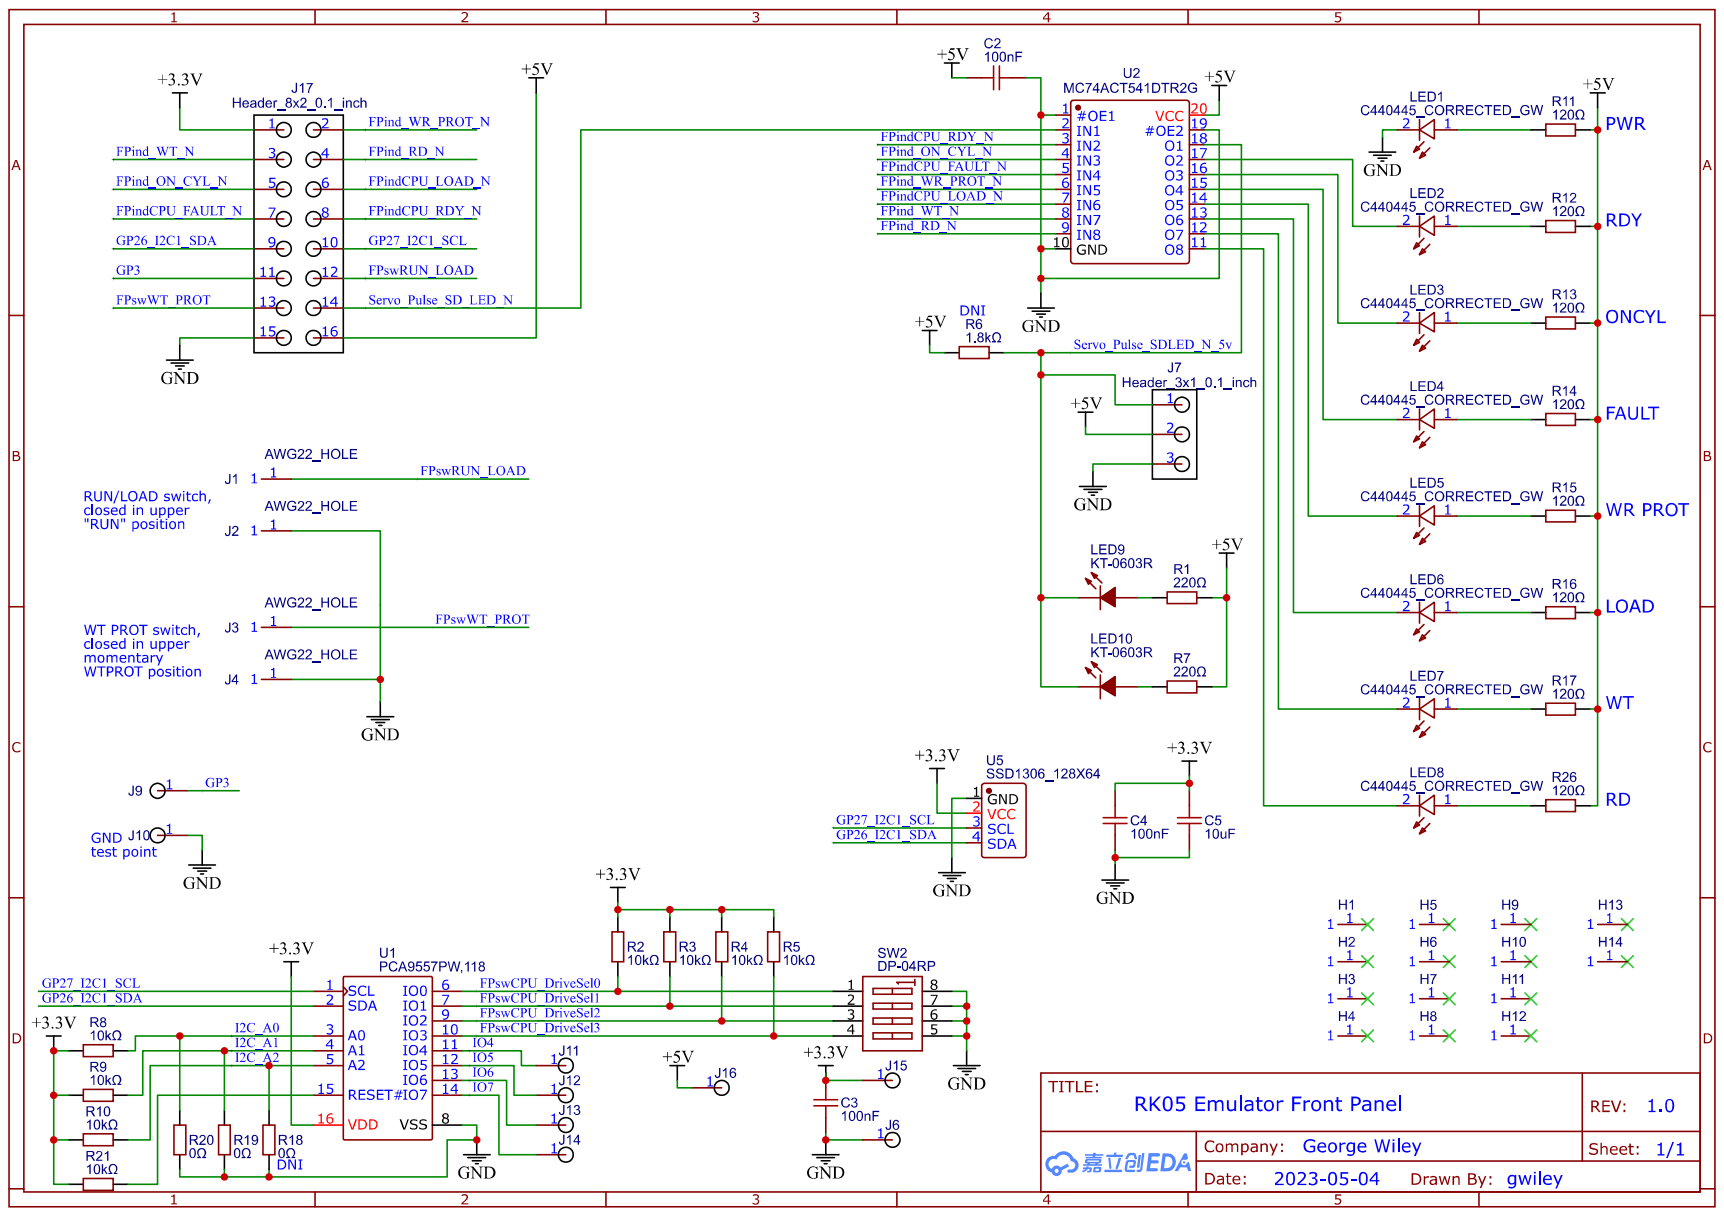
[picture p55: page 1]
