G-Wiley/RK05_Emulator_Tester_System_v1/A6_RK05_Tester_Cable_Adapter_Board_no_cables/RK05_Tester_Cable_Adapter_Board_v1/RK05_Tester_Cable_Adapter_Board_v1_schematic.pdf

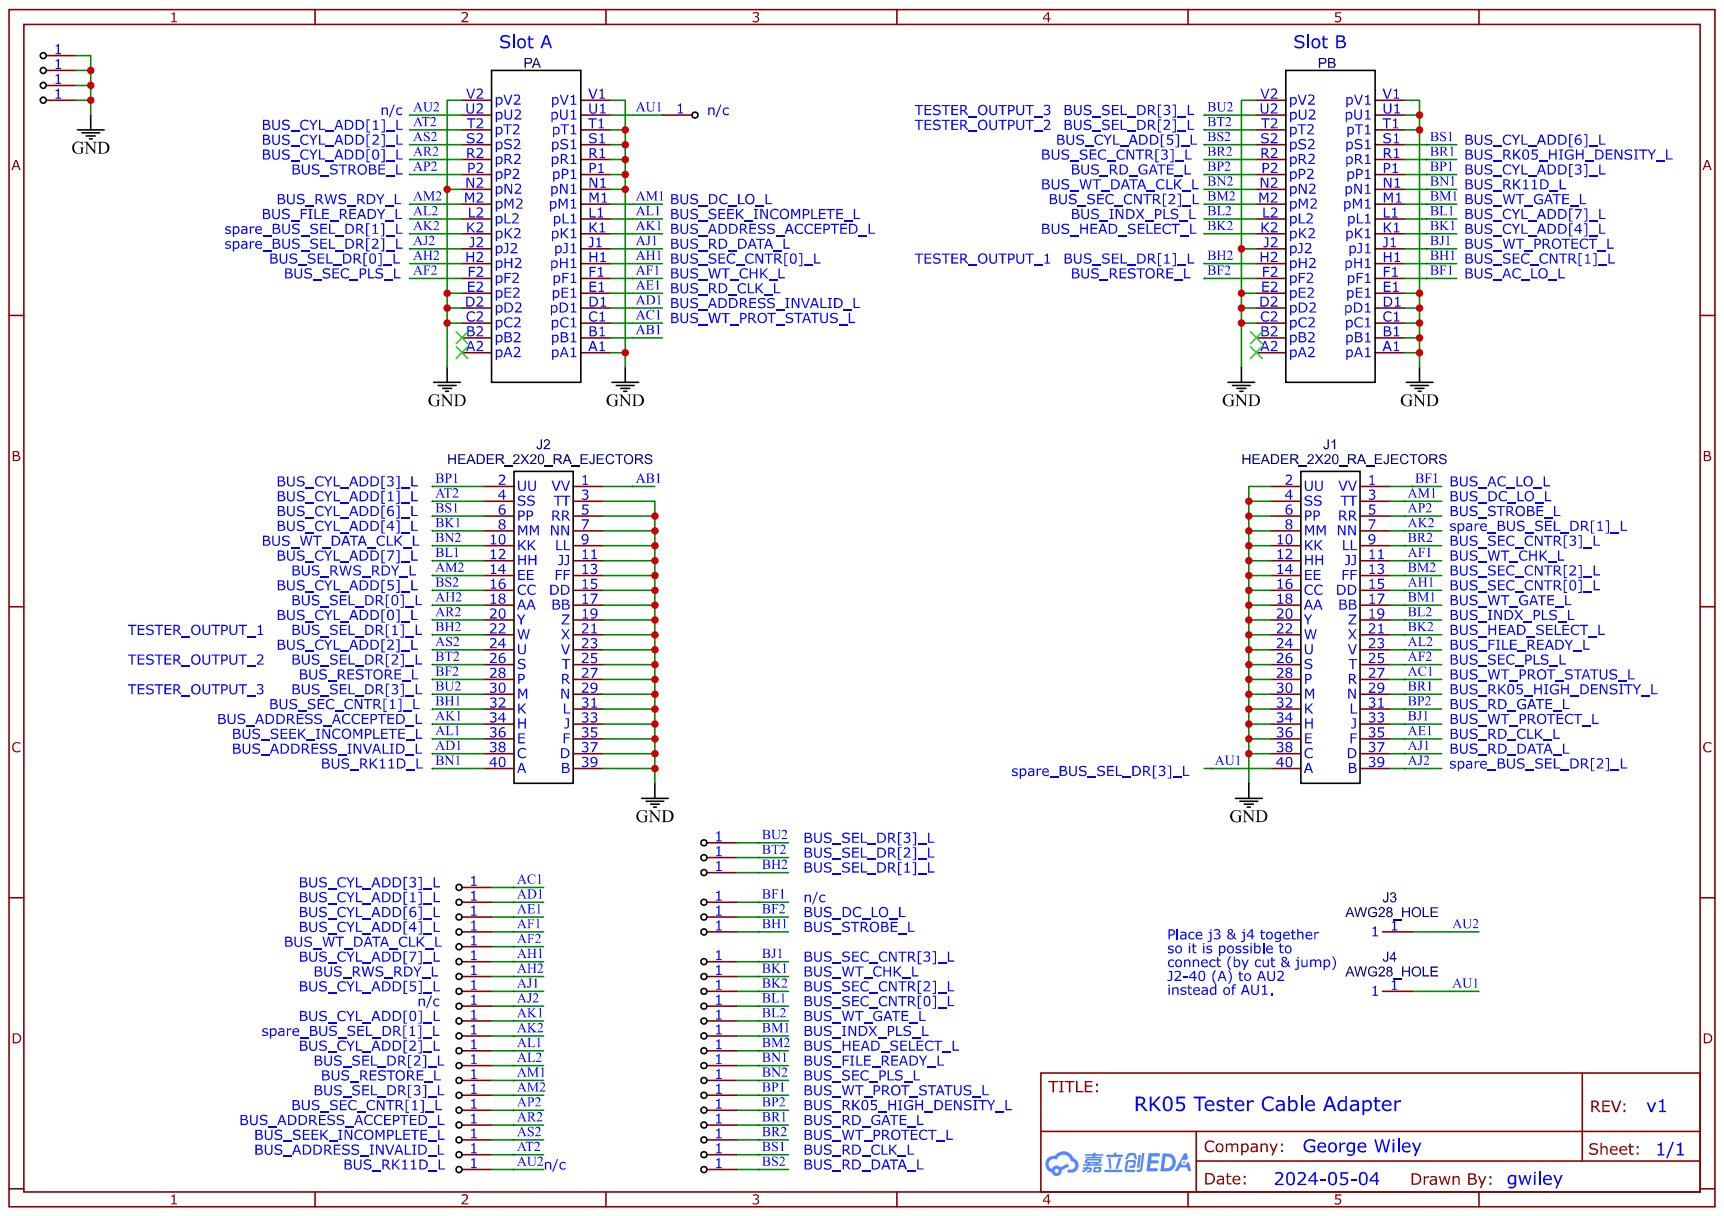
[picture p56: page 1]
