G-Wiley/RK05_Emulator_Tester_System_v1/A7_RK05_Emulator_Power_Supply/RK05_Emulator_Power_Supply_v2/RK05_Emulator_Power_Supply_v2_schematic.pdf

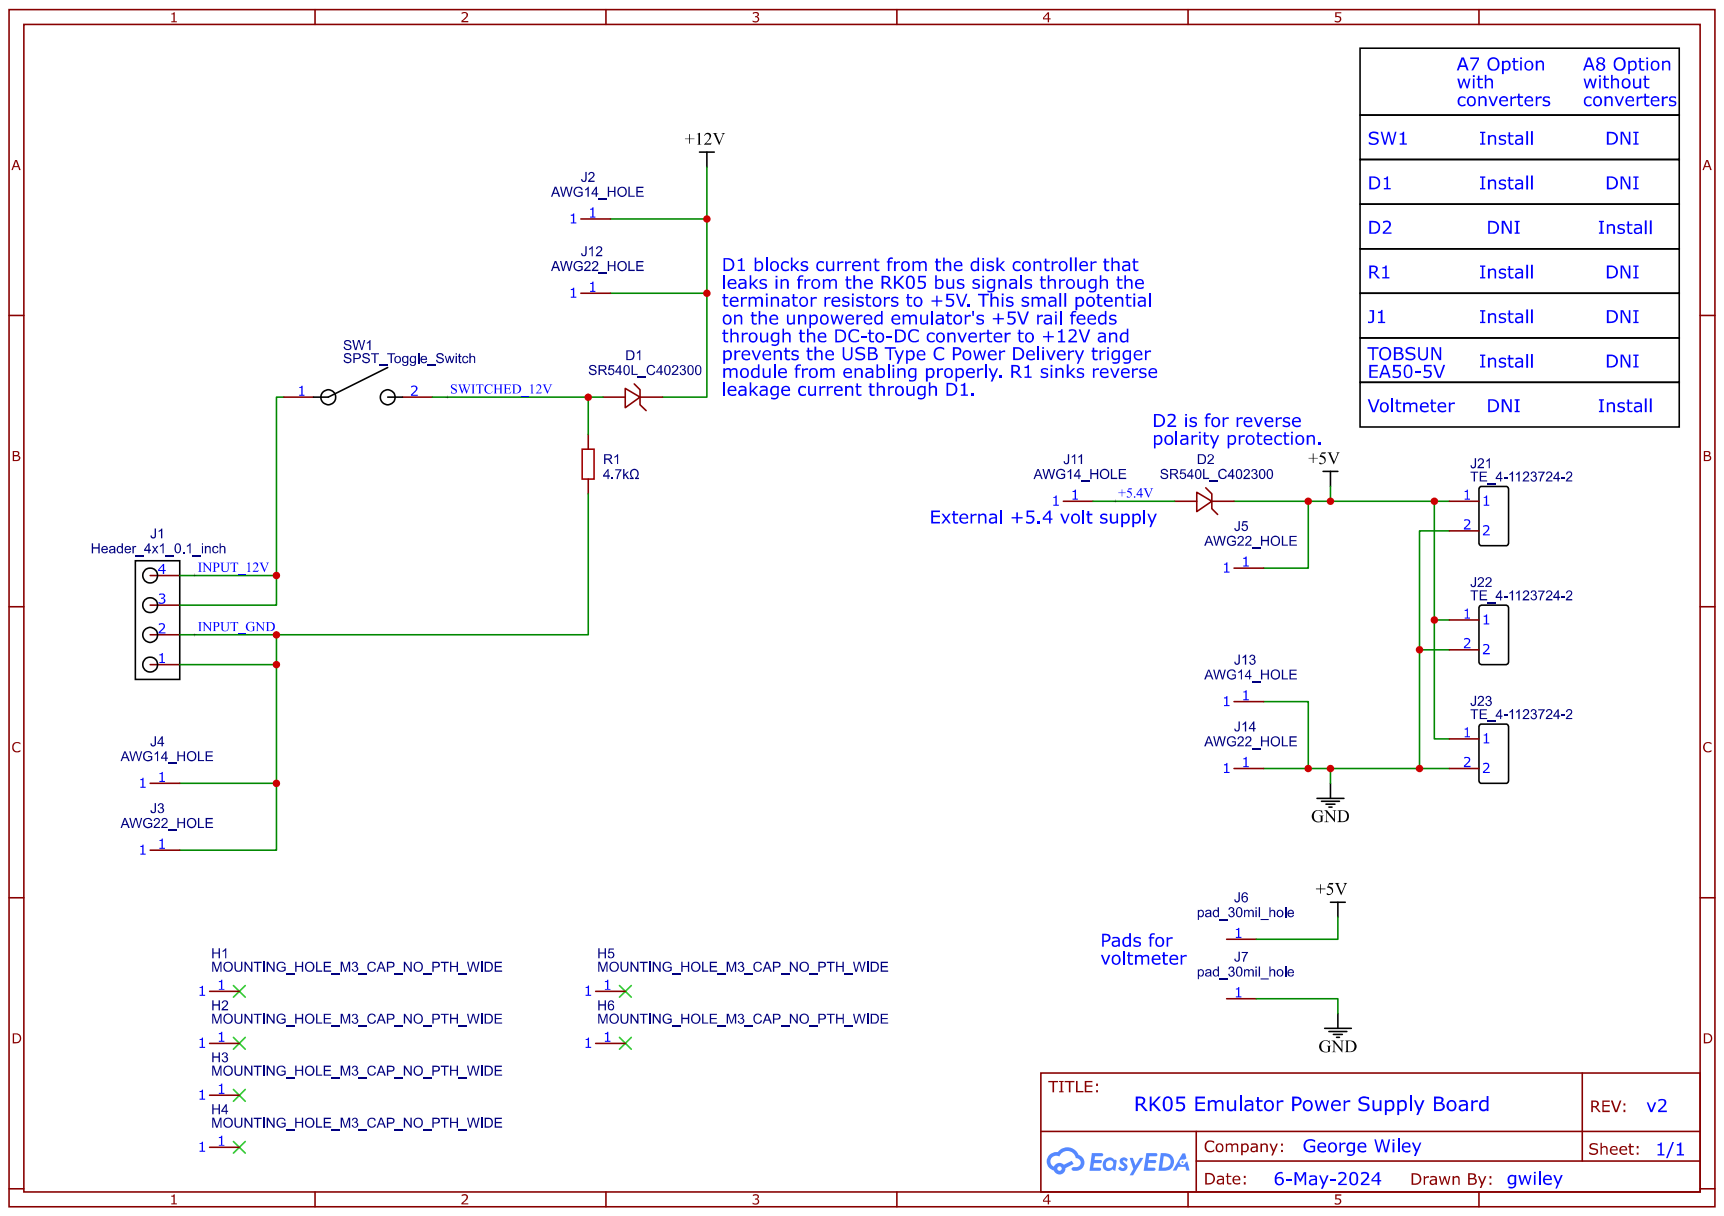
[picture p57: page 1]
