G-Wiley/RK05_Emulator_Tester_System_v1/A4_RK05_Adapter_Board_no_cables/M993GW_Adapter_Board_v2/M993GW_Adapter_Board_v2_schematic.pdf

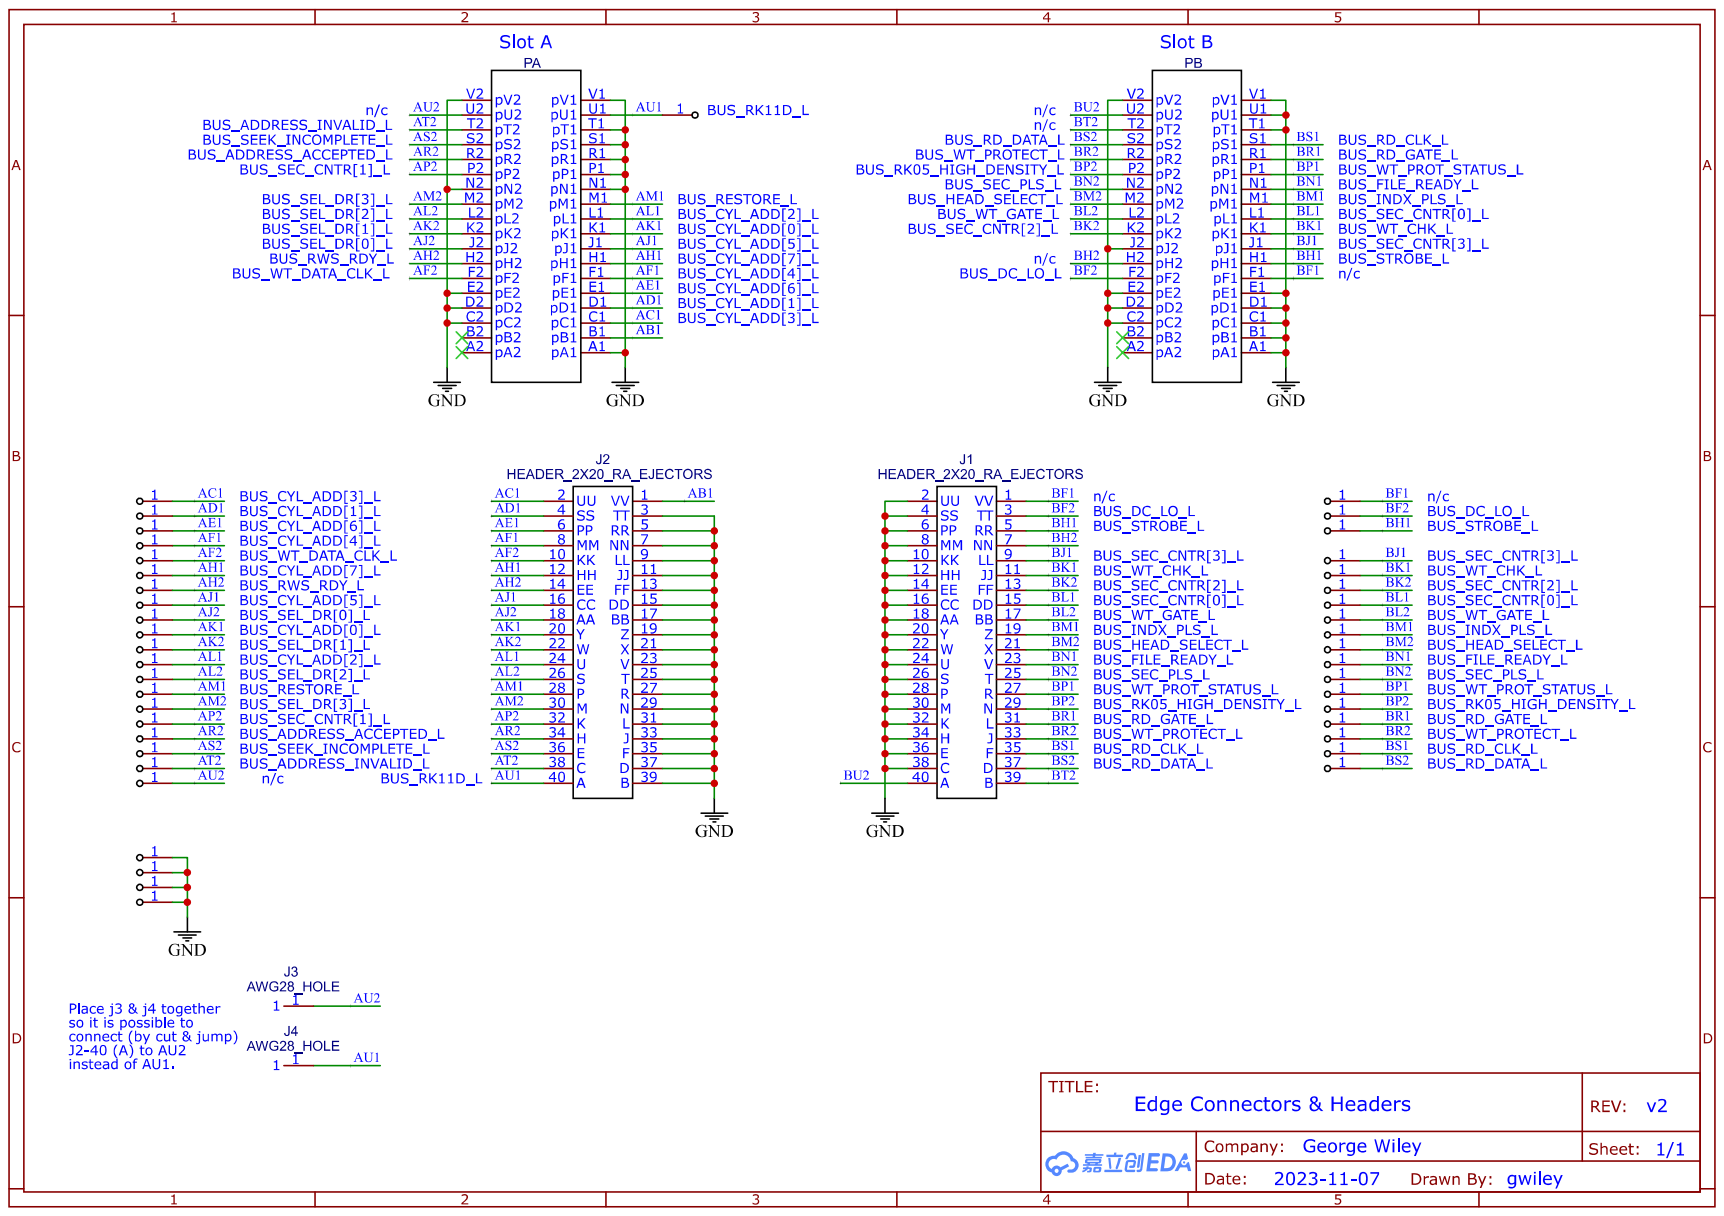
[picture p58: page 1]
