G-Wiley/RK05_Emulator_Tester_System_v1/E1_RK05_Emulator_Tester/Board_Front_Panel/RK05_Front_Panel v3/RK05_emulator_Front_Panel_schematic_v3.pdf

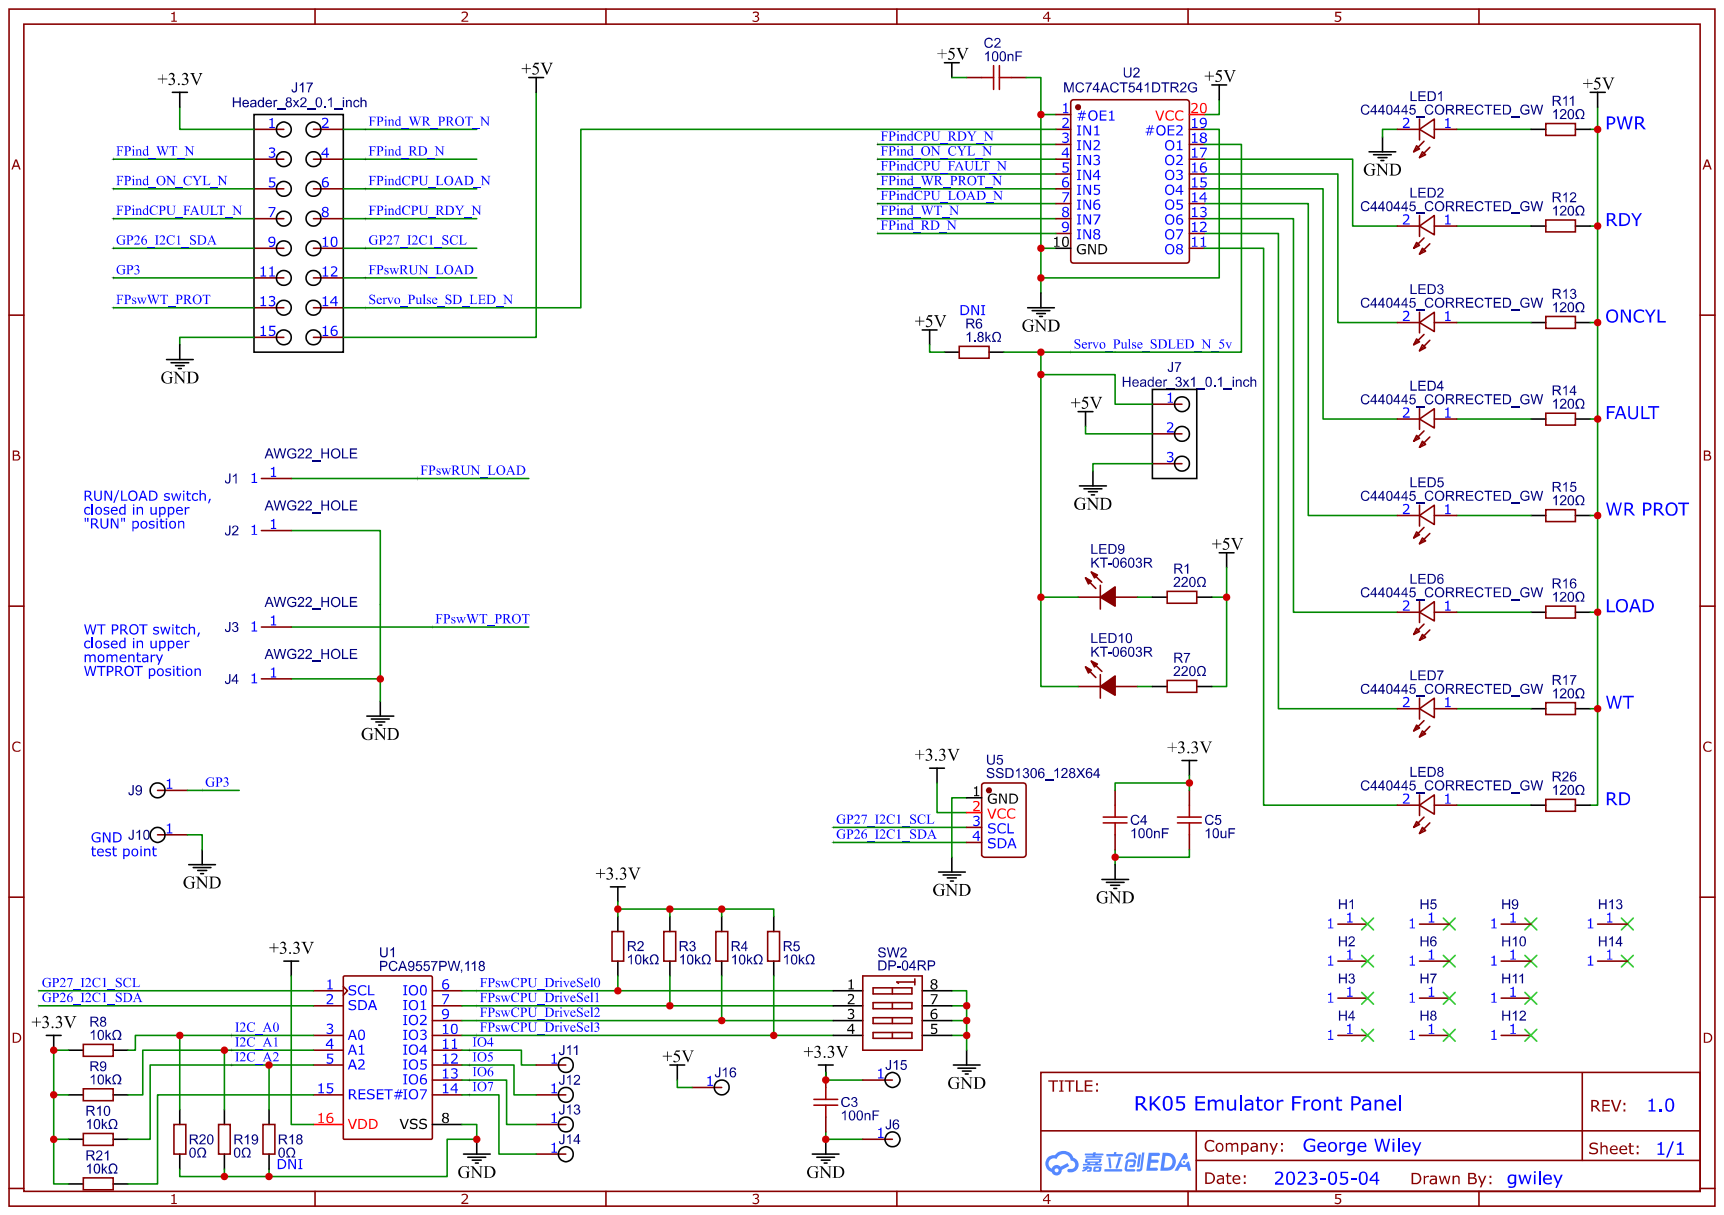
[picture p59: page 1]
