G-Wiley/RK05_Emulator_Tester_System_v1/E1_RK05_Emulator_Tester/Board_Main/RK05_emulator_main_board_v1/RK05_emulator_Main_Board_schematic_v1.pdf

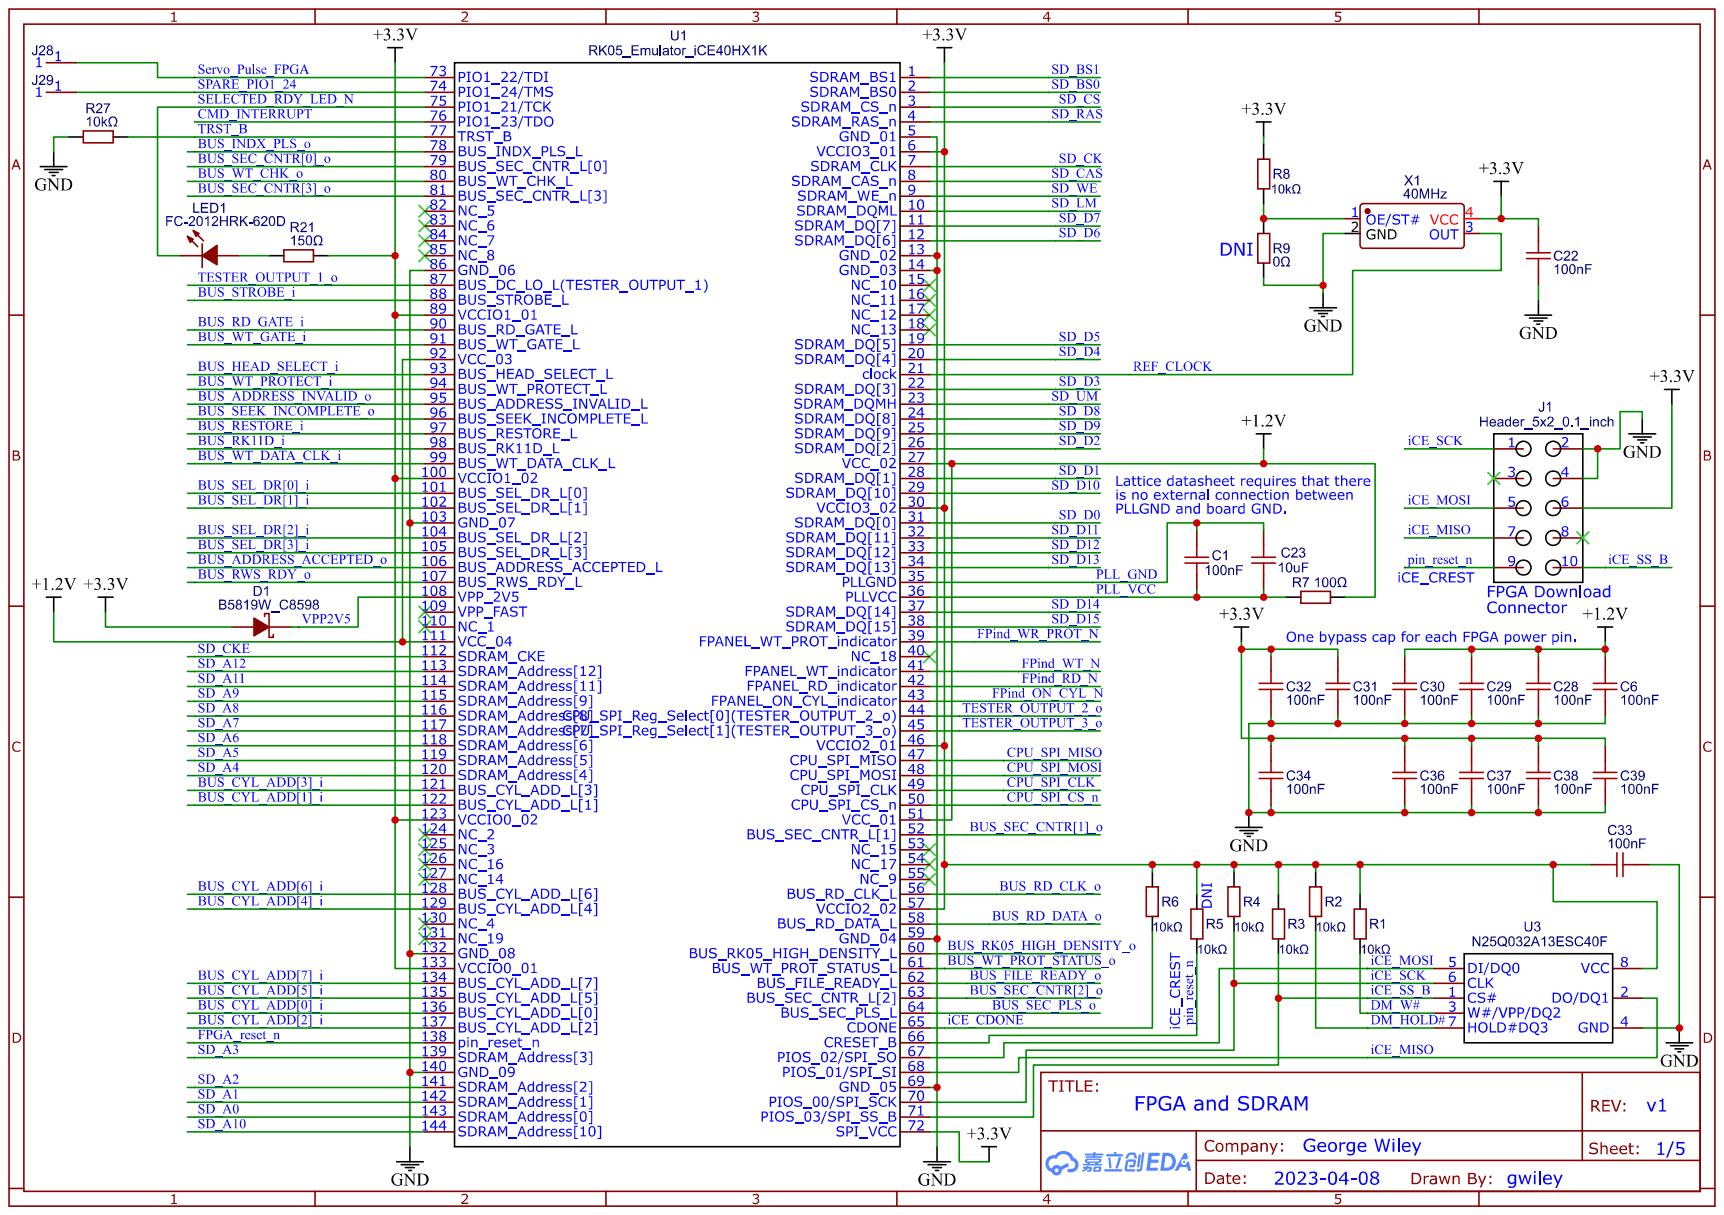
[picture p60: page 1]

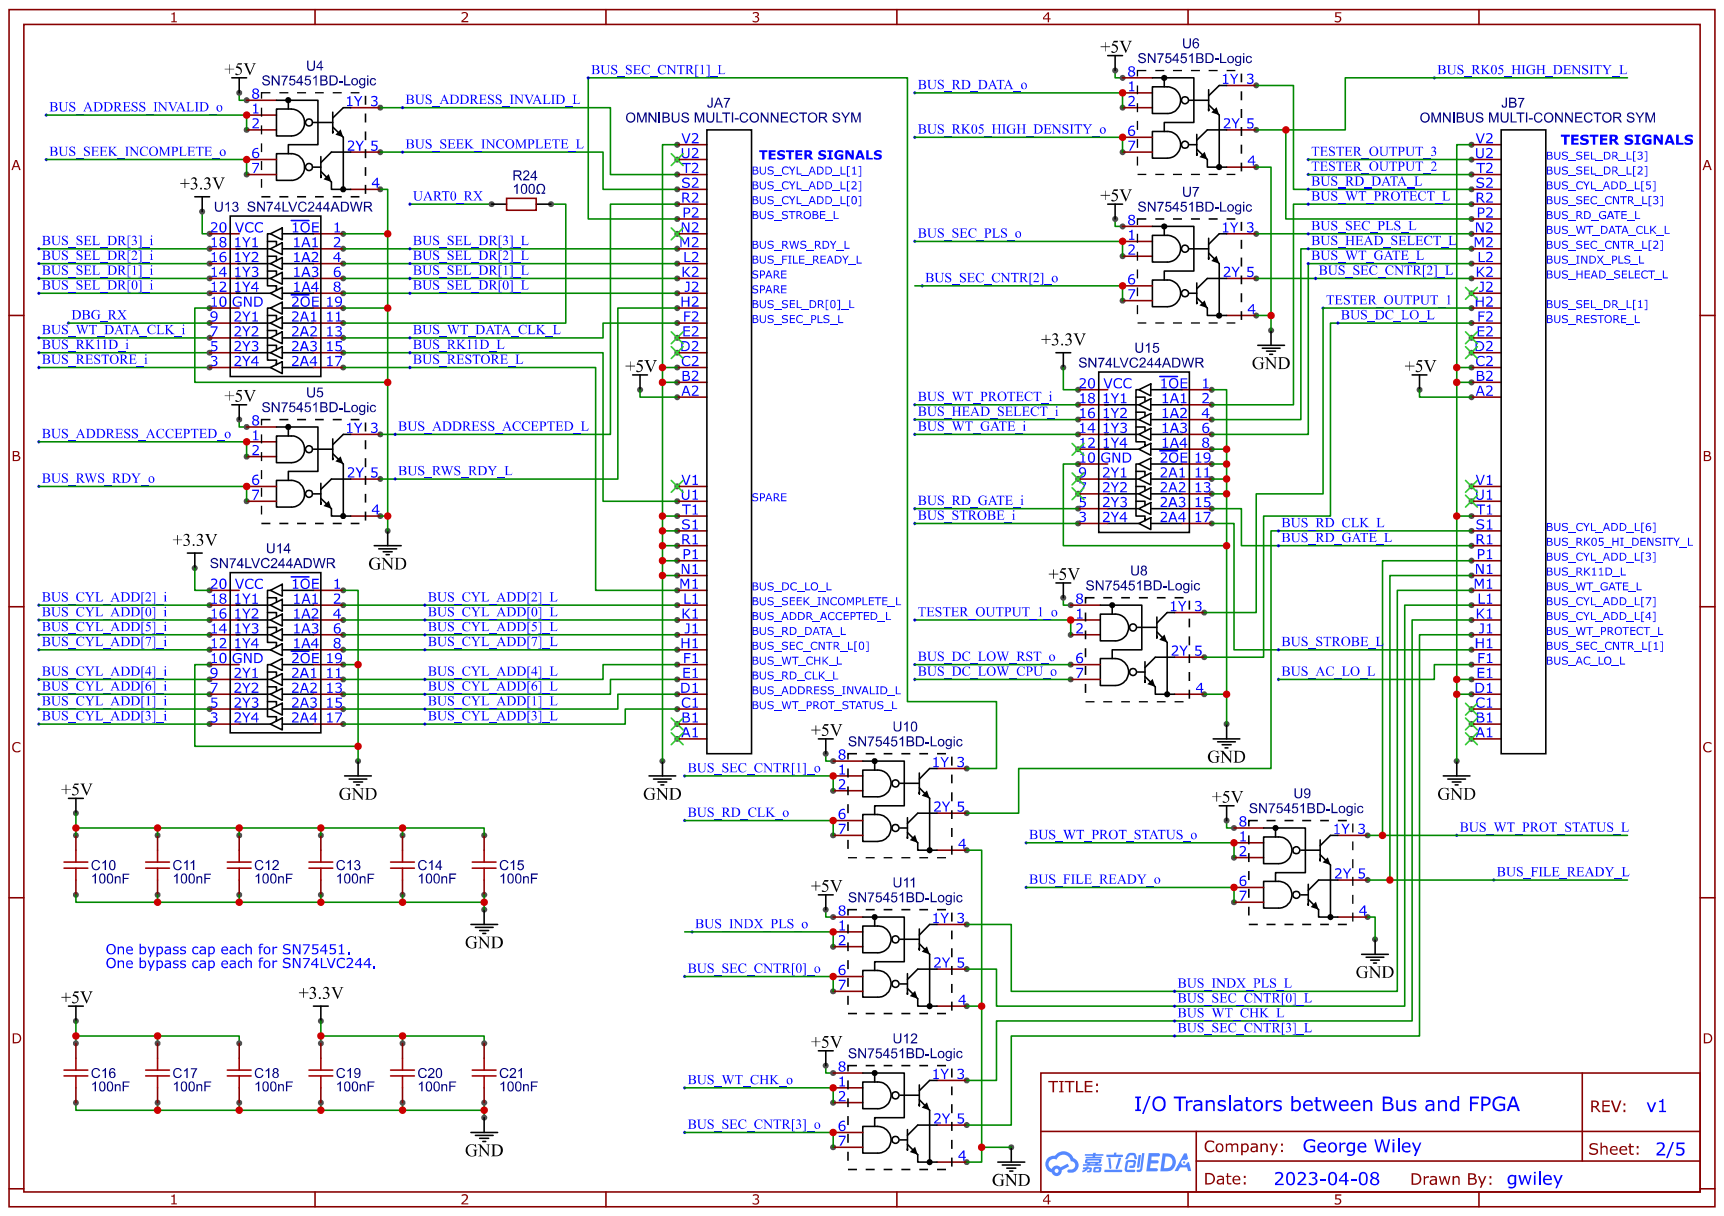
[picture p61: page 2]

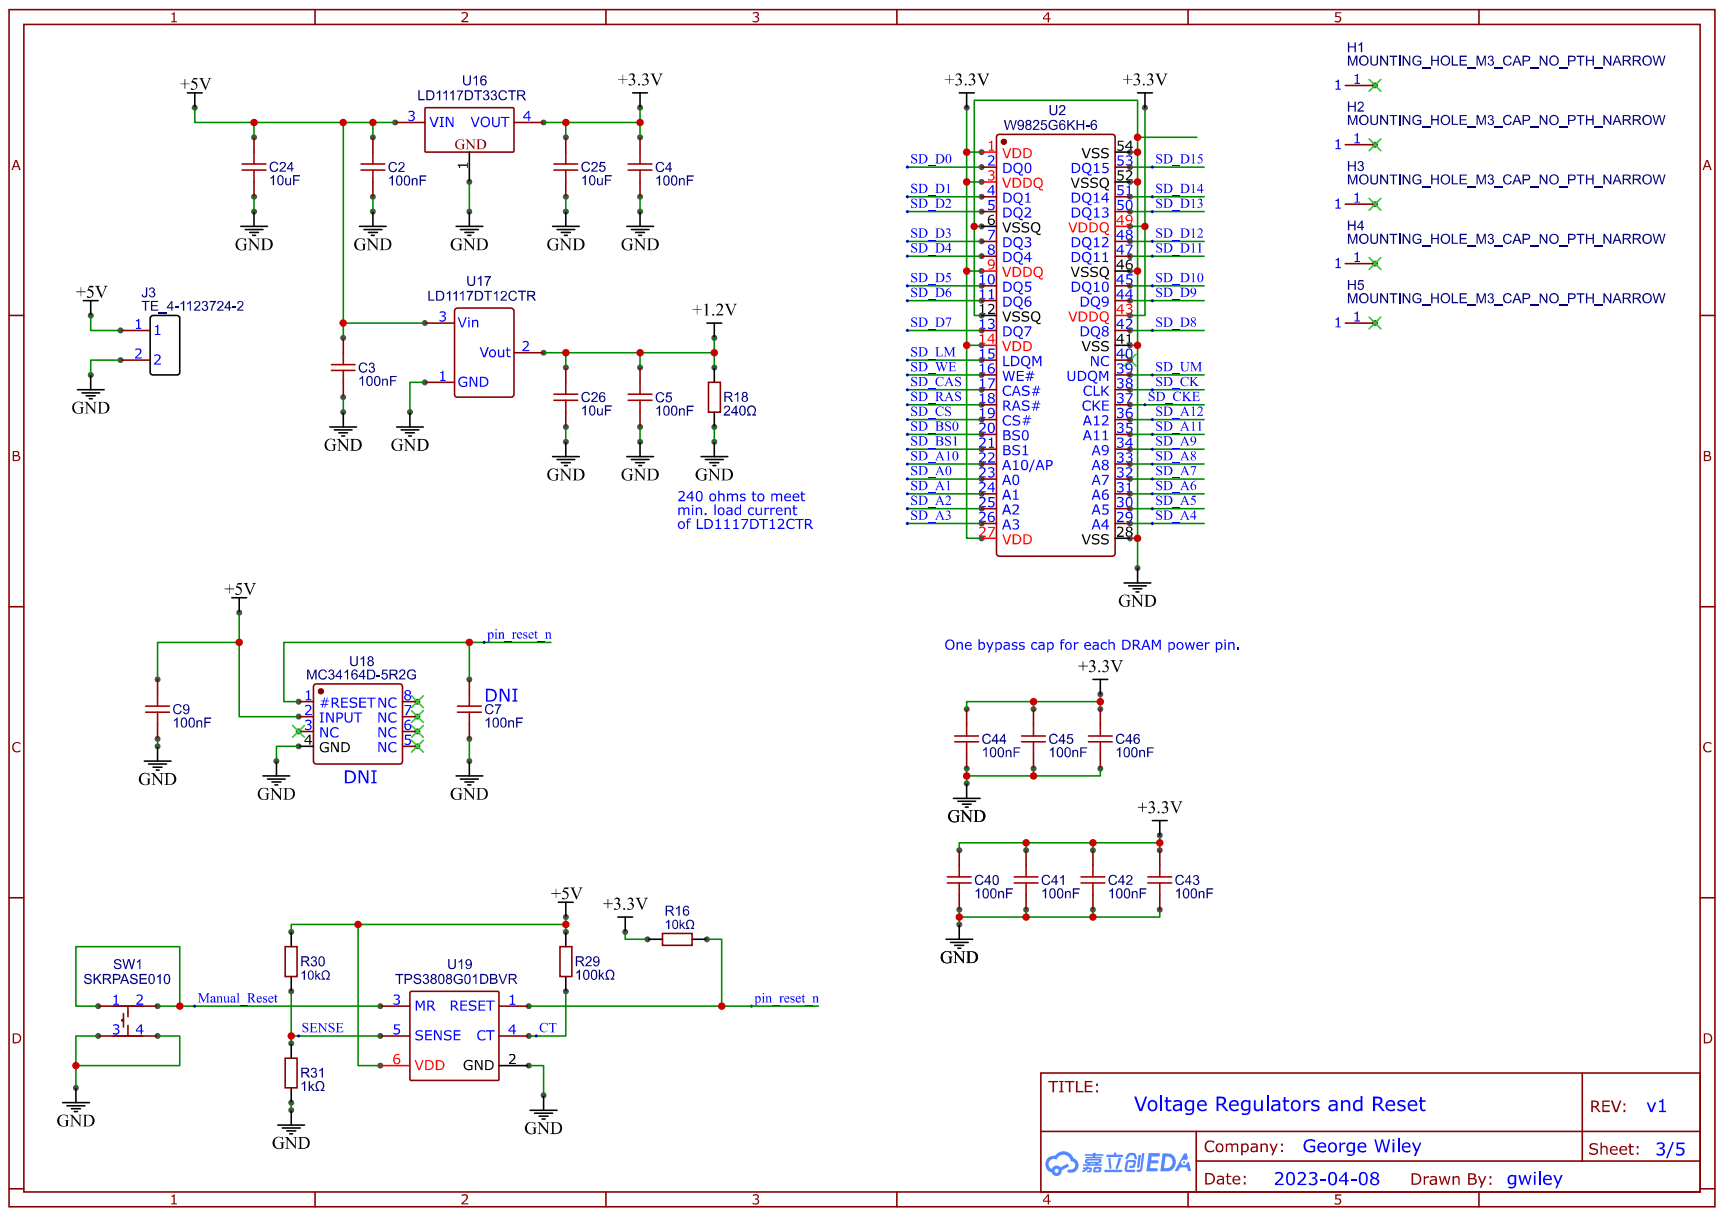
[picture p62: page 3]

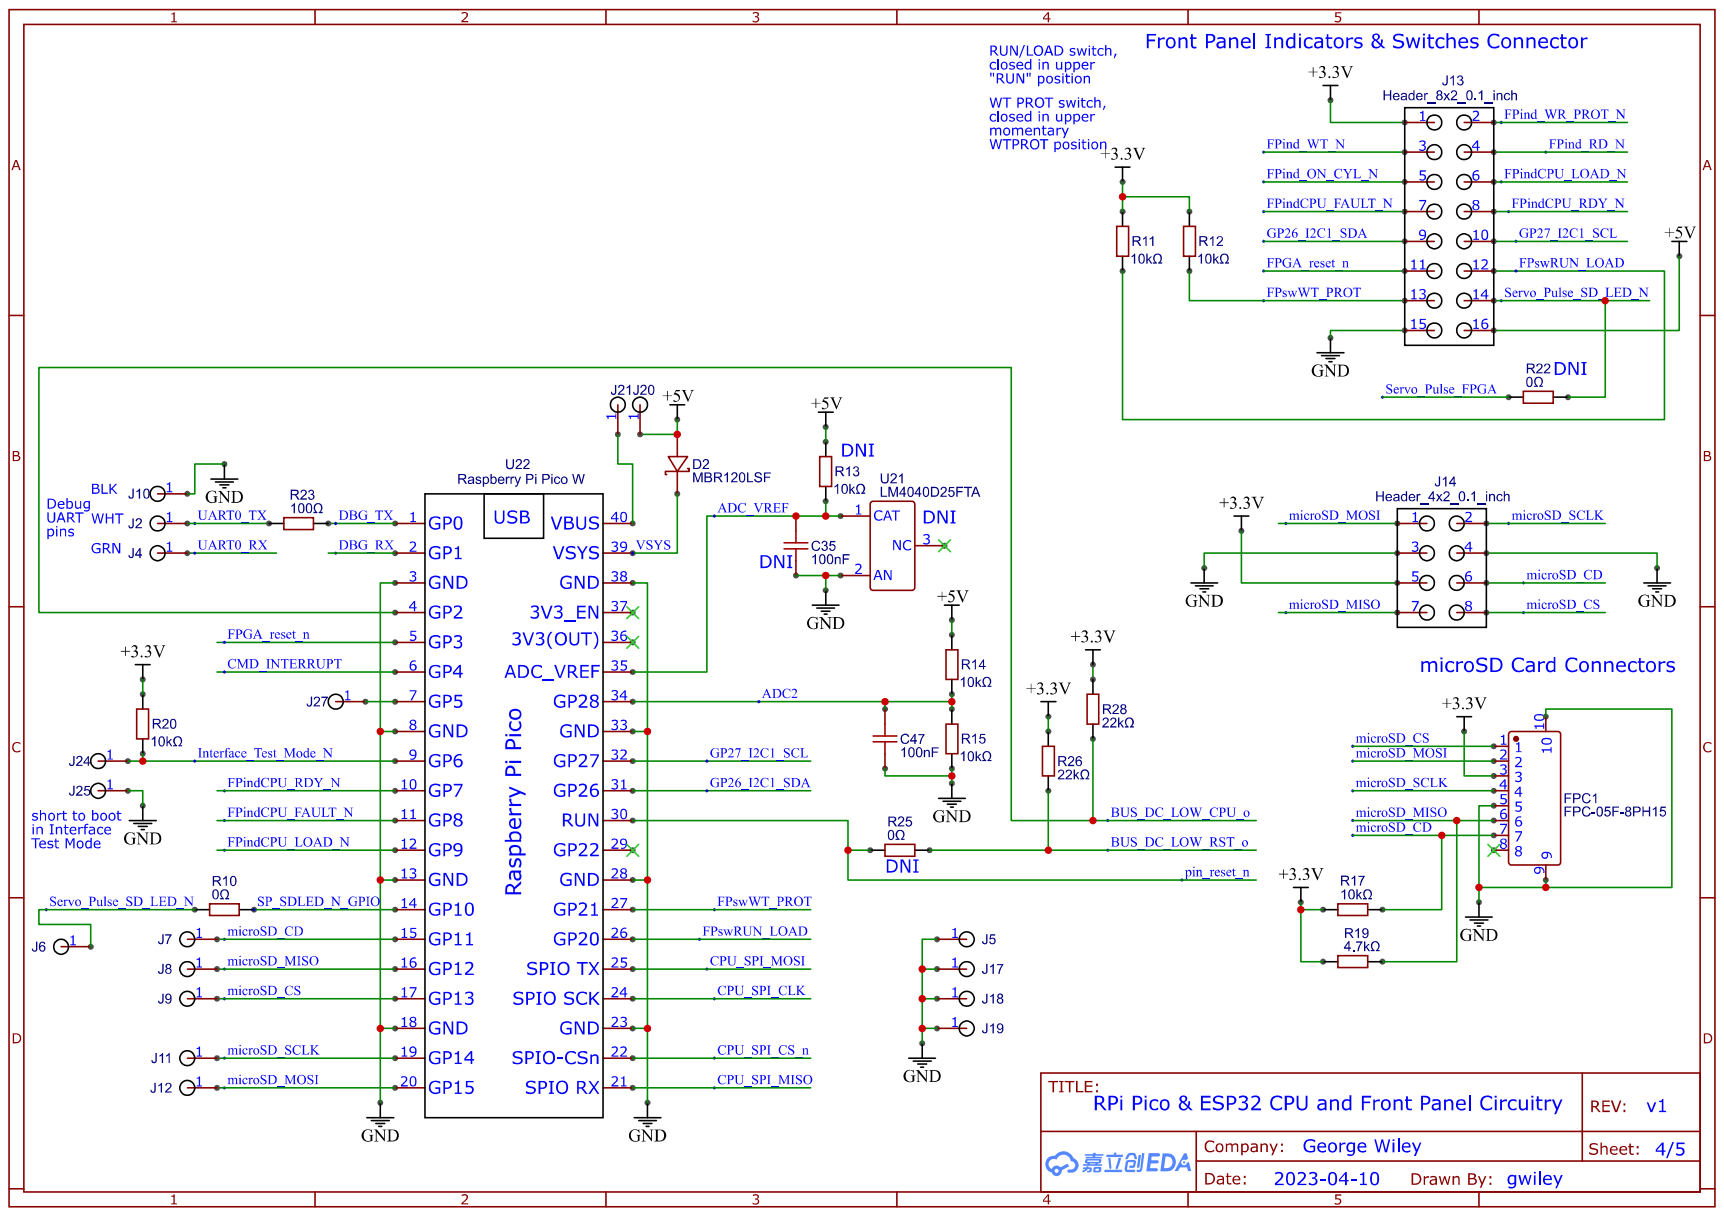
[picture p63: page 4]

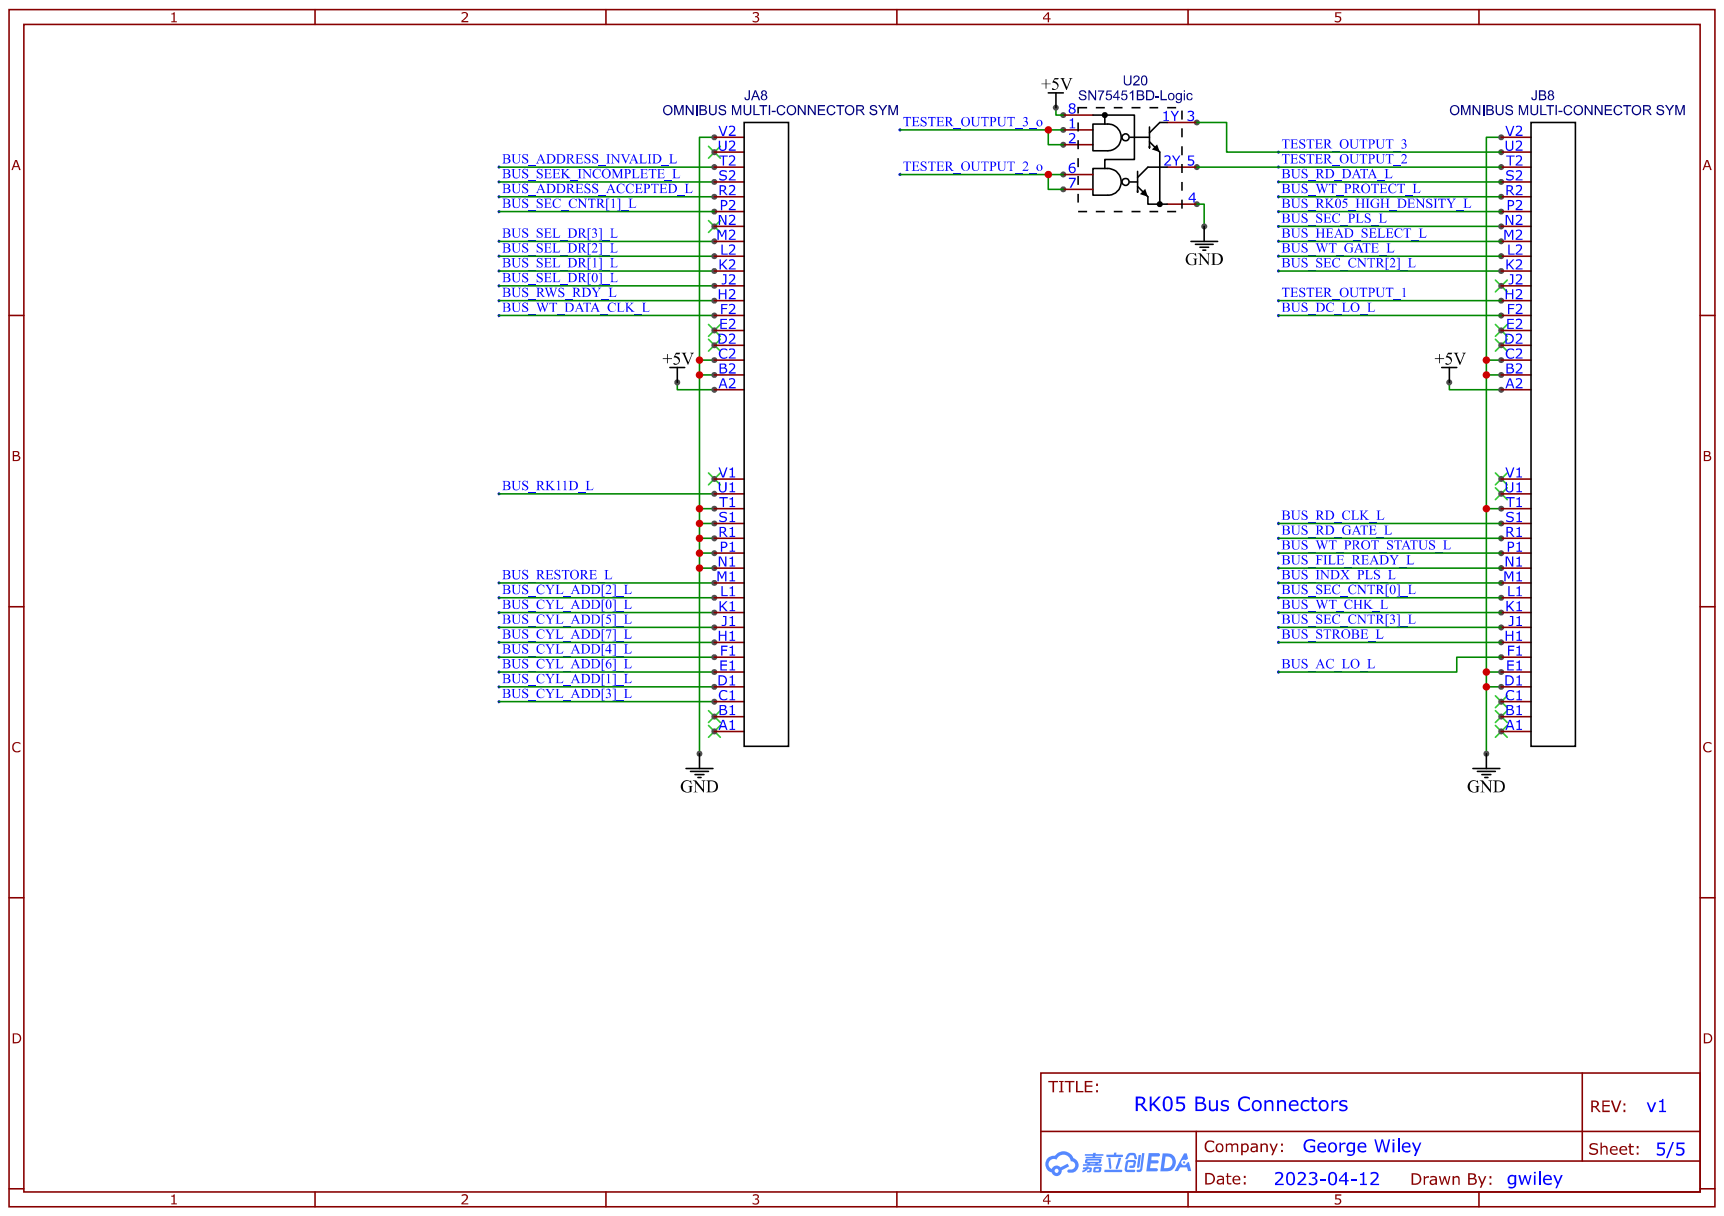
[picture p64: page 5]
