G-Wiley/RK05_Emulator_Tester_System_v1/E1_RK05_Emulator_Tester/Board_microSD_adapter/RK05_emulator_microSD_board_v1/RK05_emulator_microSD_Adapter_Board_schematic_v1.pdf

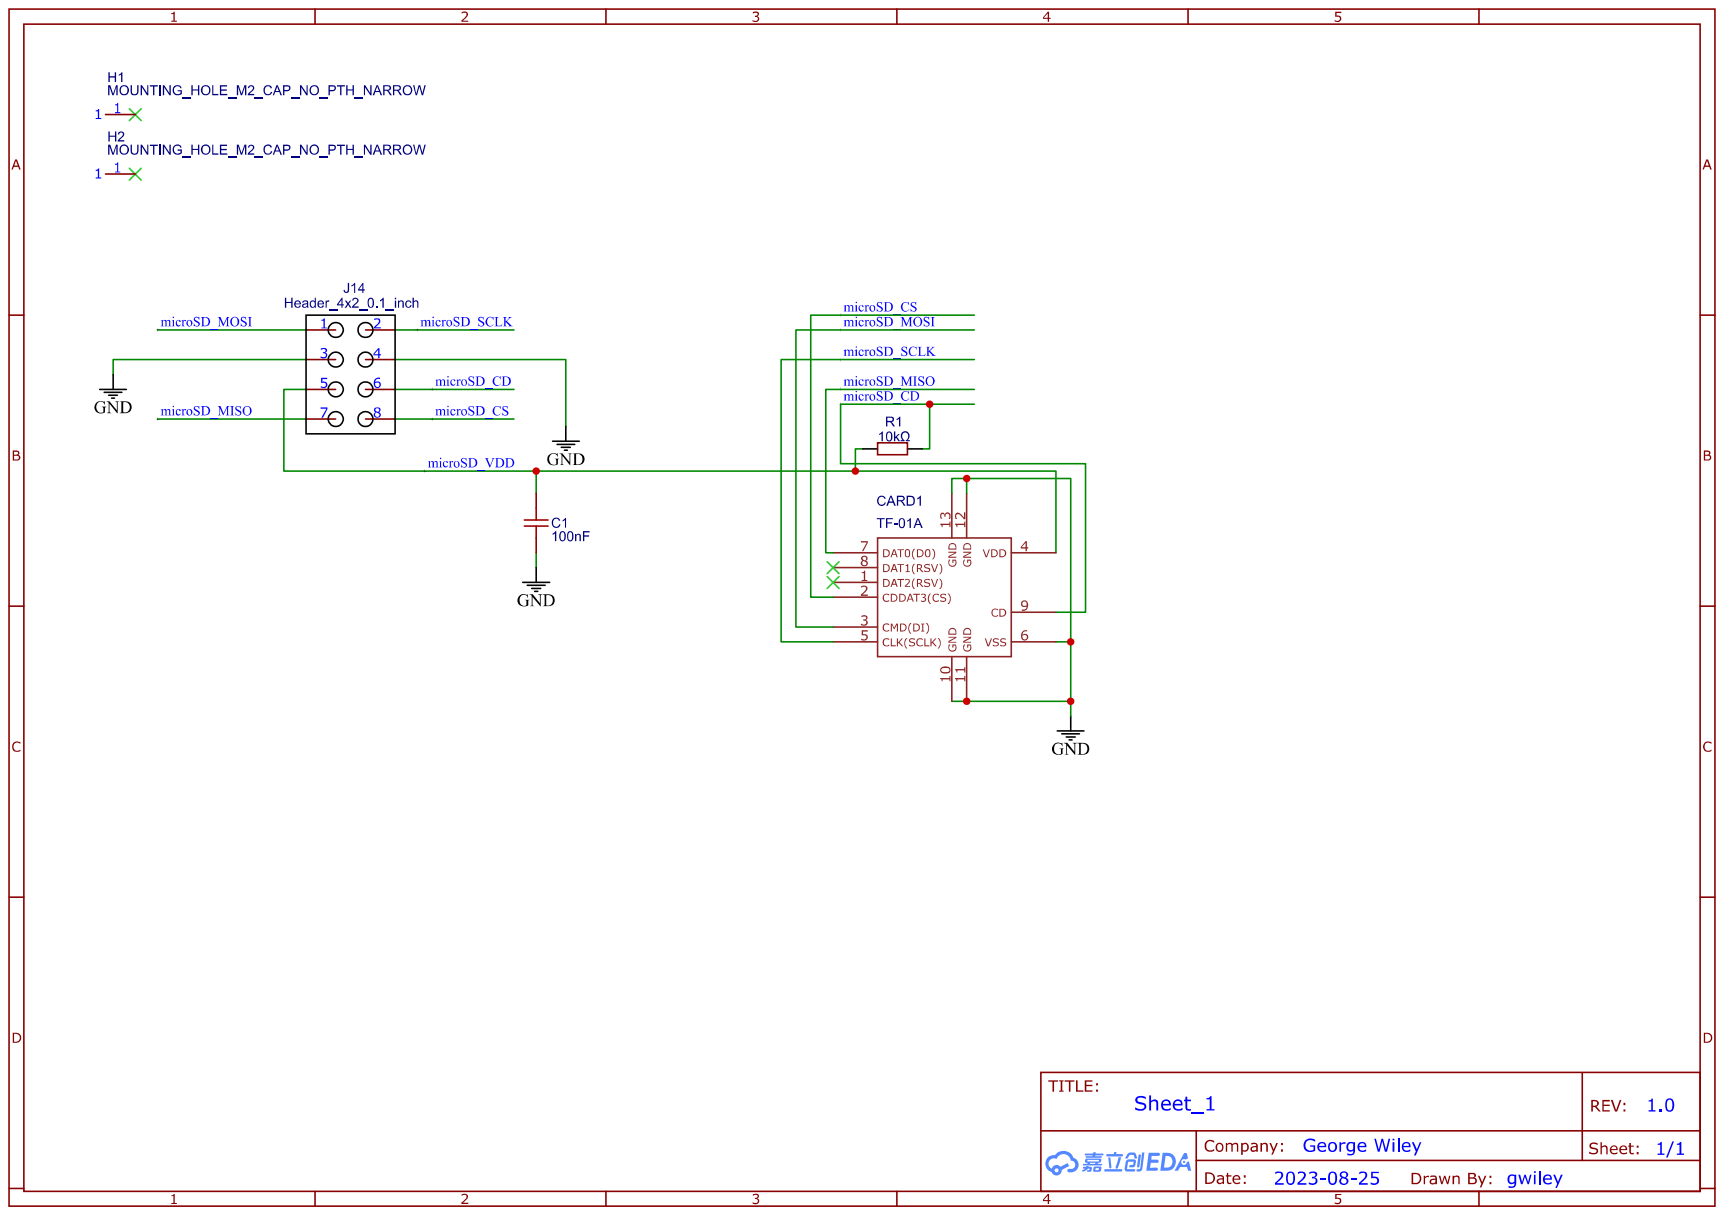
[picture p65: page 1]
