G-Wiley/RK05_Emulator_Tester_System_v1/A4_RK05_Adapter_Board_no_cables/M993GW_Adapter_Board_v1/M993GW_Adapter_Board_v1_schematic.pdf

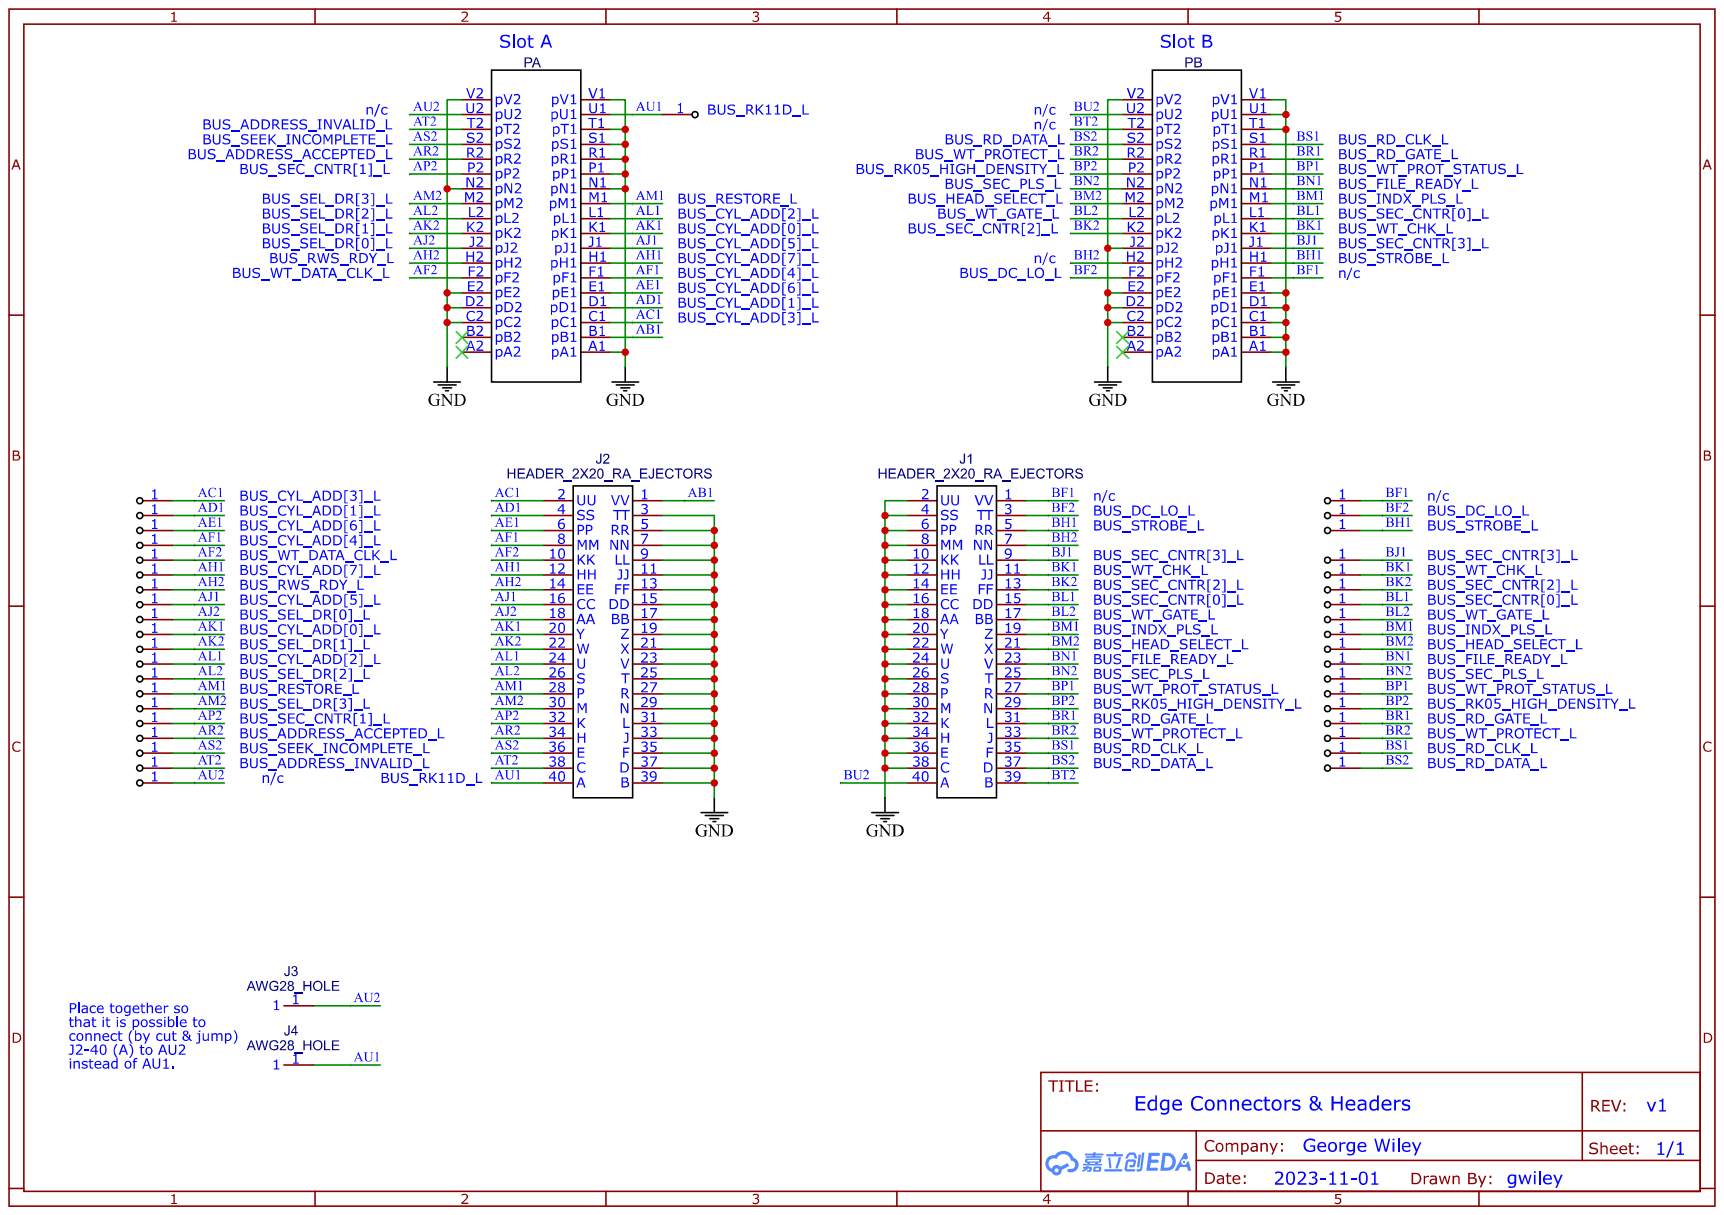
[picture p66: page 1]
