G-Wiley/RK05_Emulator_Tester_System_v1/(commit log)

2024-05-15 Delete E1_RK05_Emulator_Tester/3D_printed_parts/_RK05 Emulator 3D Printed Part Ordering Instructions.pdf
    updating to v01 to correct mistake in part 207 material
2024-09-26 updated lamp lens
    updated lamp lens with spherical inside surface for better light dispersion
    [200_RK05_Lamp_Lens_v04.3mf, 200_RK05_Lamp_Lens_v04.stl]
2024-10-07 Add files via upload
    add ordering instructions and removed unused parts from the pick-and-place file
    [PickAndPlace_PCB_RK05 microSD board v1_2024-01-14a.csv]
